KuroBean/SURF-git/my writing/ch 3x postlab 3 - Google Docs.pdf

### Experimental Section

First, the oscilloscope’s channel 2 was connected to the laser module’s sync jack to identify the trigger signal. The horizontal scale was adjusted to 1 us per grid, the voltage scale was autoranged, and was set so the oscilloscope triggers on rising laser module sync voltage so the measurement happens after the laser turns off. Then, the trigger frequency was recorded to be about 1.044 kHz.
Then, the laser and sample holder was set up (as described in diagram below), first to check that we can see the laser turn on and off through scattered laser light. A piece of tape was put on an empty sample tube to do this, and the photodiode detector signal was connected to ch1 of the oscilloscope. A square signal was successfully observed with this method.
The following solutions were mixed using micro-pipettes and stock solutions of 2.5mM Ru(bpy)3, 1.25 methyl viologen dichloride (quencher), and 0.5M of sulfuric acid:

Table 1: volumes of stock solutions needed to create each solution with varying quencher concentrations, along with their total concentrations

Each sample was put in a NMR tube and placed into the laser setup, slightly realigning the angle of the detector such that a “shark fin” pattern is visible. There were also vertical rises and drops due to the reflected laser light entering the detector instead of phosphorescent light, which had to be accounted for by adjusting the detector position.

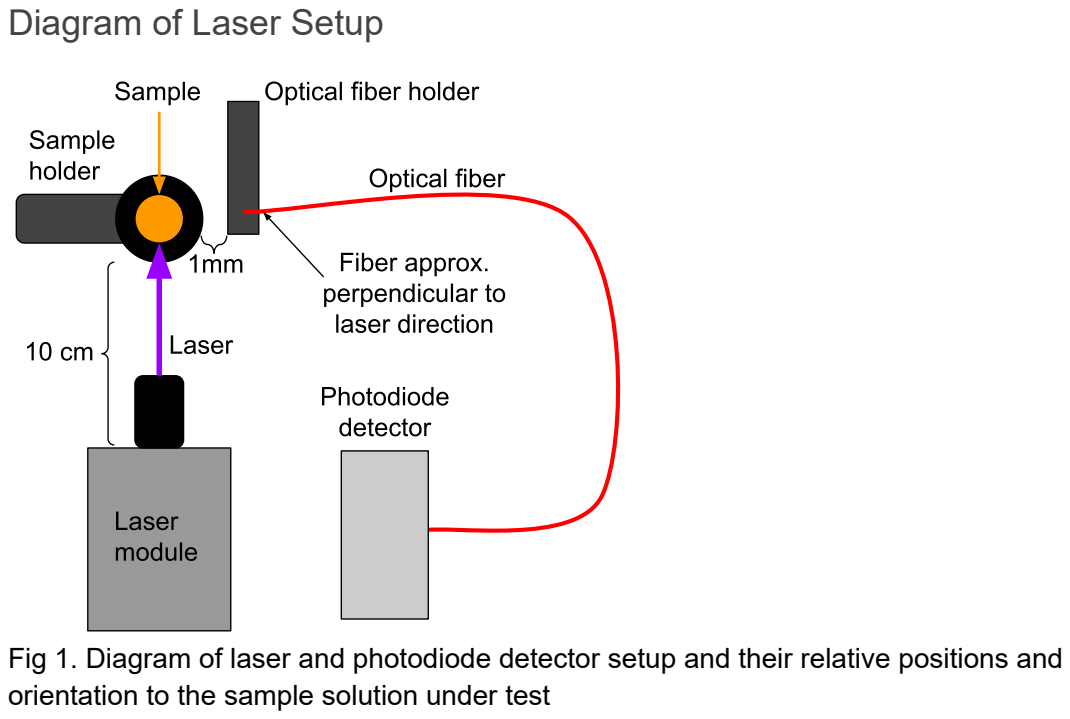
[picture p40: page 2]

Diagram of Laser Setup

Fig 1. Diagram of laser and photodiode detector setup and their relative positions and
orientation to the sample solution under test

### Data Analysis

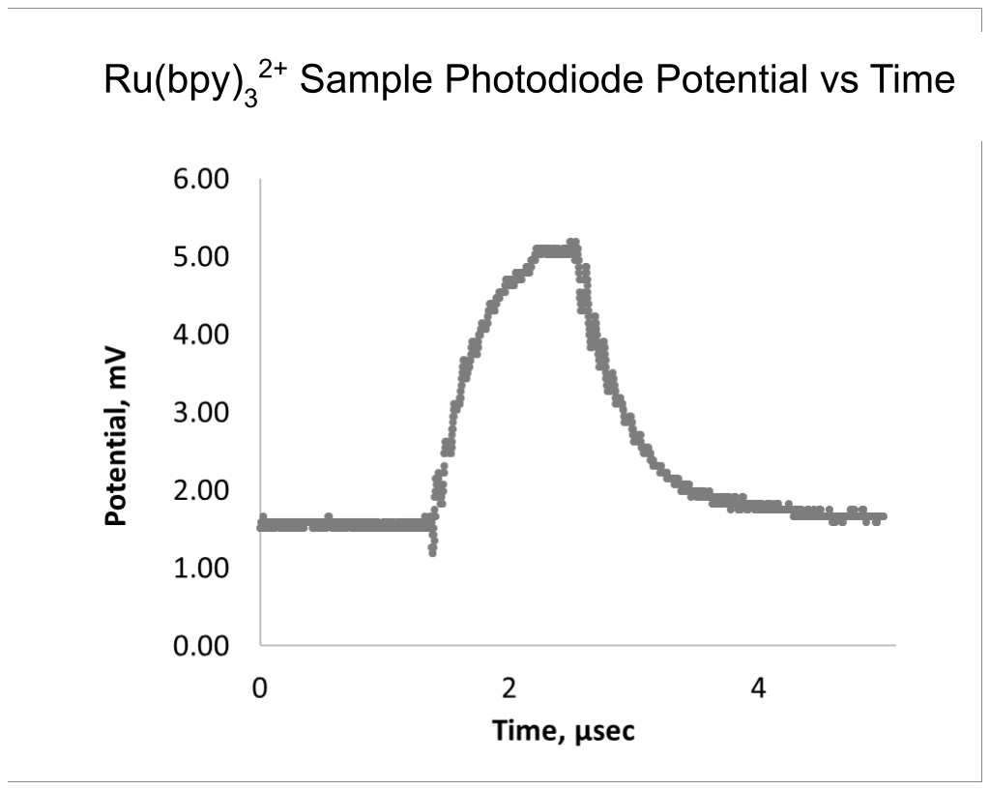
[picture p41: figure]

Fig 2. Phosphorescence over time of a Ru(bpy)3

2+ sample with no quencher exposed to a short burst of laser, where the voltage and time values have been shifted for data analysis purposes such that the minimum voltage is above 1mV and time is positive

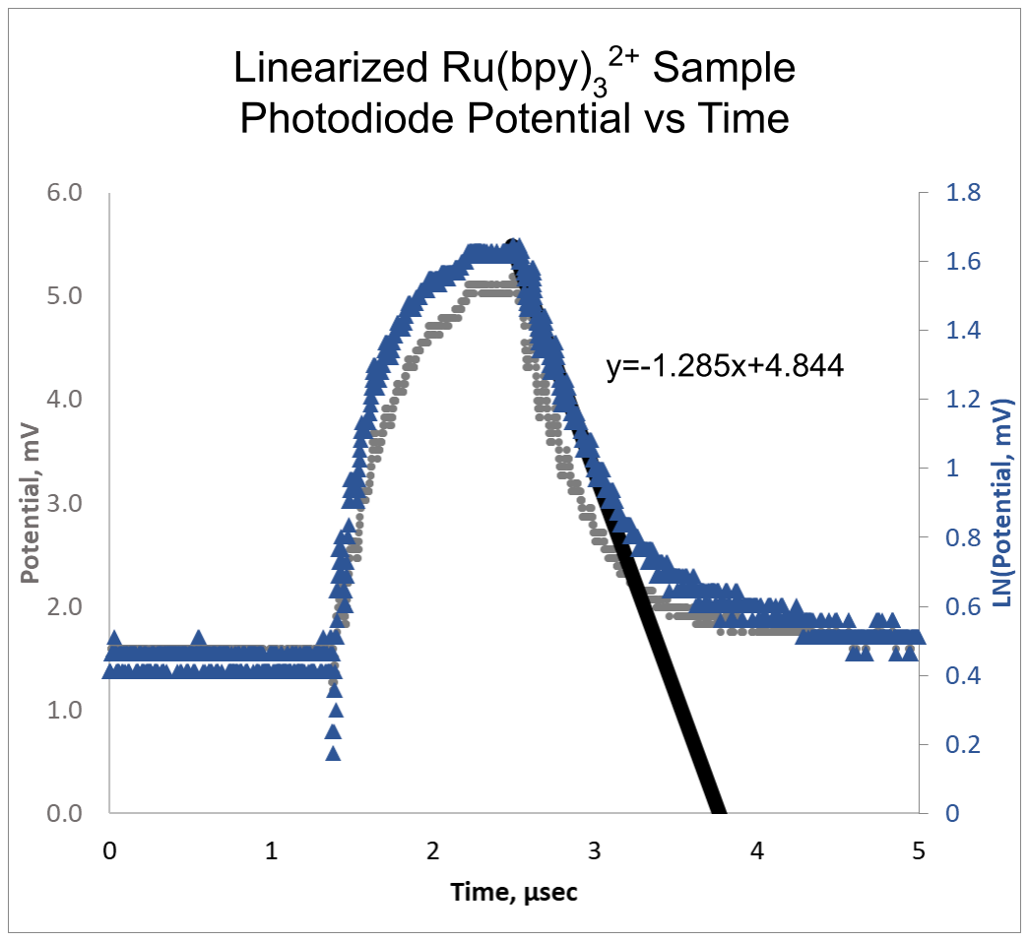
[picture p42: figure]

Fig 3. Phosphorescence over time of a Ru(bpy)3

2+ sample with no quencher, where data from Fig 2. has been transformed with the log function and the originally exponentially decaying segment (now linear) is fit to a line. The negative of the slope is the kobs

, the observed decay
rate, which is 1. 285 ± 0. 015

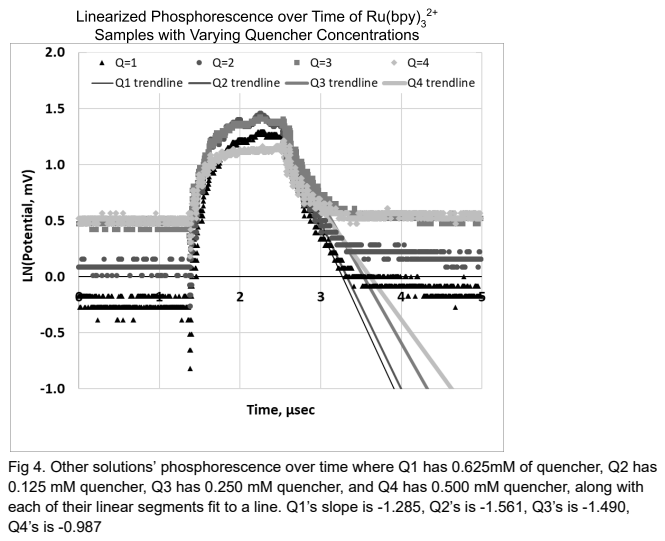
[picture p43: page 4]

Fig 4. Other solutions’ phosphorescence over time where Q1 has 0.625mM of quencher, Q2 has
0.125 mM quencher, Q3 has 0.250 mM quencher, and Q4 has 0.500 mM quencher, along with
each of their linear segments fit to a line. Q1’s slope is -1.285, Q2’s is -1.561, Q3’s is -1.490,

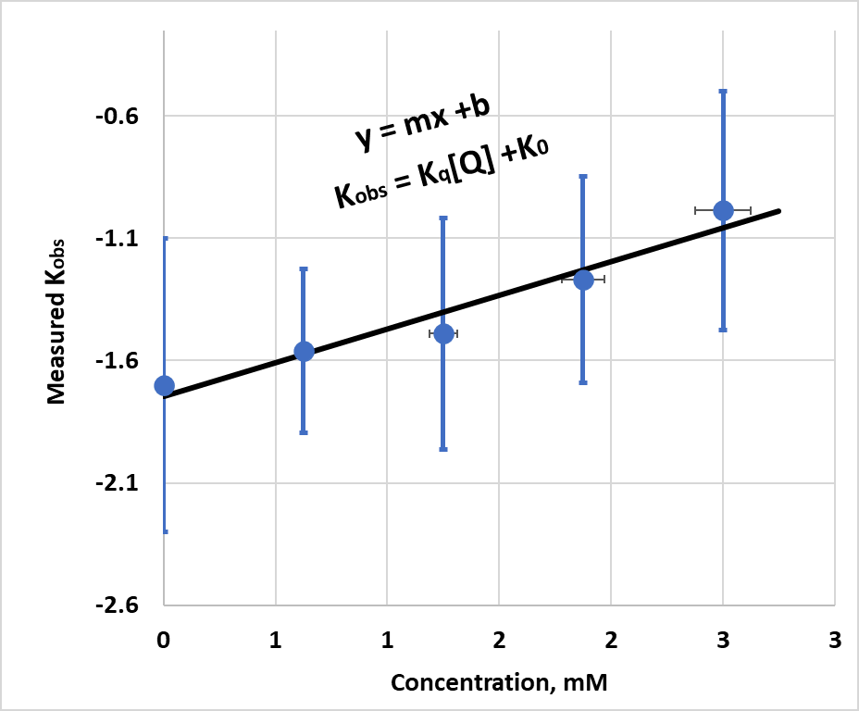
[picture p44: figure]

Fig 5. Kobs vs different quencher concentrations, where kq is 0.142 here
