KuroBean/SURF-git/forms/summer_project_primer.pdf

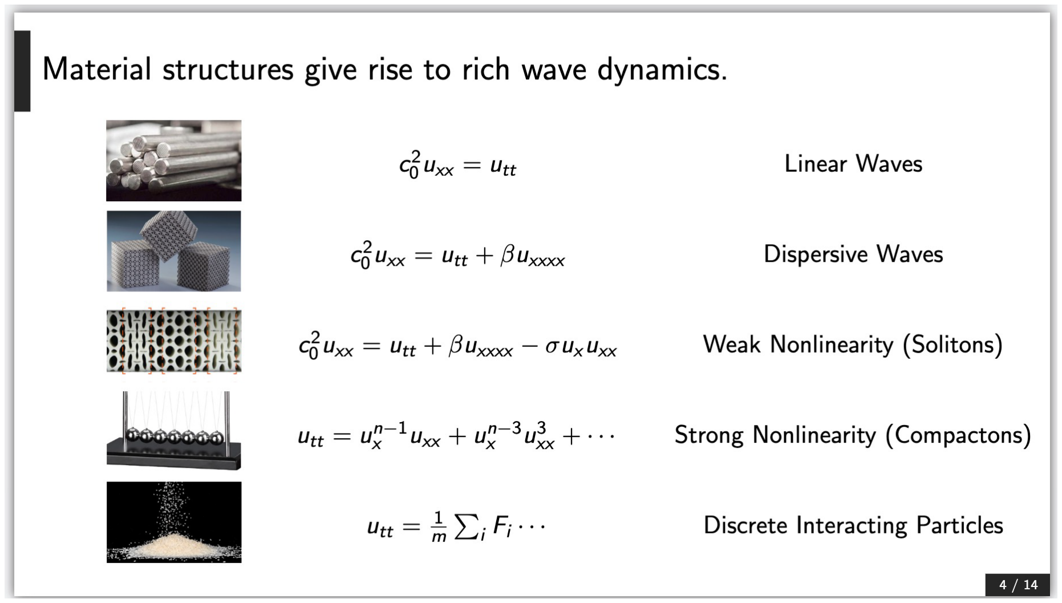
[picture p45: page 1]
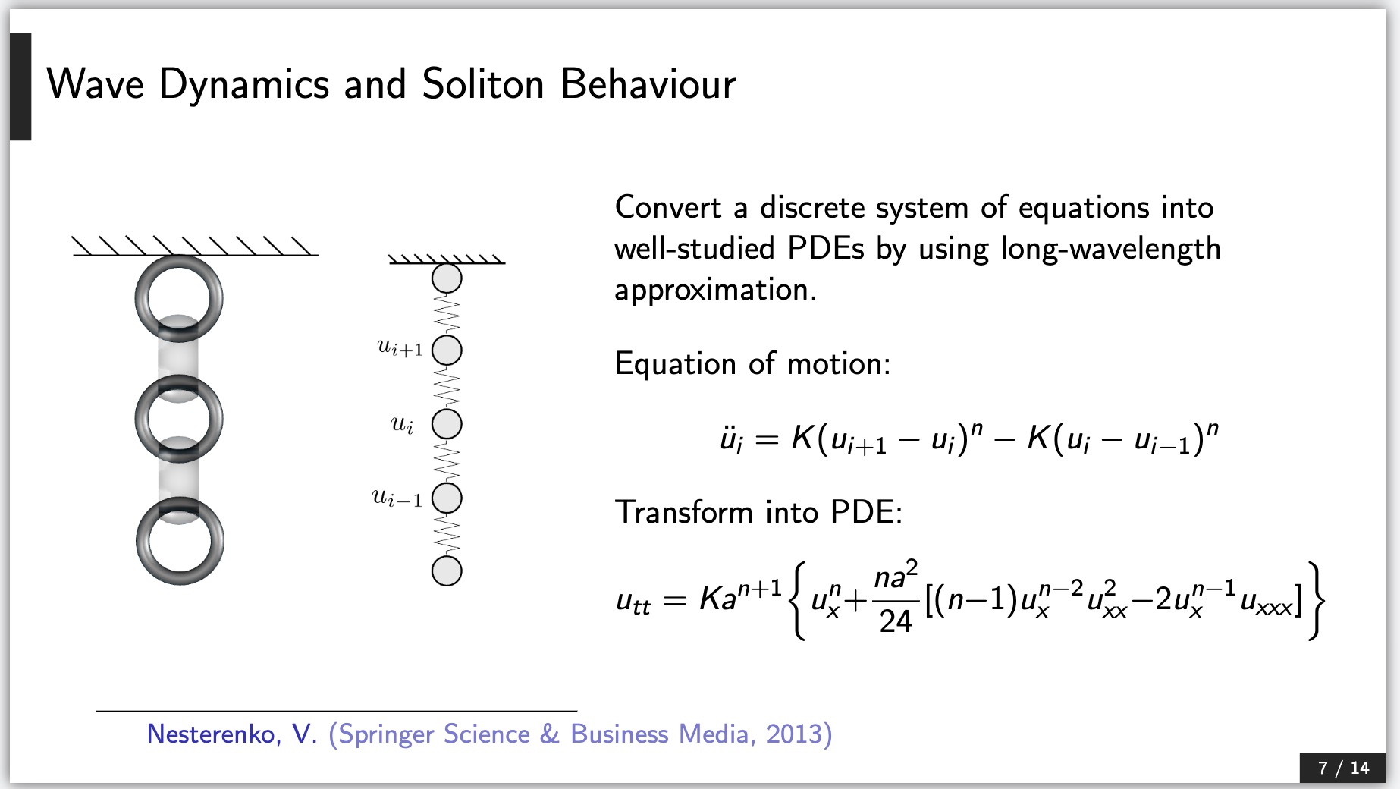
[picture p46: page 2]
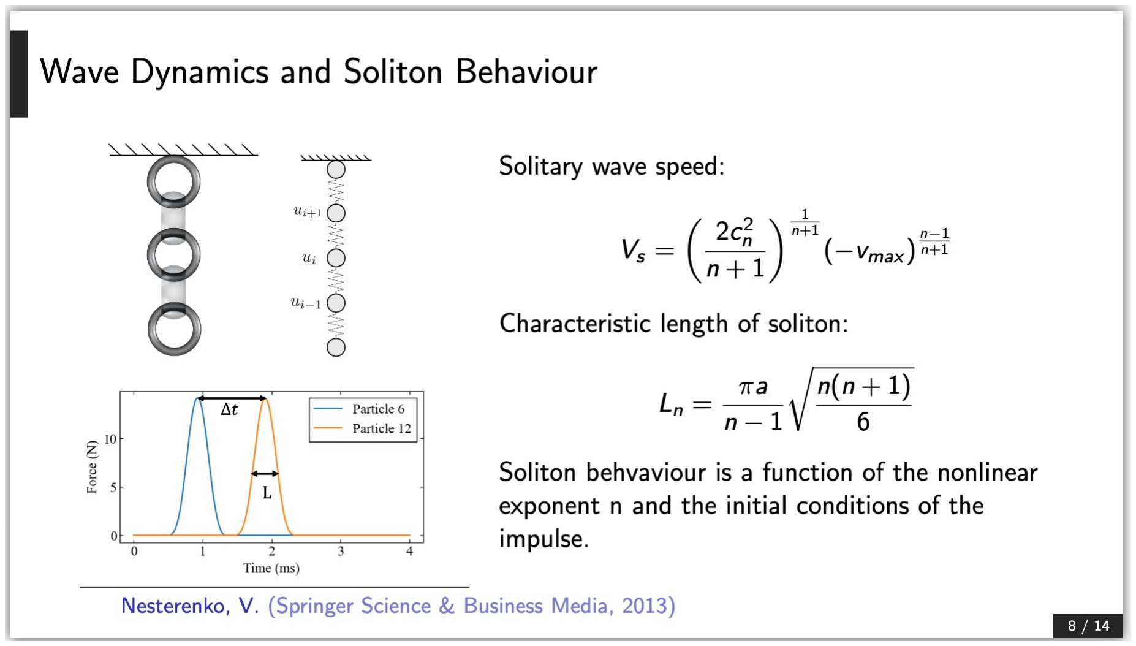
[picture p47: page 3]

# Dynamics in 1D Polycatenated Materials

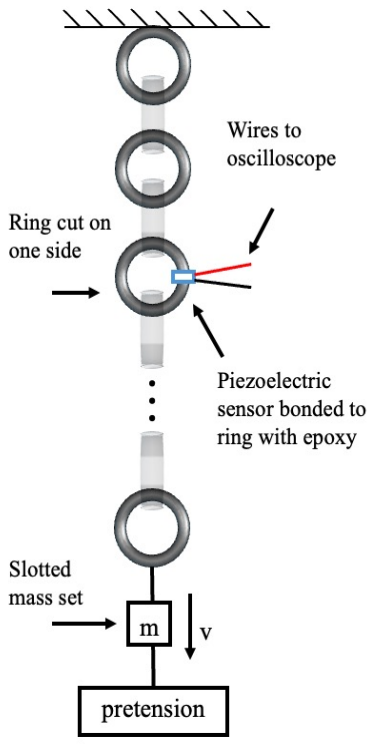
[picture p48: figure]
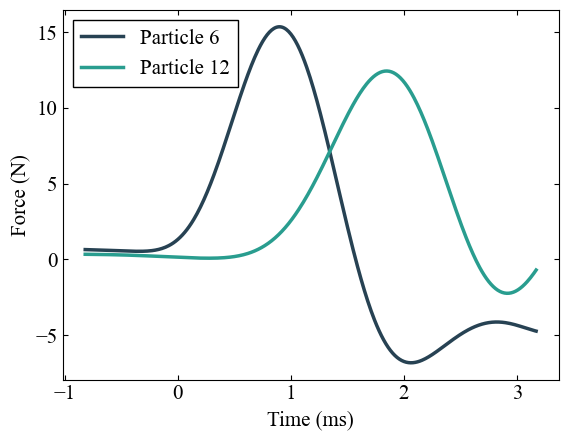
[picture p49: figure]
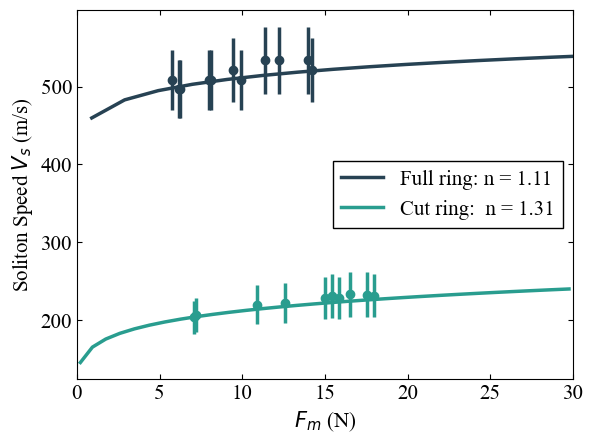
[picture p50: figure]

# Dynamics in 2D Polycatenated Materials

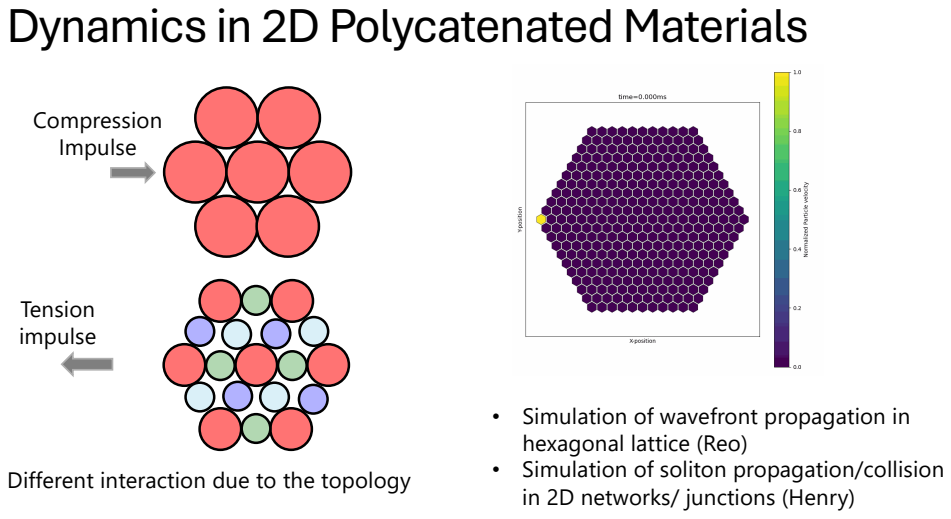
[picture p51: page 5]
Compression Impulse; Tension impulse

• Simulation of wavefront propagation in
hexagonal lattice (Reo)
• Simulation of soliton propagation/collision
in 2D networks/ junctions (Henry)

Different interaction due to the topology

# Dynamics in 2D Polycatenated Materials

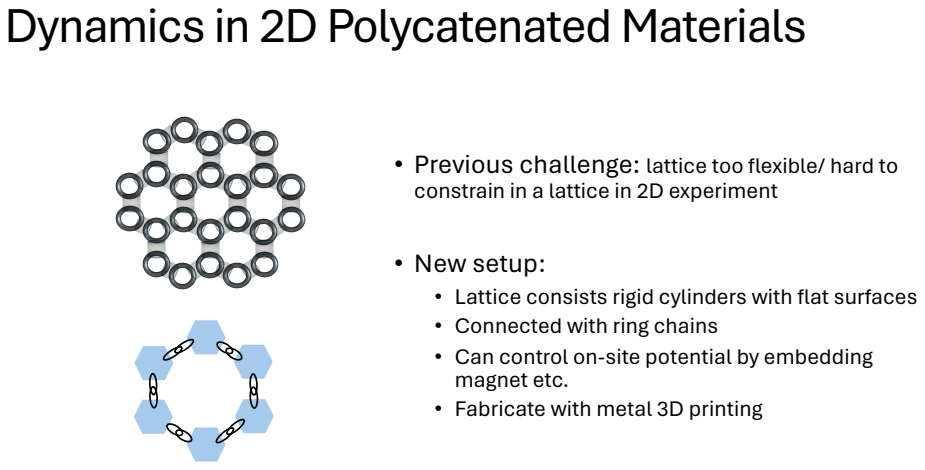
[picture p52: page 6]

• Previous challenge: lattice too flexible/ hard to
constrain in a lattice in 2D experiment

• New setup:
• Lattice consists rigid cylinders with flat surfaces
• Connected with ring chains
• Can control on-site potential by embedding
magnet etc.
• Fabricate with metal 3D printing

# (Naïve) Plan for the Project

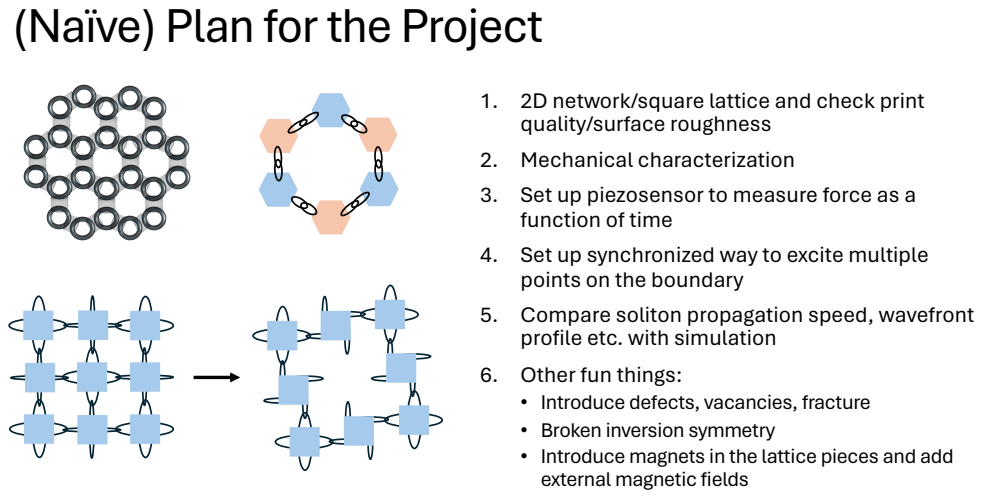
[picture p53: page 7]

1. 2D network/square lattice and check print
quality/surface roughness
2. Mechanical characterization
3. Set up piezosensor to measure force as a
function of time
4. Set up synchronized way to excite multiple
points on the boundary
5. Compare soliton propagation speed, wavefront
profile etc. with simulation
6. Other fun things:
• Introduce defects, vacancies, fracture
• Broken inversion symmetry
• Introduce magnets in the lattice pieces and add
external magnetic fields
