KuroBean/SURF-git/forms/Workplace Specific Safety Checklist '25 KS XX conv.pptx

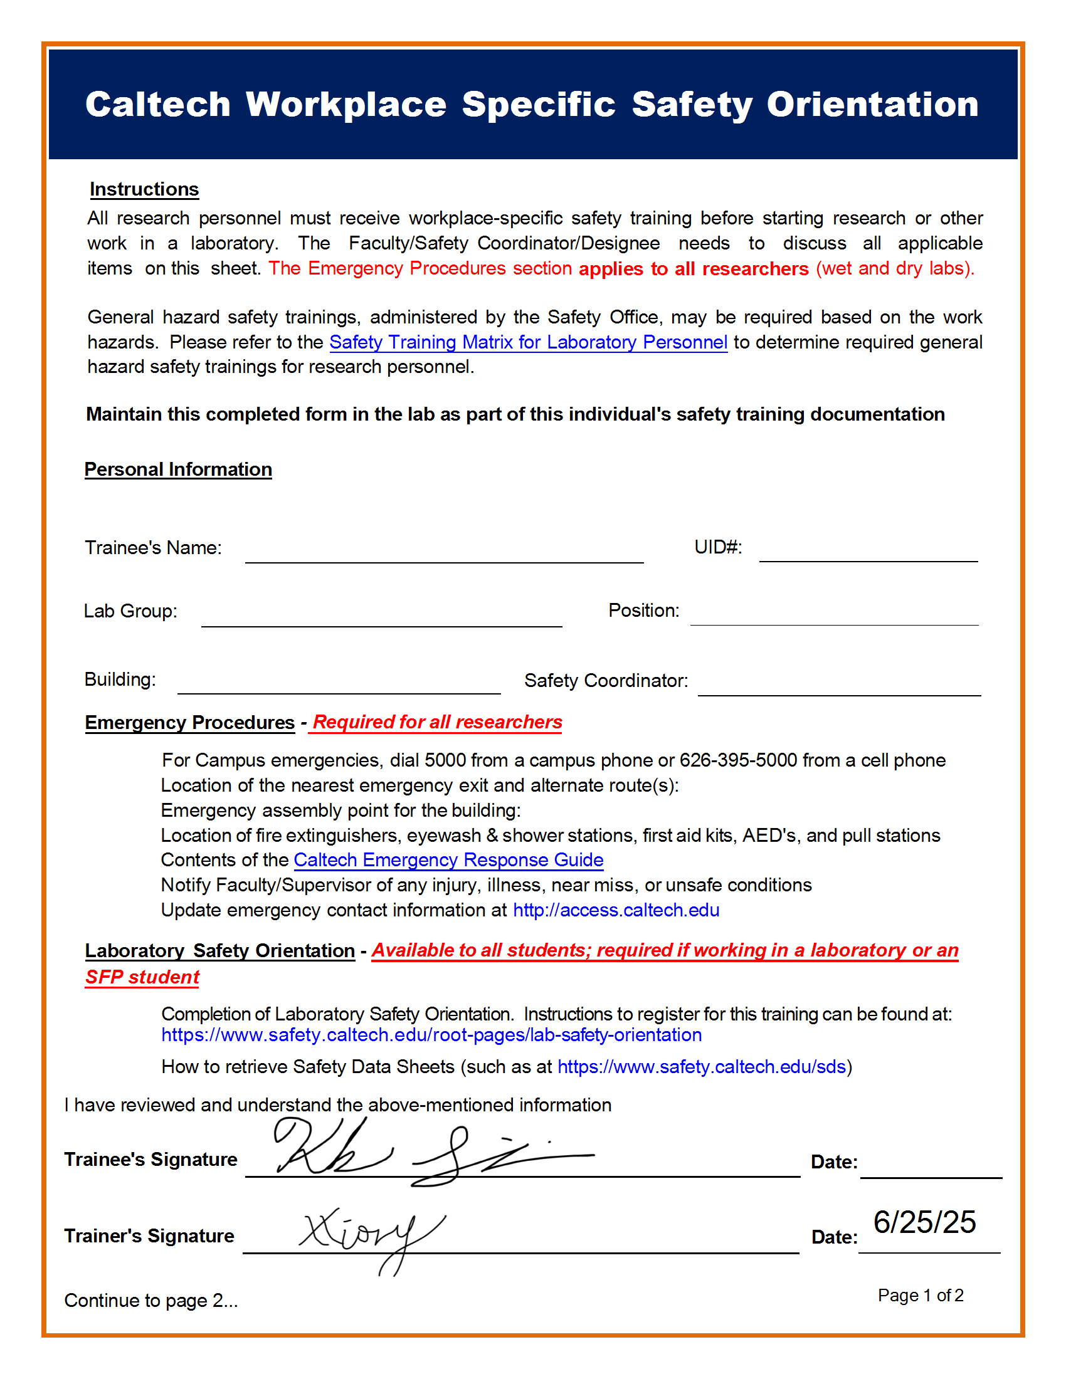
[picture p54: figure]

## Slide 2

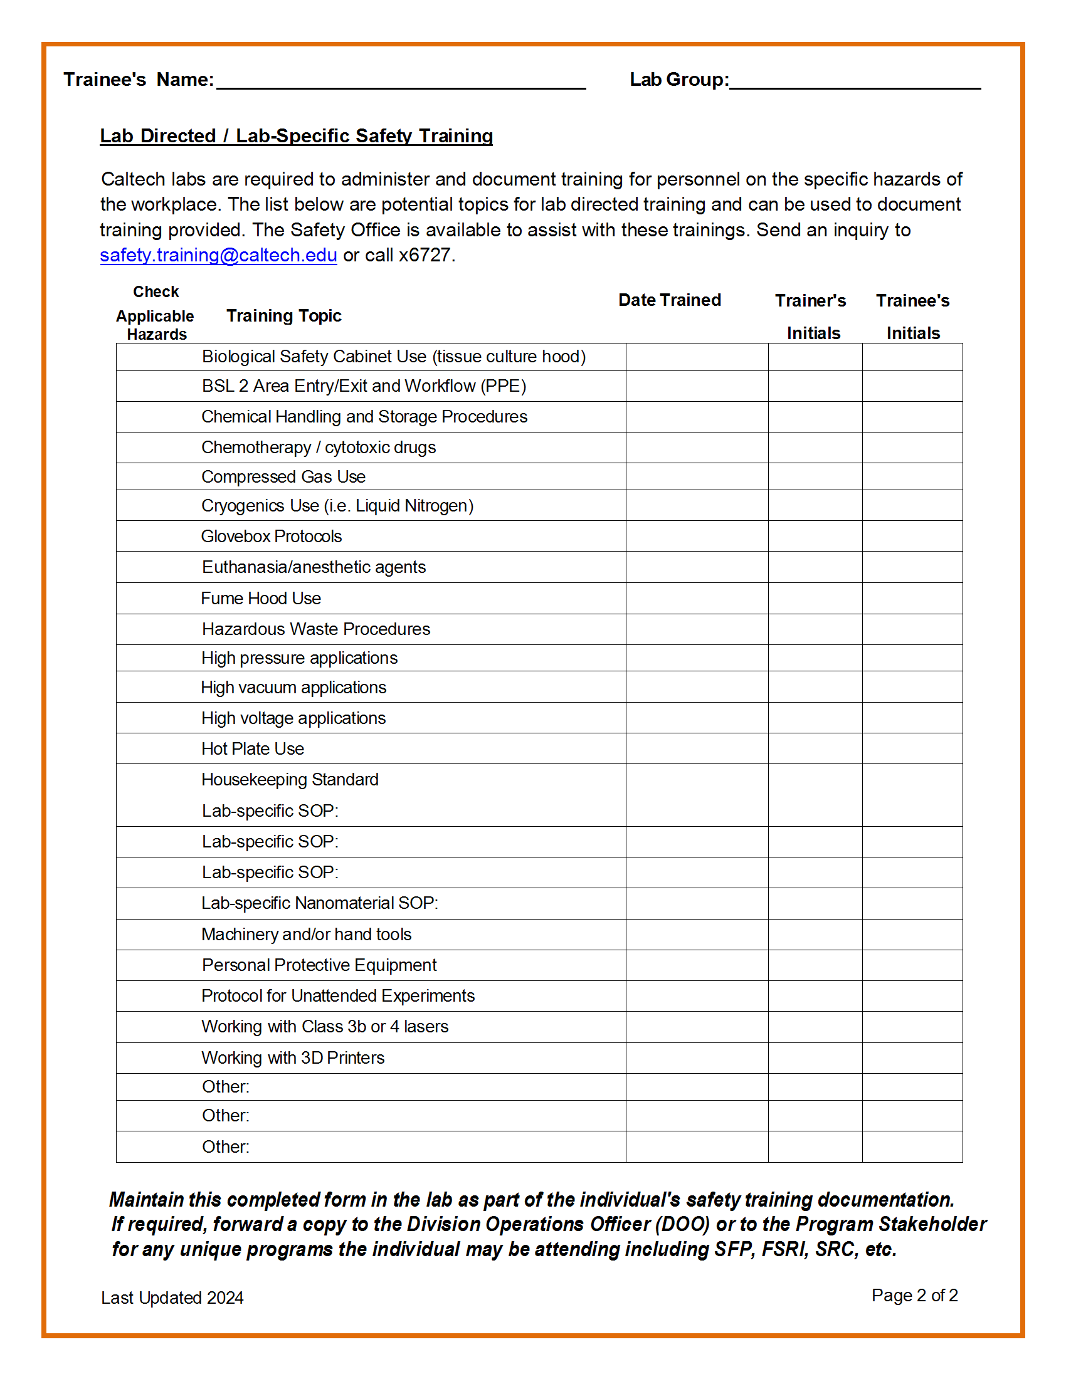
[picture p55: figure]
