KuroBean/SURF-git/SURF Seminar 2025 Experimental Platform for Investigating Dynamics in Polycatenated Architected Materials (PAMs) - Google Slides.pdf

# Experimental Platform for Investigating Dynamics in Polycatenated Architected Materials (PAMs)

## Kensuke Shimojo (Carl F. Braun SURF Fellow) Mentors: Alice Xiong, Prof. Chiara Daraio

Table of Contents ● Background information ○ Motivation and interesting properties ○ Theoretical model ● Experimental Setup and Methods ○ PAM unit design ○ Data collection method ● Experimental Data and Analysis ○ Pulse velocity vs. pretension ○ Pulse velocity vs. excitation amplitude ● Future Directions ○ Junction setup ○ Other modes of actuation

## Polycatenated Architected Materials (PAMs)

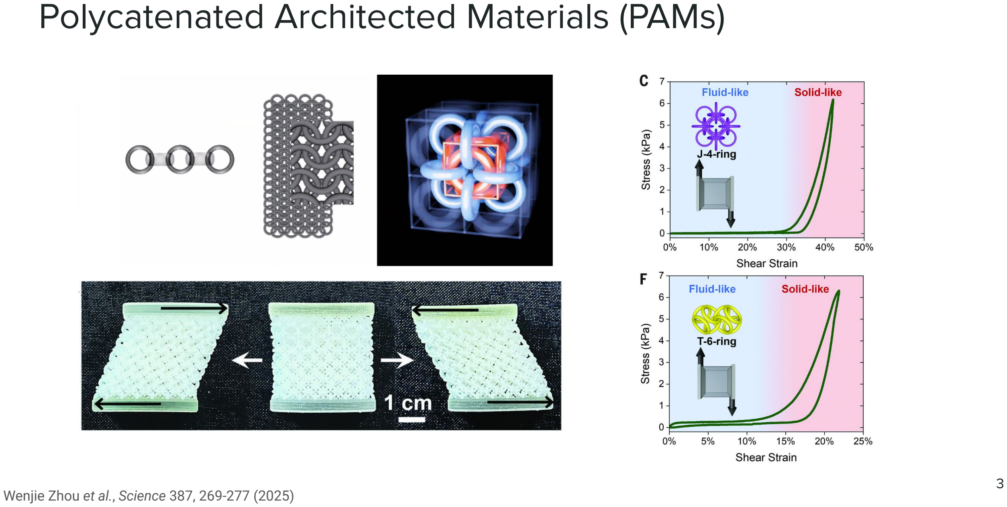
[picture p56: page 3]

Wenjie Zhou et al., Science 387, 269-277 (2025)

## Theory of PAMs: Nonlinear Force vs. Displacement

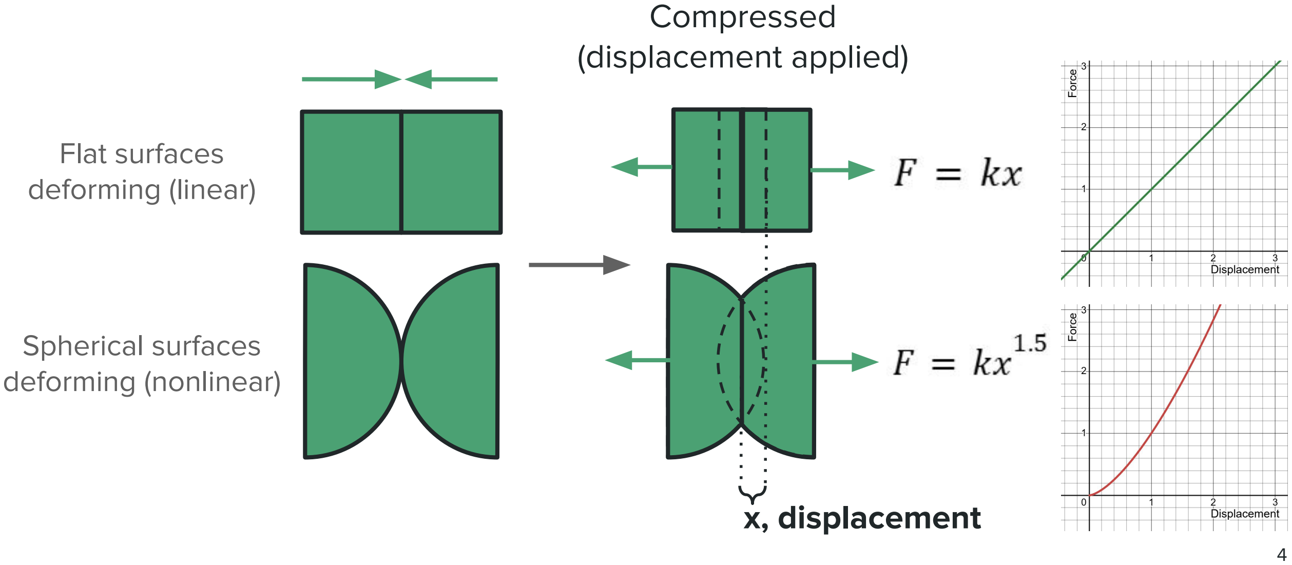
[picture p57: figure]
Compressed (displacement applied); x, displacement; Flat surfaces deforming (linear); Spherical surfaces deforming (nonlinear)

## Theory of PAMs: Nonlinear Springs at Linkages

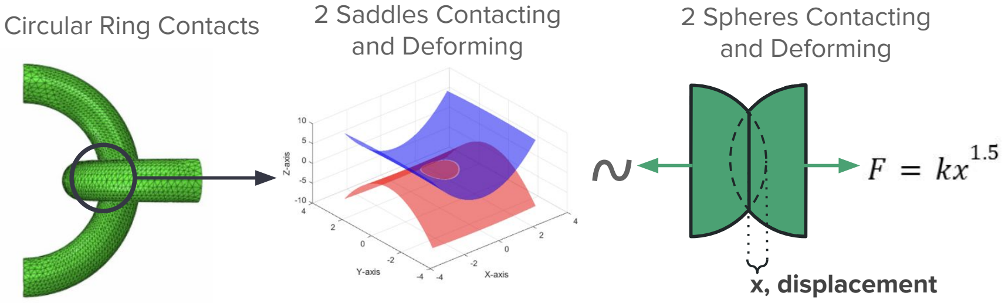
[picture p58: figure]
x, displacement; Circular Ring Contacts; 2 Saddles Contacting; and Deforming; 2 Spheres Contacting and Deforming

## Theory of PAMs: PDE Setup

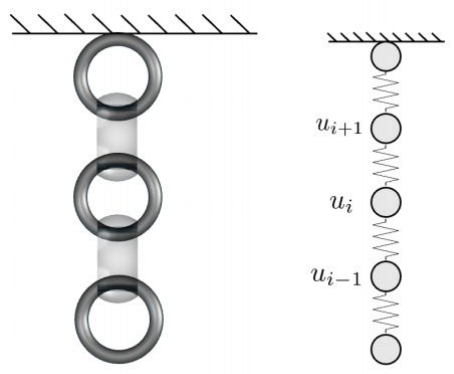
[picture p59: figure]
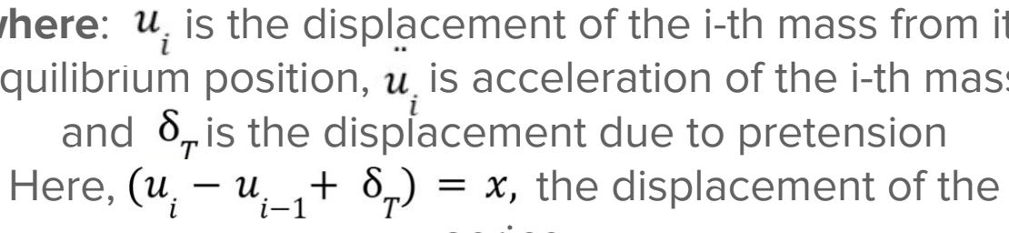
[picture p60: figure]
Here,; the displacement of the

Dynamics of Heterogeneous Materials, Vitali F. Nesterenko, 2001

Treat a linkage between PAM units as a nonlinear spring:

Model the multiple mass-spring system using a system of partial differential equations (PDEs) based on:

where n=1.5 for our case

where: ui | is the displacement of the i-th mass from its
equilibrium position, | is acceleration of the i-th mass,
and | is the displacement due to pretension

spring

## Theory of PAMs: Solitary Wave Solutions

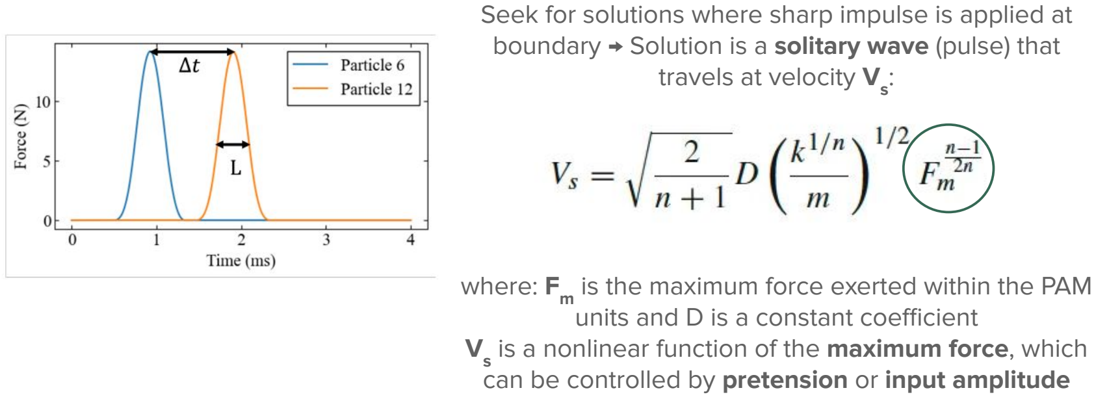
[picture p61: figure]
where: F m; units and D is a constant coefficient; travels at velocity V s

Dynamics of Heterogeneous Materials, Vitali F. Nesterenko, 2001 is the maximum force exerted within the PAM

is a nonlinear function of the maximum force, which can be controlled by pretension or input amplitude

Seek for solutions where sharp impulse is applied at boundary → Solution is a solitary wave (pulse) that

## Goal of SURF

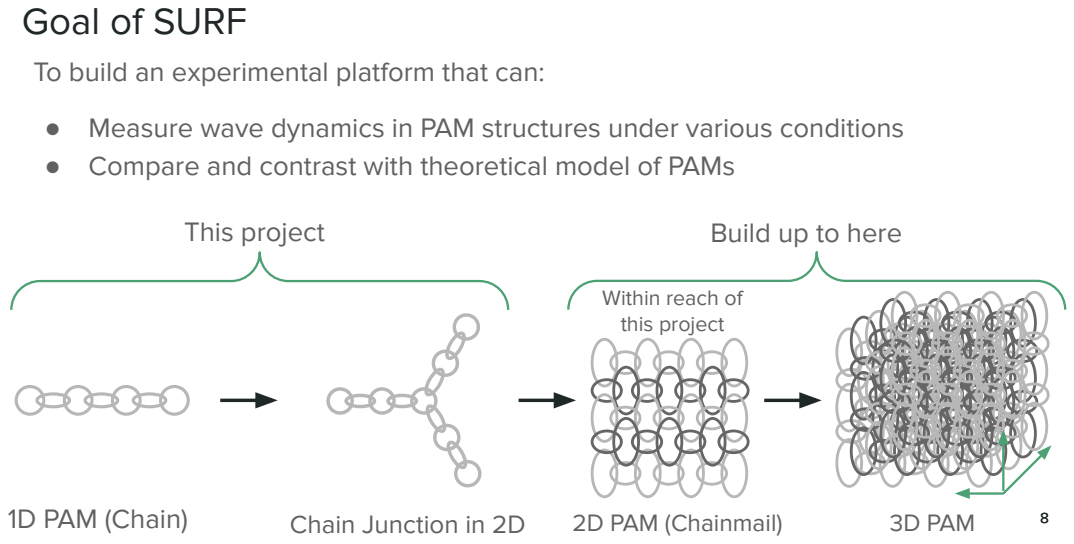
[picture p62: page 8]
This project; Build up to here; 1D PAM (Chain); Chain Junction in 2D; 2D PAM (Chainmail); 3D PAM

To build an experimental platform that can:

● Measure wave dynamics in PAM structures under various conditions
● Compare and contrast with theoretical model of PAMs

Within reach of
this project

# General Idea of the Setup

## Experimental Setup Diagram

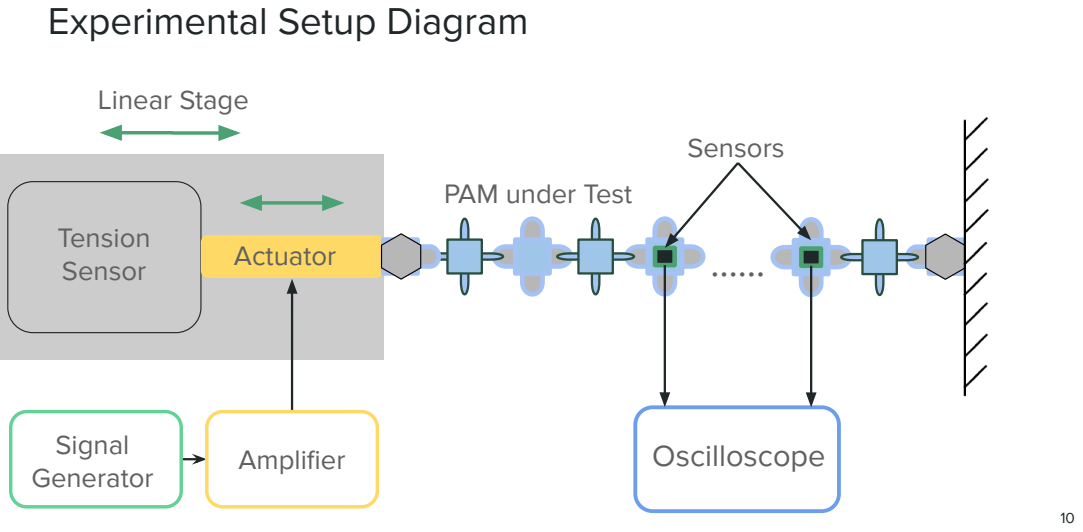
[picture p63: page 10]
Actuator; Linear Stage; Sensors; Oscilloscope Signal; Generator; Amplifier; Tension; Sensor

PAM under Test

## Actual Setup

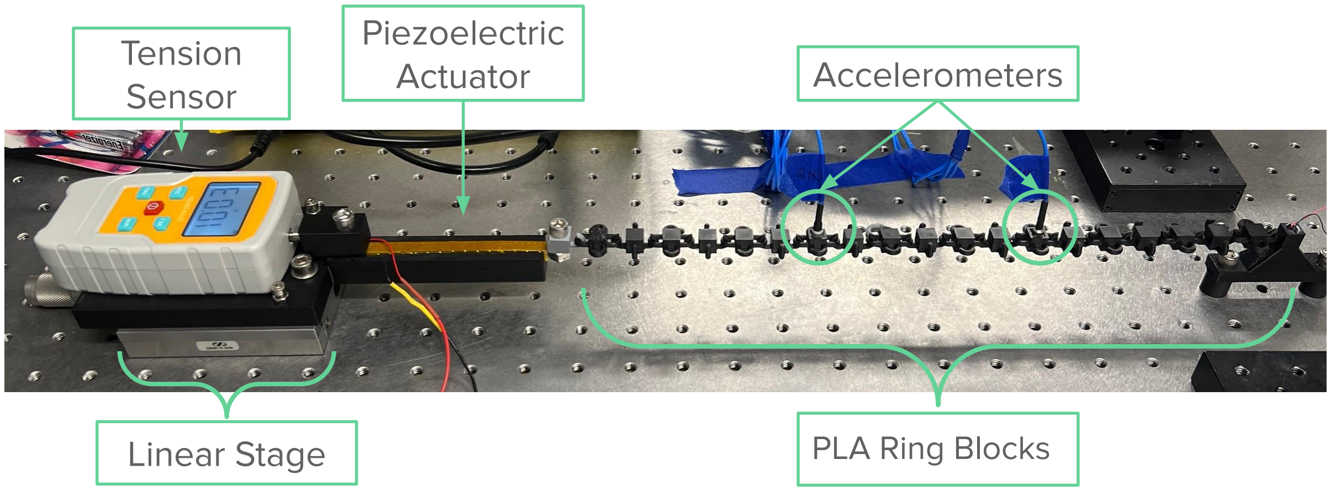
[picture p64: figure]
Linear Stage; PLA Ring Blocks; Accelerometers; Piezoelectric Actuator Tension Sensor

## PAM Unit Cell: Ring Blocks

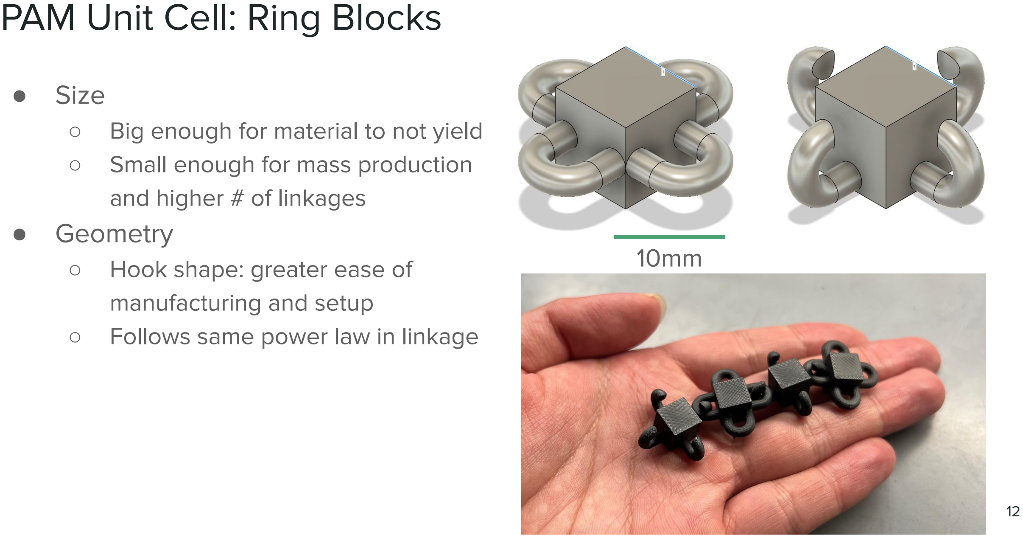
[picture p65: page 12]

- Size
- Big enough for material to not yield
- Small enough for mass production and higher # of linkages
- Geometry
- Hook shape: greater ease of manufacturing and setup
- Follows same power law in linkage

10mm

## PAM Unit Cell: Testing

- Tensile test on 2 linked blocks (1 ring contact)
- PLA link shows F = kx¹.5 relationship: nonlinear spring as desired from linkage

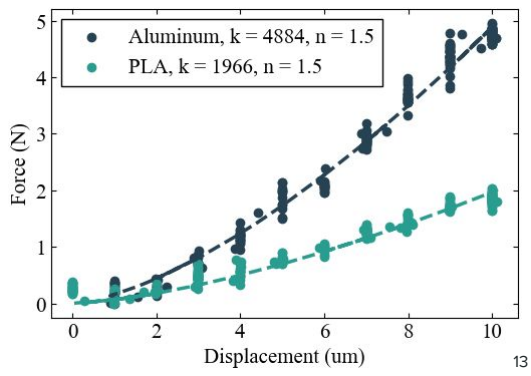
[picture p66: figure]
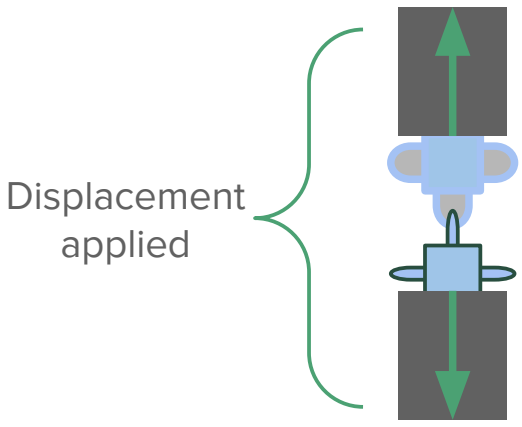
[picture p67: figure]
Displacement applied

Force exerted by
linkage measured

## PAM Unit Cell: Ring Blocks ~ Rings

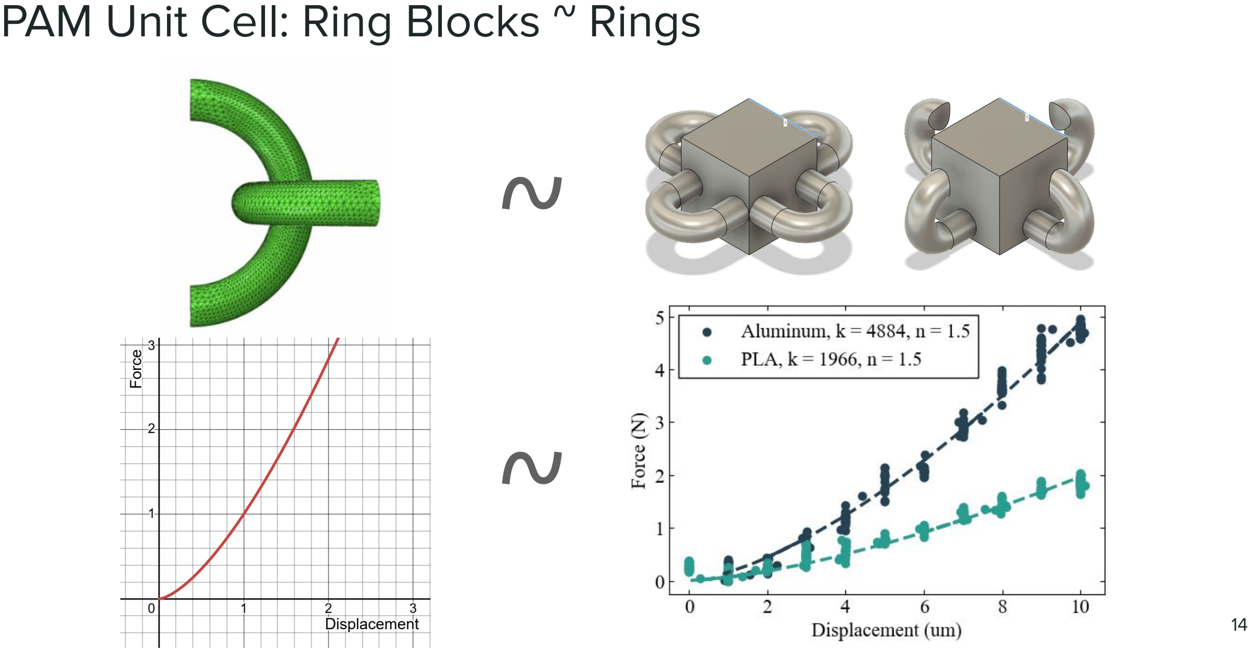
[picture p68: page 14]

~

~

## Collecting Data from Accelerometer

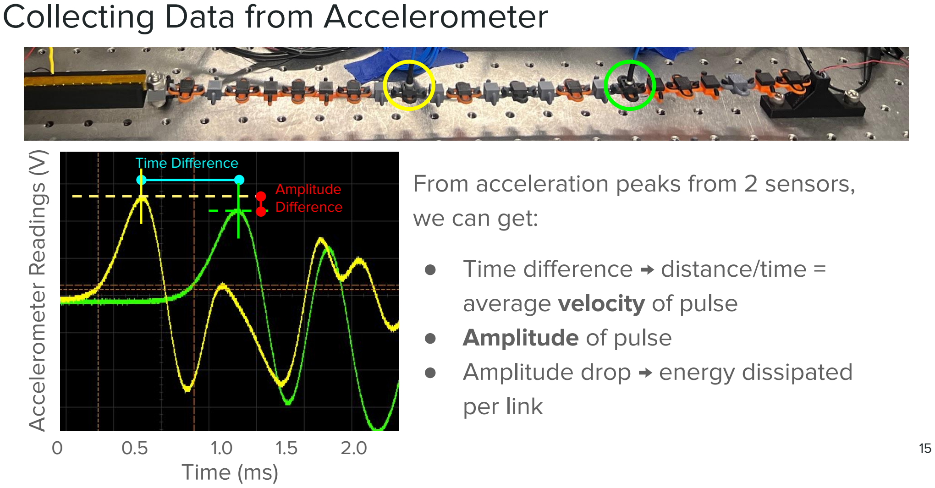
[picture p69: page 15]

From acceleration peaks from 2 sensors, we can get:

- Time difference → distance/time = average velocity of pulse
- Amplitude of pulse
- Amplitude drop → energy dissipated per link

Time (ms)

Accelerometer Readings (V)

15

Time Difference

Amplitude
Difference
0 | 0.5 | 1.0 | 1.5 | 2.0

## Experimental Setup

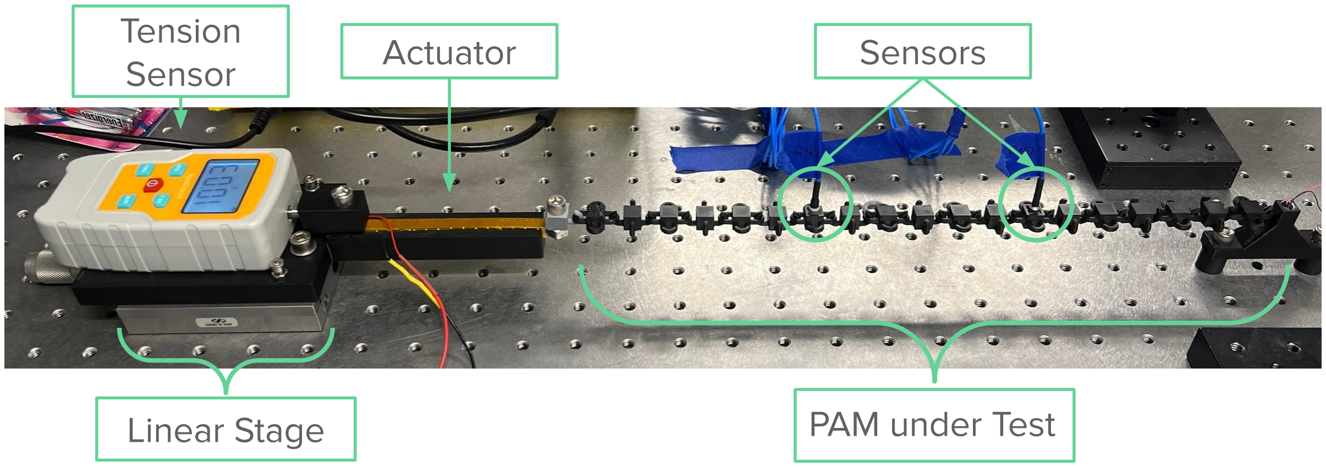
[picture p70: figure]
Linear Stage; PAM under Test; Actuator; Sensors Tension; Sensor

# Velocity vs. Pretension Experiment

## Hypothesis and Setup

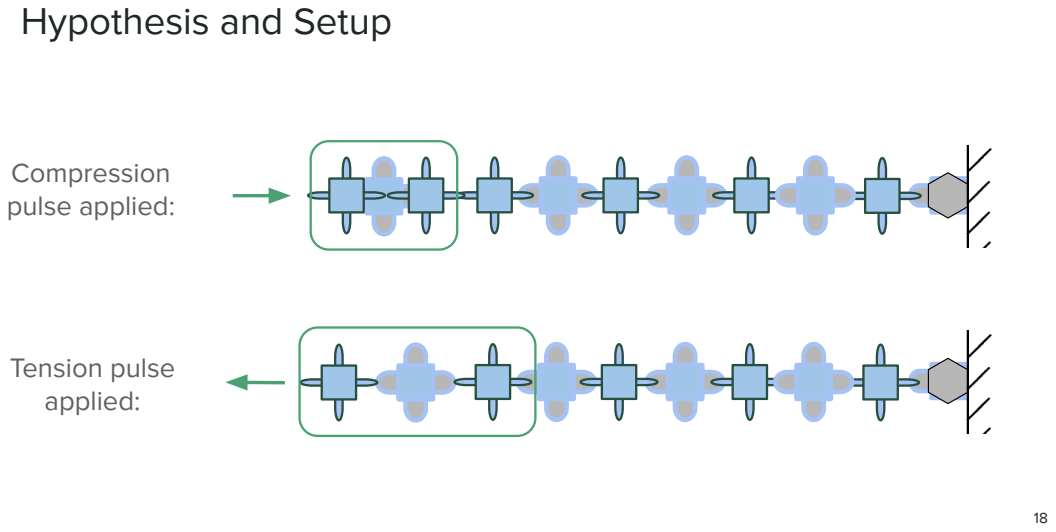
[picture p71: page 18]
Compression pulse applied:; Tension pulse applied:

## Hypothesis and Setup

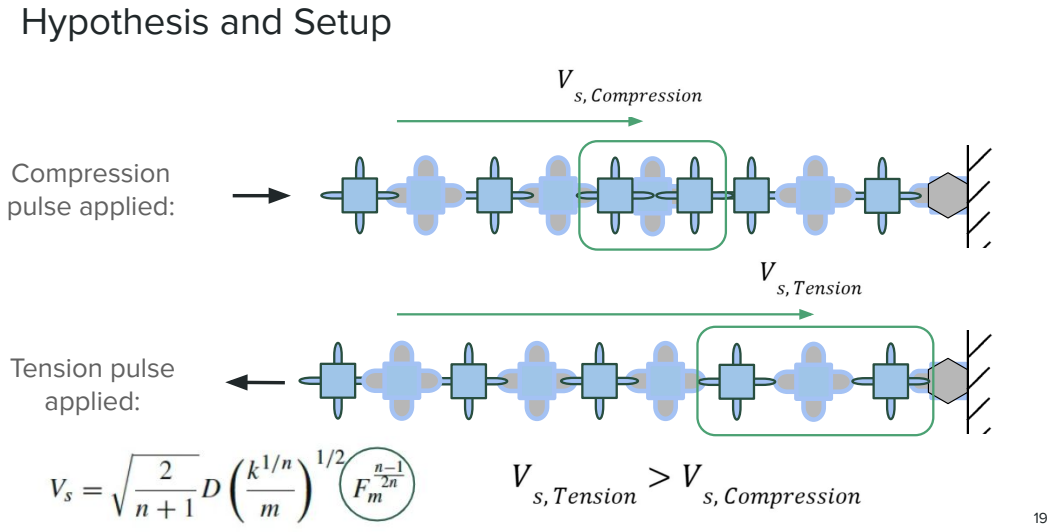
[picture p72: page 19]
Compression pulse applied:; Tension pulse applied:

## 1D Chain: Solitary Wave Velocity vs Pretension

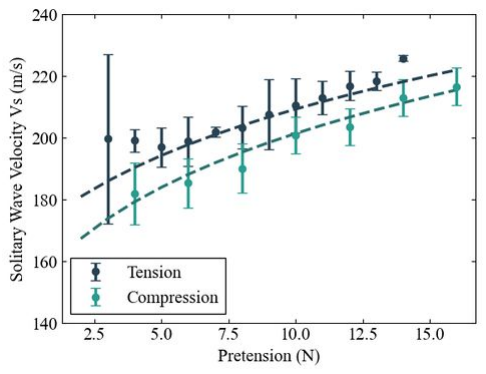
[picture p73: figure]

- Fix input amplitude, vary
pretension
- Small impulses sent
parallel (tension) and
anti-parallel (compression) with existing pretension
- Tension pulse is slightly faster than compression
pulse

# Velocity vs. Amplitude Experiment

## 1D Chain: Solitary Wave Velocity vs Amplitude

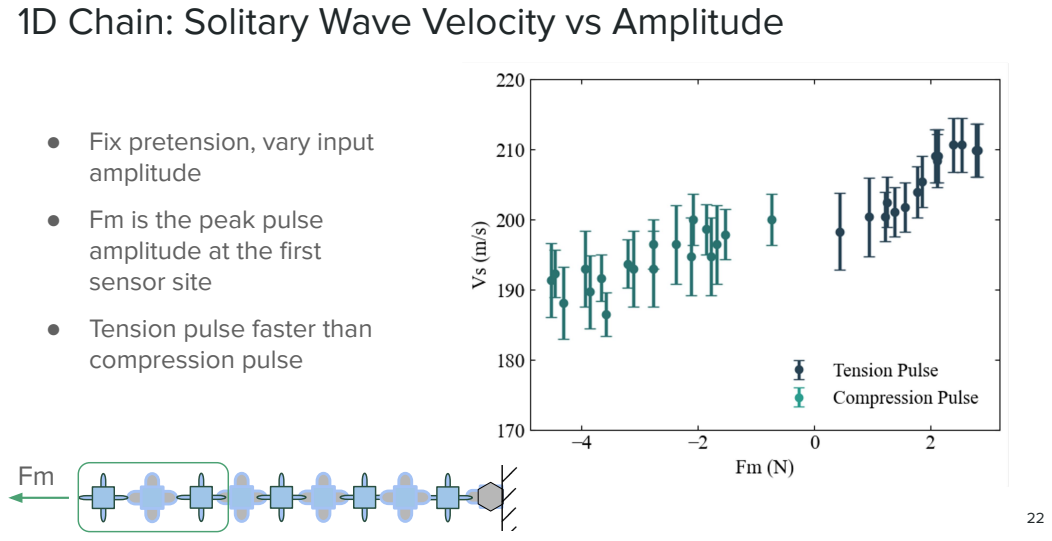
[picture p74: page 22]

● Fix pretension, vary input
amplitude
● Fm is the peak pulse
amplitude at the first
sensor site
● Tension pulse faster than
compression pulse

# Next Steps

## Next Steps: Improvements

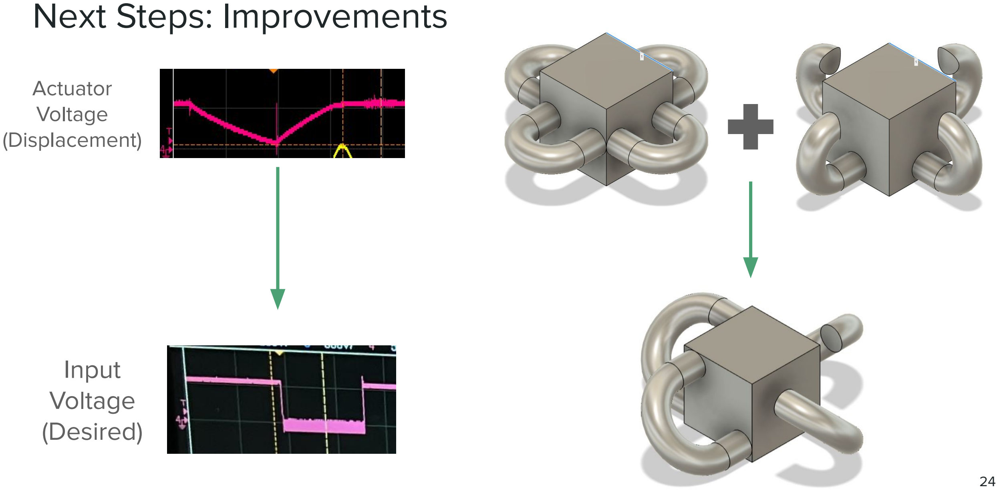
[picture p75: page 24]

Actuator
Voltage
(Displacement)

Input
Voltage
(Desired)

NEW BLOCK

Next Steps cont.

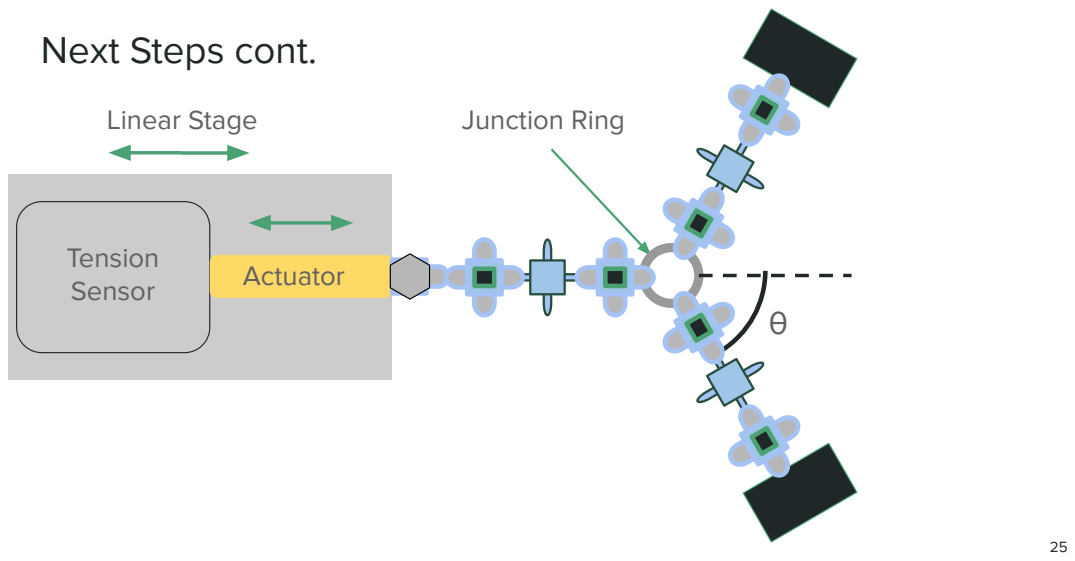
[picture p76: page 25]
Junction Ring; Actuator; Linear Stage; Tension Sensor

## Junction Setup

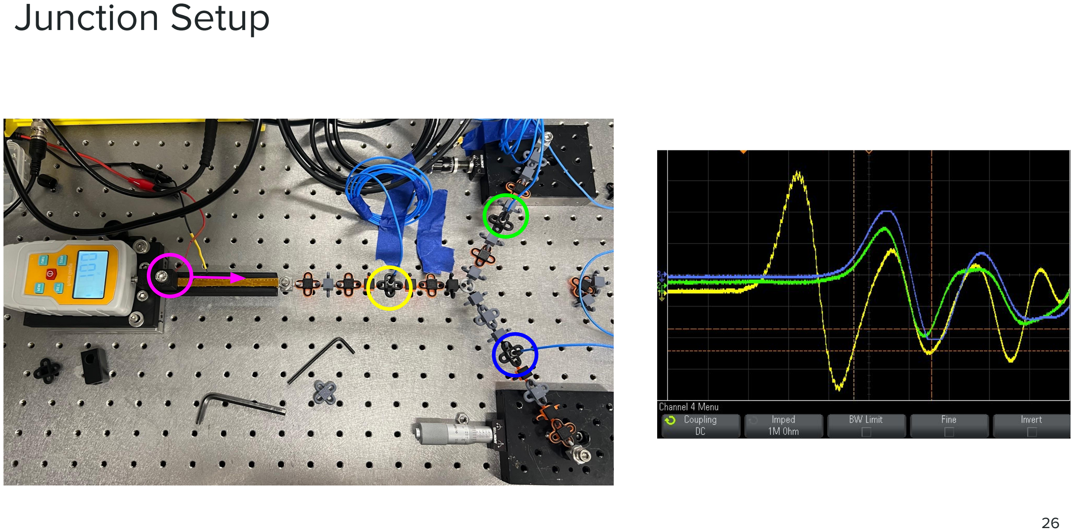
[picture p77: page 26]

Next Steps Cont.

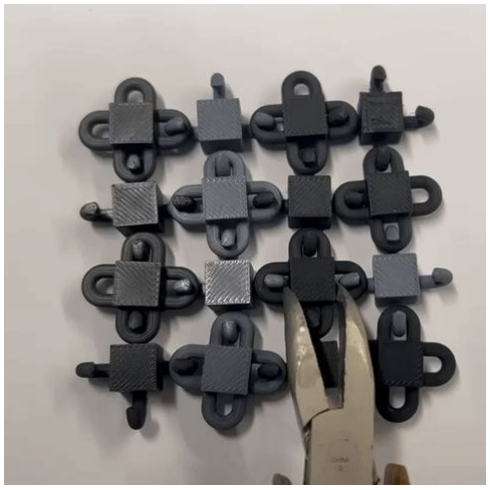
[picture p78: figure]

- Different PAM linkages
- Mix and mash of different material units
- Different modes of actuation and pulses
- Test other waveform inputs (sinusoid, Gaussian, sech^2, etc.)

## Conclusions

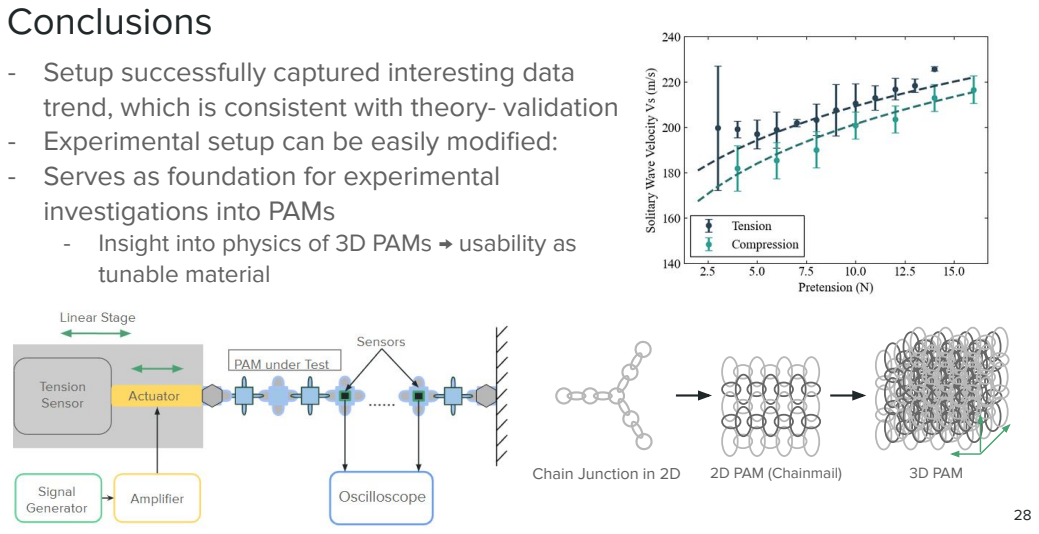
[picture p79: page 28]
Chain Junction in 2D; 2D PAM (Chainmail); 3D PAM

- Setup successfully captured interesting data
trend, which is consistent with theory- validation
- Experimental setup can be easily modified:
- Serves as foundation for experimental
investigations into PAMs
- Insight into physics of 3D PAMs → usability as
tunable material

## Acknowledgements

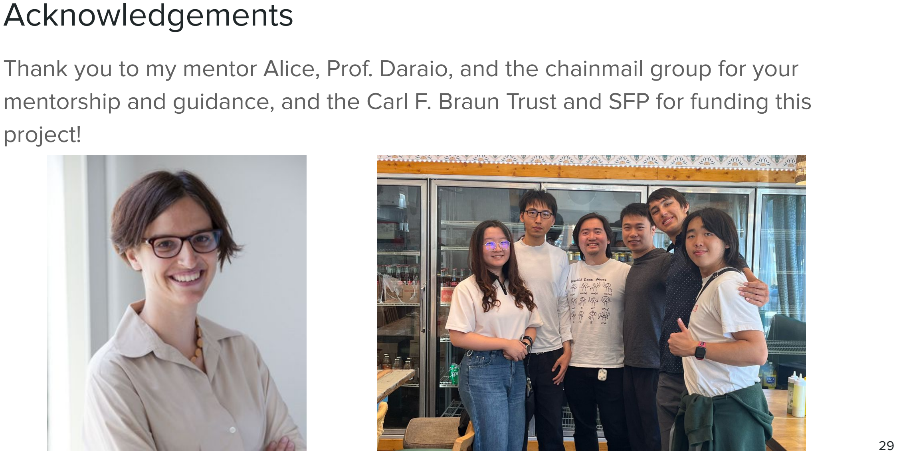
[picture p80: page 29]

Thank you to my mentor Alice, Prof. Daraio, and the chainmail group for your mentorship and guidance, and the Carl F. Braun Trust and SFP for funding this project!

(IMAGES)

## Feedback Form

### Name: Kensuke Shimojo

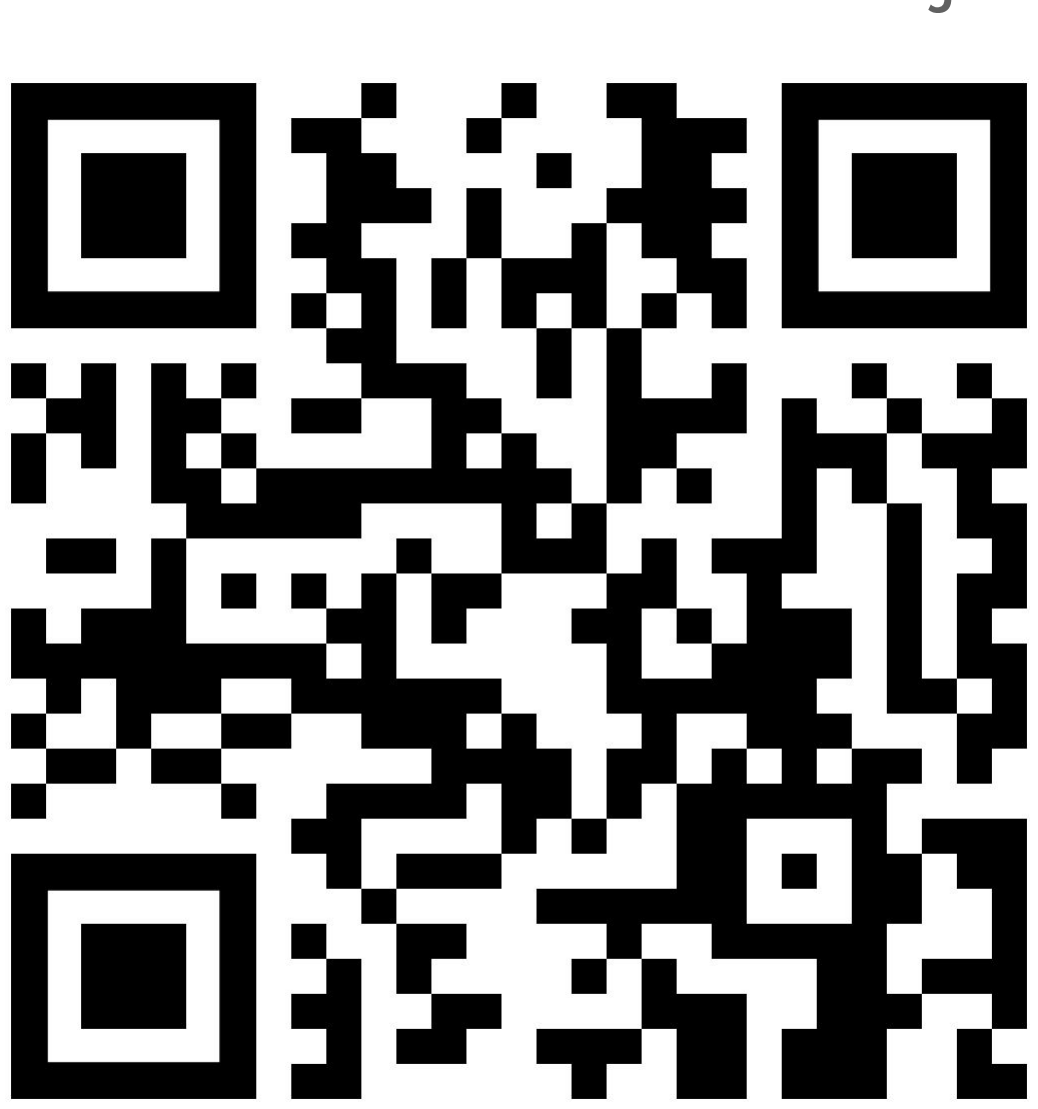
[picture p81: figure]

## Thank you for listening!

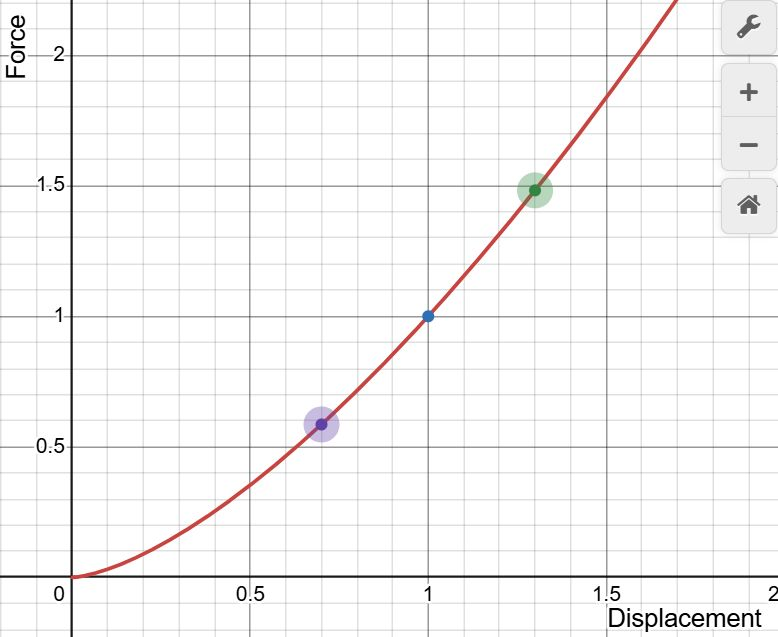
[picture p82: figure]
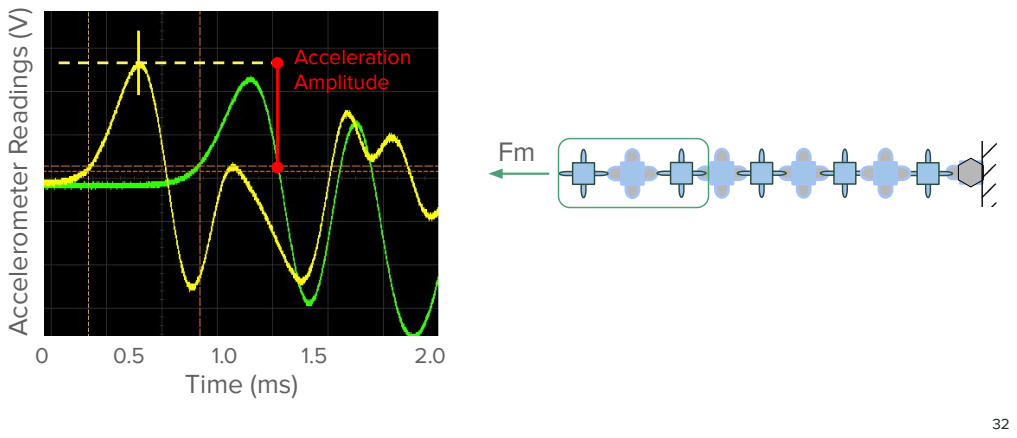
[picture p83: page 32]
Time (ms); Accelerometer Readings (V); Acceleration Amplitude

## PAM Unit Cell: Materials

Material | Total Price | Lead Time | Yield Strength (MPa)

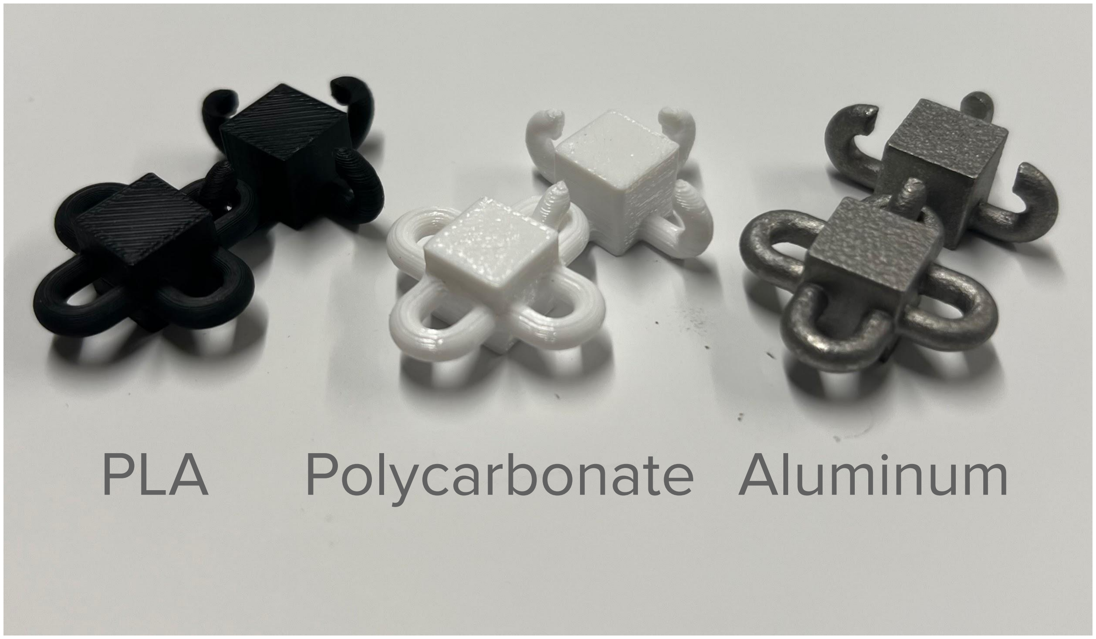
[picture p84: figure]
PLA; Polycarbonate Aluminum

PLA (printed on campus) | Few cents -few dollars | 2-6 hours | 30-60
Nylon | $37.49 | 6-10 days | 40-70
Aluminum | $79.75 | 6-10 days | ~240
SS | $62.78 | 6-10 days | 40-95
Polycarbonate | $34.06 | 7-13 days | ~60
Glass filled nylon | $54.85 | 15 days | 230-300

## Piezoelectric Actuator

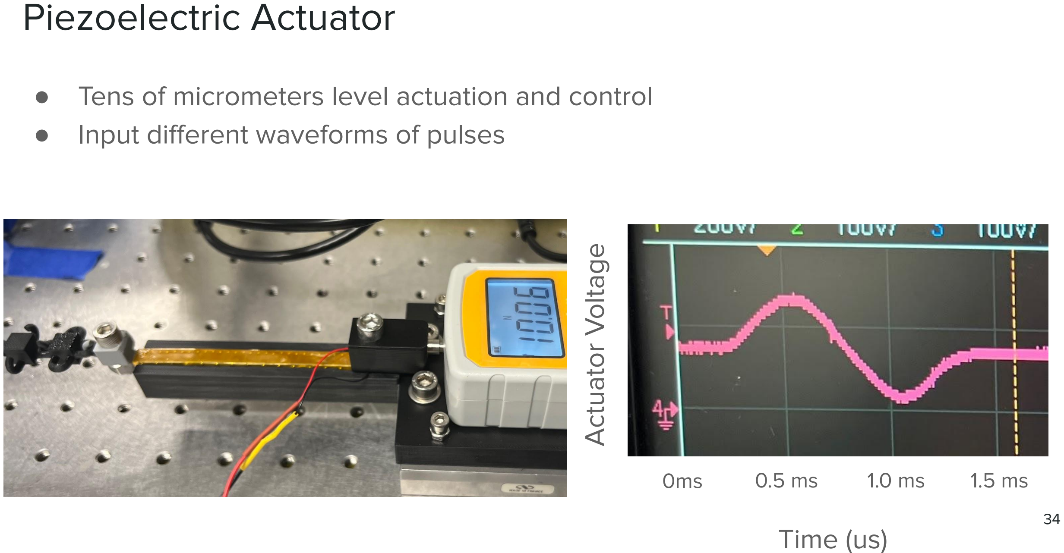
[picture p85: page 34]

- Tens of micrometers level actuation and control
- Input different waveforms of pulses

Actuator Voltage

0.5 ms

Time (us)

0ms | 1.0 ms | 1.5 ms

## Accelerometer vs. Ceramic Piezo Force Sensor

| Triaxial Accelerometer | Piezo Force Sensor
Measured Quantity | Acceleration | Quickly Changing Compression or Tension Force
Dimensions of Measurement | 3 | 1
Calibration | Precalibrated | Needs Calibration

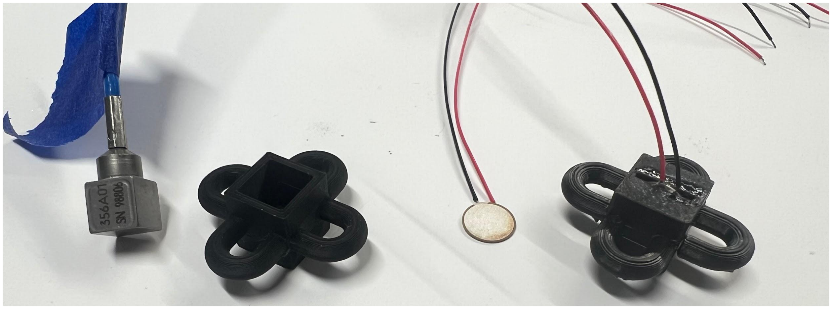
[picture p86: figure]

## Accelerometer vs. Ceramic Piezo Force Sensor

Triaxial Accelerometer:

- Measures acceleration in each dimension
- 3 dimensions
- Useful for other modes of wave pulses
- Better for 2D case (eventually)
- Precalibrated

Piezo Force Sensor:

- Approximately measures
compressional or tensile force
- But constant offset issue is present, may be inconsistent
- Calibration curve needed
| Triaxial Accelerometer | Piezo Force Sensor
Measured Quantity | Acceleration | Quickly Changing Compression or Tension Force

Dimensions of
Measurement

3 1

## Tension Sensor + Linear Stage

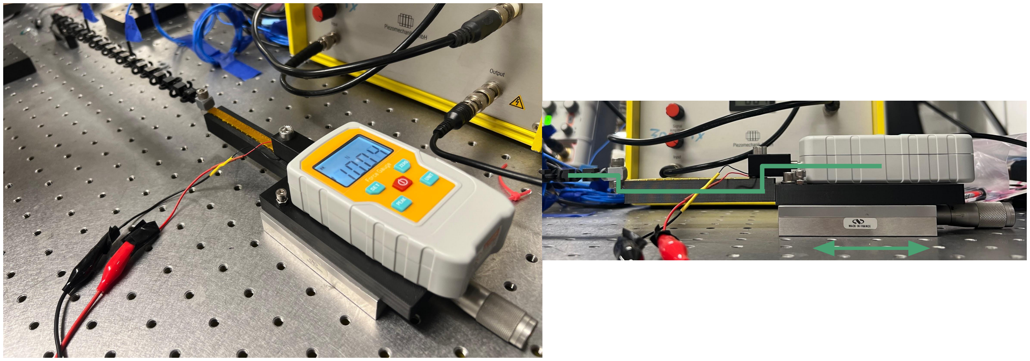
[picture p87: figure]

## Consequences of Imperfect Impulse

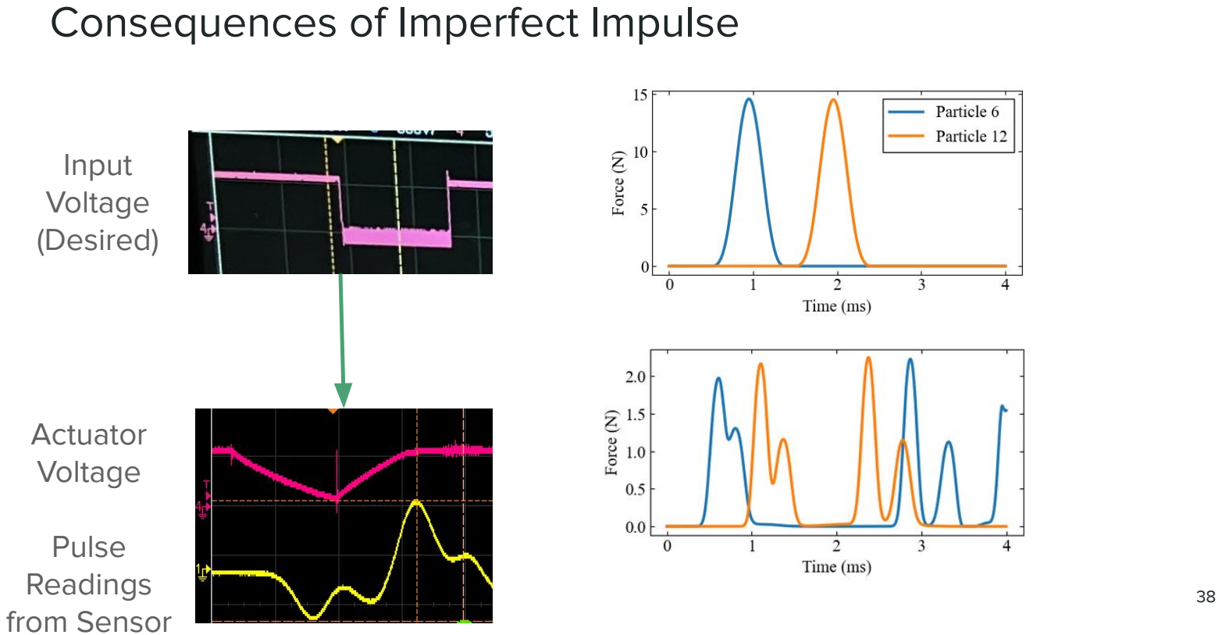
[picture p88: page 38]

Actuator
Voltage

Pulse
Readings
from Sensor

Input
Voltage
(Desired)

# Velocity vs. Amplitude Experiment

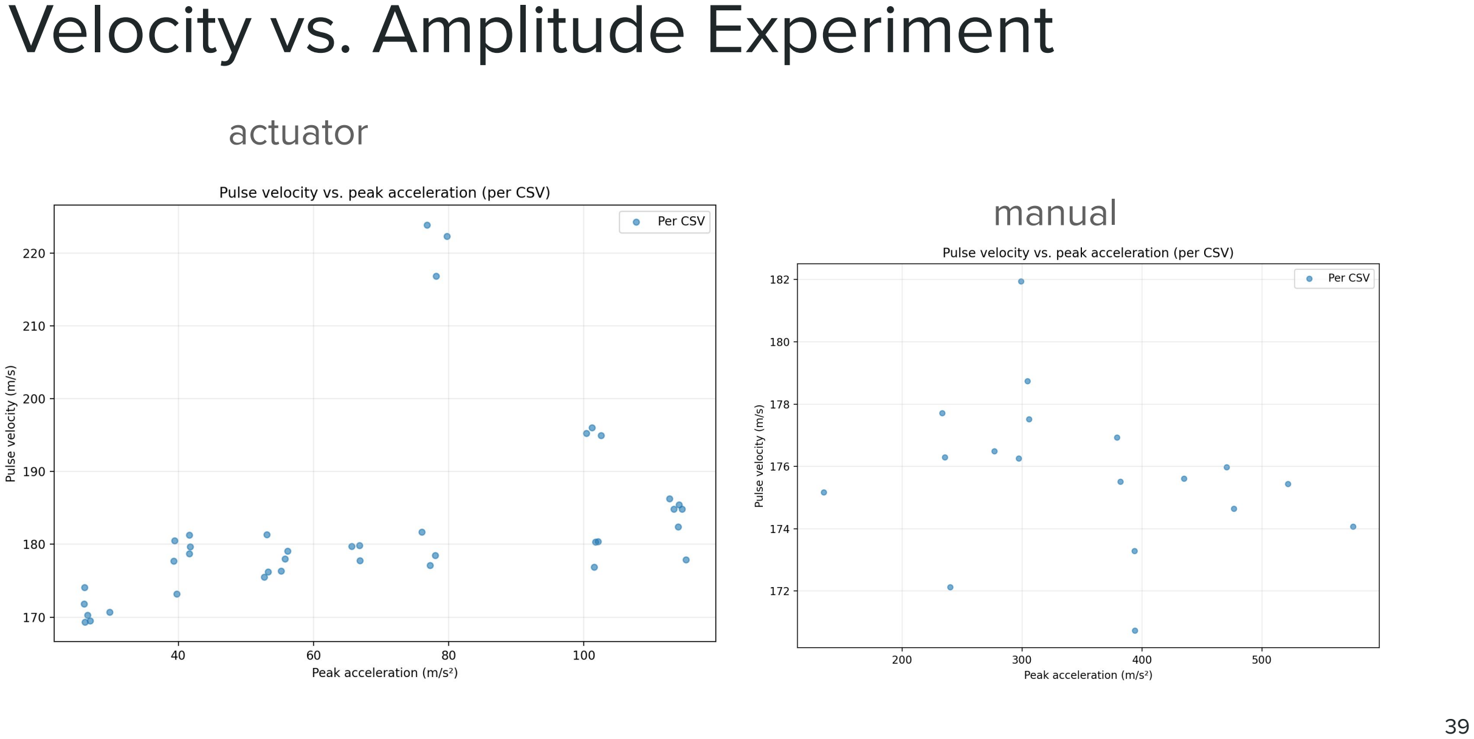
[picture p89: page 39]

manual

actuator

## Junction with Symmetrical Angles – Velocity Comparison

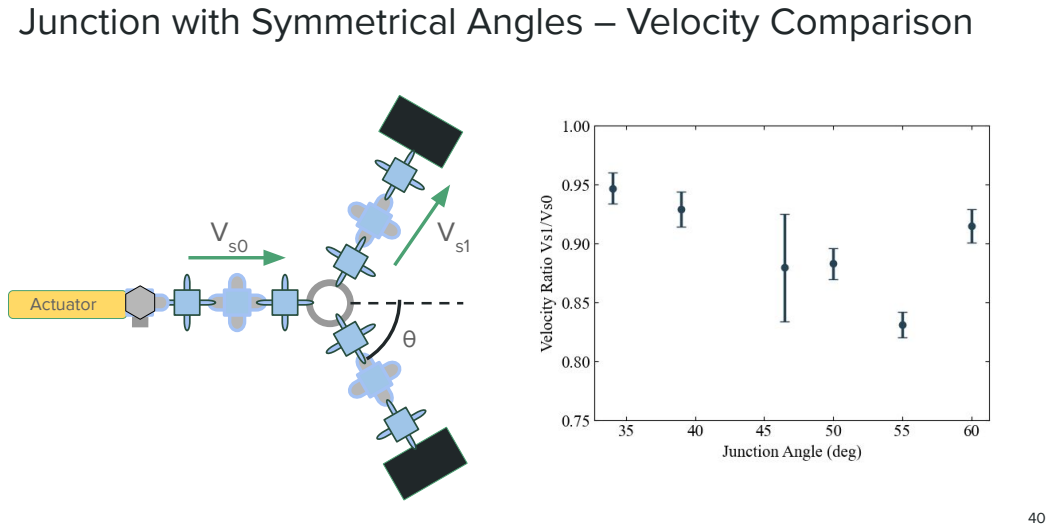
[picture p90: page 40]
Actuator

## Junction with Symmetrical Angles – Amplitude Comparison

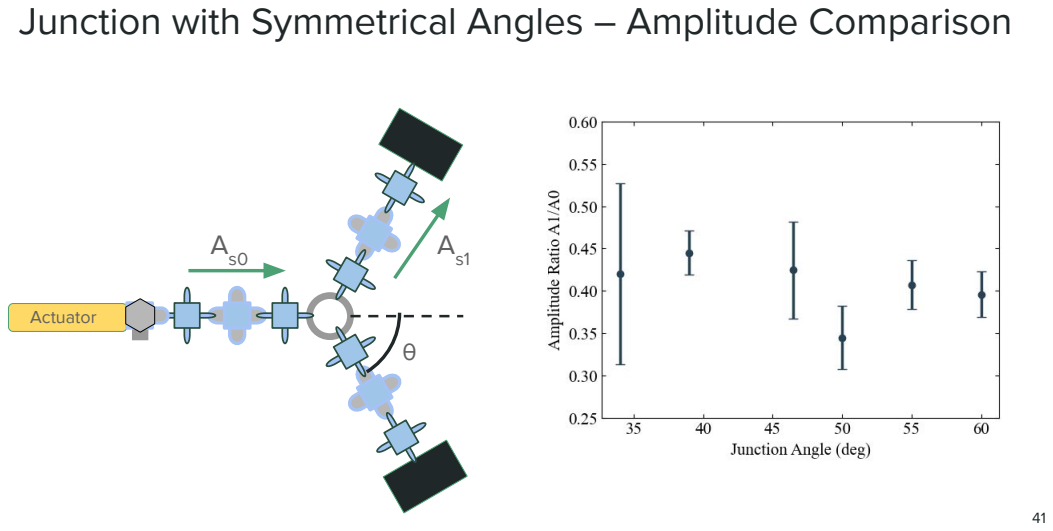
[picture p91: page 41]
Actuator

## Interesting Sine Wave Response with Aluminum

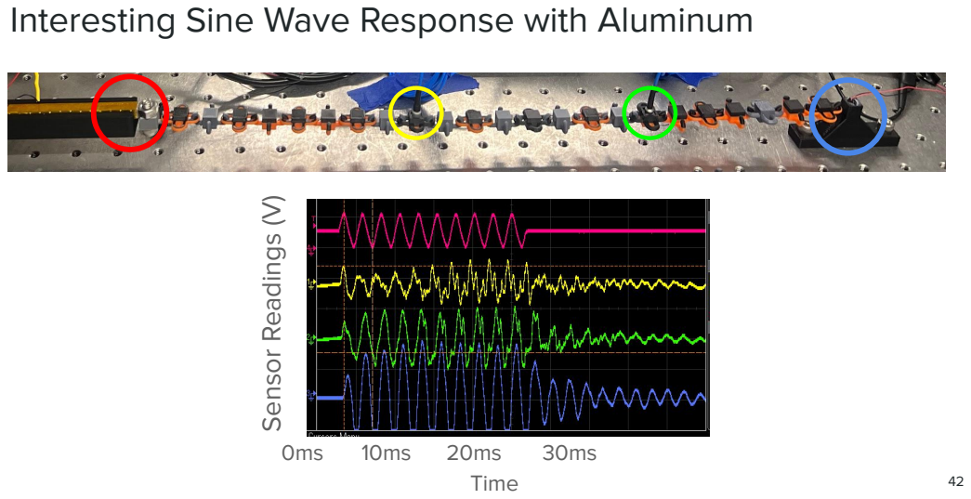
[picture p92: page 42]
Sensor Readings (V); Time
