KuroBean/SURF-git/my writing/SURF Seminar 2025 Experimental Platform for Investigating Dynamics in Polycatenated Architected Materials (PAMs) - Google Slides.pdf

## Experimental Platform for Investigating Dynamics in Polycatenated Architected Materials (PAMs)

## Kensuke Shimojo (Carl F. Braun SURF Fellow) Mentors: Alice Xiong, Prof. Chiara Daraio

Table of Contents ● Background information ○ Motivation and interesting properties ○ Theoretical model ● Experimental Setup and Methods ○ PAM unit design ○ Data collection method ● Experimental Data and Analysis ○ Pulse velocity vs. pretension ○ Pulse velocity vs. excitation amplitude ● Future Directions ○ Junction setup ○ Other modes of actuation

## Polycatenated Architected Materials (PAMs)


Wenjie Zhou et al., Science 387, 269-277 (2025)

## Theory of PAMs: Nonlinear Force vs. Displacement

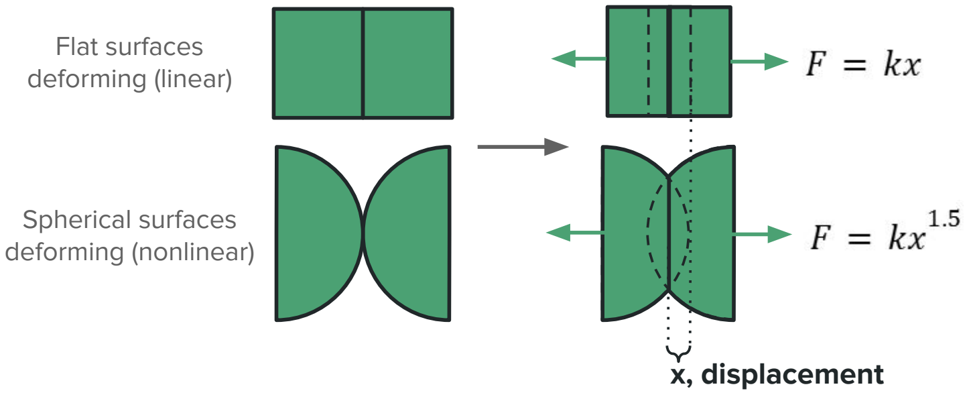
[picture p93: figure]
x, displacement; Flat surfaces deforming (linear); Spherical surfaces deforming (nonlinear)

4

Compressed
(displacement applied)

## Theory of PAMs: Nonlinear Springs at Linkages

x, displacement; Circular Ring Contacts; 2 Saddles Contacting; and Deforming; 2 Spheres Contacting and Deforming

## Theory of PAMs: PDE Setup

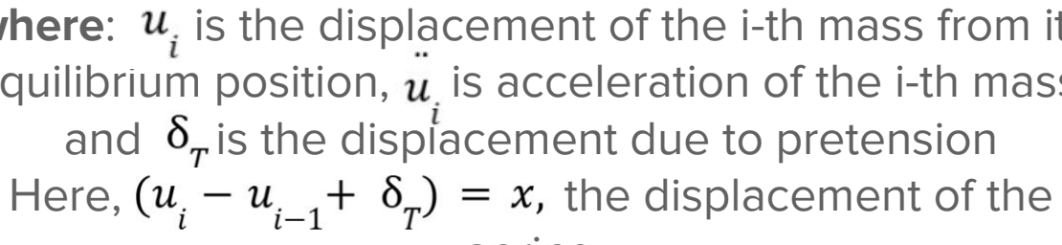
[picture p94: figure]
Here,; the displacement of the

Dynamics of Heterogeneous Materials, Vitali F. Nesterenko, 2001

Treat a linkage between PAM units as a nonlinear spring:

Model the multiple mass-spring system using a system of partial differential equations (PDEs):

where n=1.5 for our case

where: ui | is the displacement of the i-th mass from its
equilibrium position, | is acceleration of the i-th mass,
and | is the displacement due to pretension

spring

## Theory of PAMs: Solitary Wave Solutions

where: F m; units and D is a constant coefficient; travels at velocity V s

Dynamics of Heterogeneous Materials, Vitali F. Nesterenko, 2001 is the maximum force exerted within the PAM

is a nonlinear function of the maximum force, which can be controlled by pretension or input amplitude

Seek for solutions where sharp impulse is applied at boundary → Solution is a solitary wave (pulse) that

## PUT IMAGE IN NEXT GOAL SLIDES

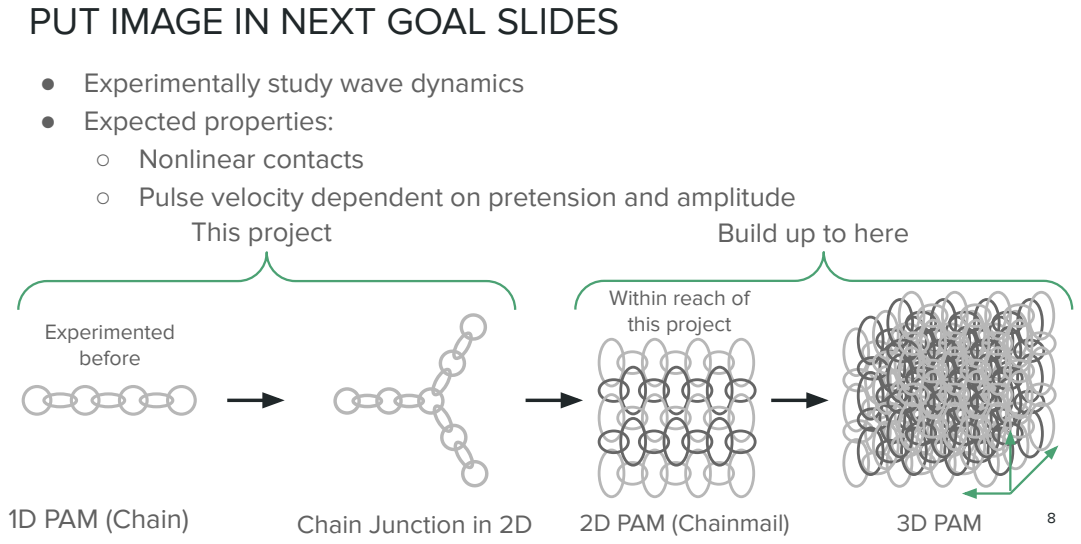
[picture p95: page 8]
This project; Build up to here; 1D PAM (Chain); Chain Junction in 2D; 2D PAM (Chainmail); 3D PAM; Experimented before

● Experimentally study wave dynamics
● Expected properties:
○ Nonlinear contacts
○ Pulse velocity dependent on pretension and amplitude

Within reach of
this project

## Goal of SURF

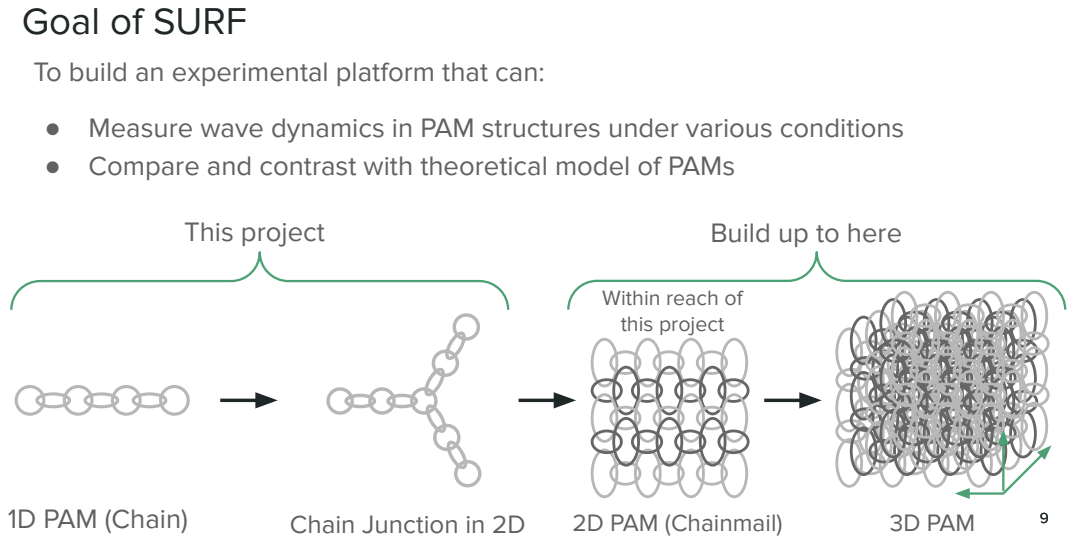
[picture p96: page 9]
This project; Build up to here; 1D PAM (Chain); Chain Junction in 2D; 2D PAM (Chainmail); 3D PAM

To build an experimental platform that can:

● Measure wave dynamics in PAM structures under various conditions
● Compare and contrast with theoretical model of PAMs

Within reach of
this project

# General Idea of the Setup

## Experimental Setup Diagram

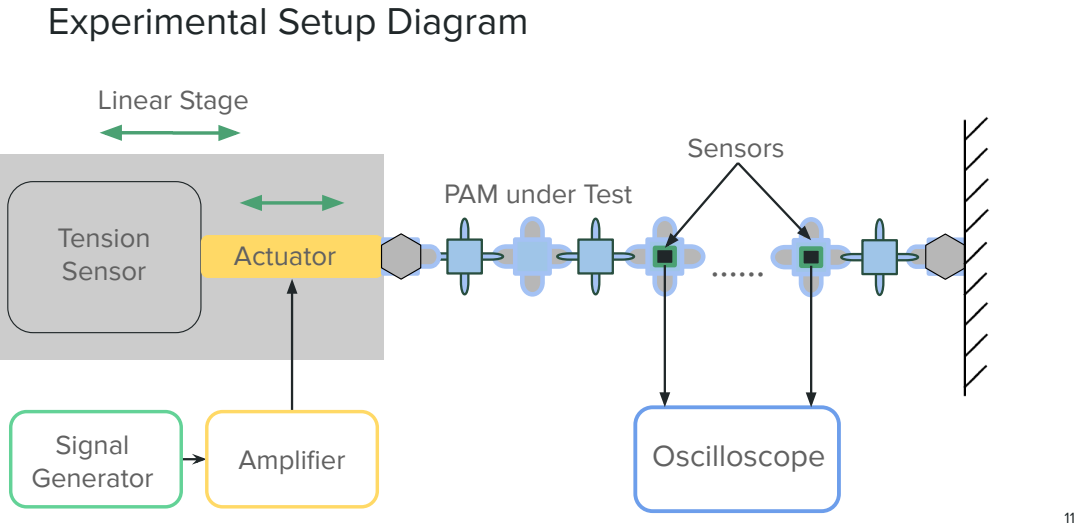
[picture p97: page 11]
Actuator; Linear Stage; Sensors; Oscilloscope Signal; Generator; Amplifier; Tension; Sensor

PAM under Test

## Actual Setup

Linear Stage; PLA Ring Blocks; Accelerometers; Piezoelectric Actuator Tension Sensor

## PAM Unit Cell: Ring Blocks

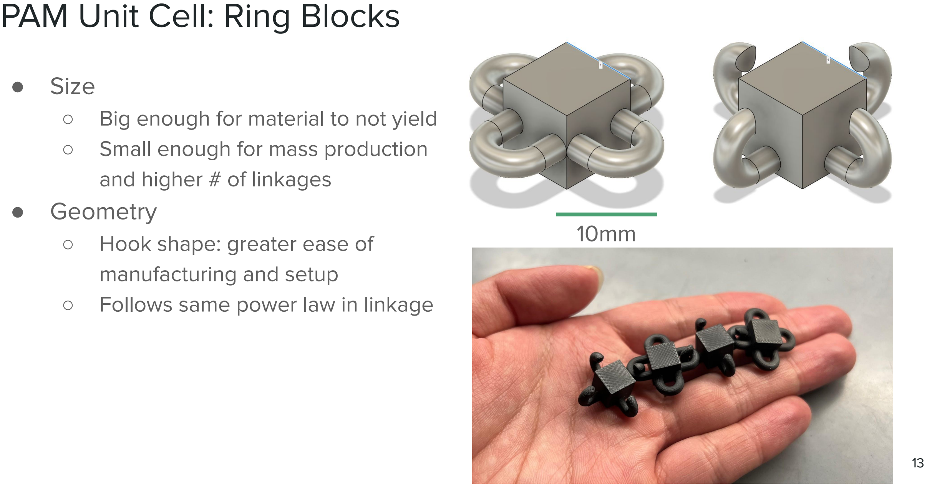
[picture p98: page 13]

- Size
- Big enough for material to not yield
- Small enough for mass production and higher # of linkages
- Geometry
- Hook shape: greater ease of manufacturing and setup
- Follows same power law in linkage

10mm

## PAM Unit Cell: Testing

- Tensile test on 2 linked blocks (1 ring contact)
- PLA link shows F = kx¹.5 relationship: as desired from linkage

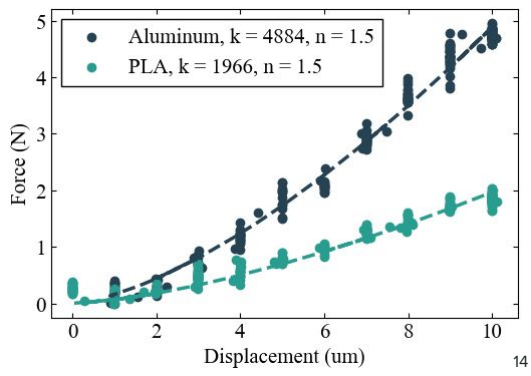
[picture p99: figure]
Displacement applied

Force exerted by
linkage measured

## Collecting Data from Accelerometer


From acceleration peaks from 2 sensors, we can get:

- Time difference → distance/time = average velocity of pulse
- Amplitude of pulse
- Amplitude drop → energy dissipated per link

Time (ms)

Accelerometer Readings (V)

15

Time Difference

Amplitude
Difference
0 | 0.5 | 1.0 | 1.5 | 2.0

## Experimental Setup

Linear Stage; PAM under Test; Actuator; Sensors Tension; Sensor

# Velocity vs. Pretension Experiment

## Hypothesis and Setup

Compression pulse applied:; Tension pulse applied:

## Hypothesis and Setup

Compression pulse applied:; Tension pulse applied:


## 1D Chain: Solitary Wave Velocity vs Pretension


- Fix input amplitude, vary
pretension
- Small impulses sent
parallel (tension) and
anti-parallel (compression) with existing pretension
- Tension pulse is slightly faster than compression
pulse

# Velocity vs. Amplitude Experiment

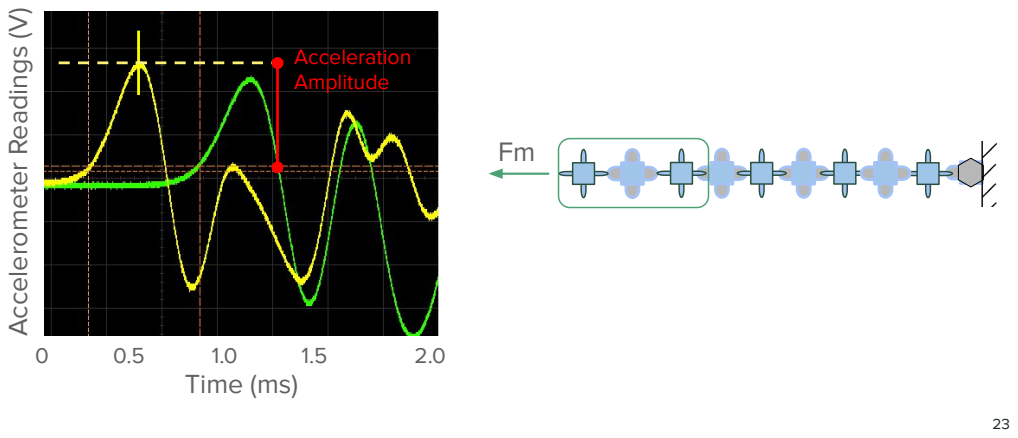
[picture p100: page 23]
Time (ms); Accelerometer Readings (V); Acceleration Amplitude

## 1D Chain: Solitary Wave Velocity vs Amplitude

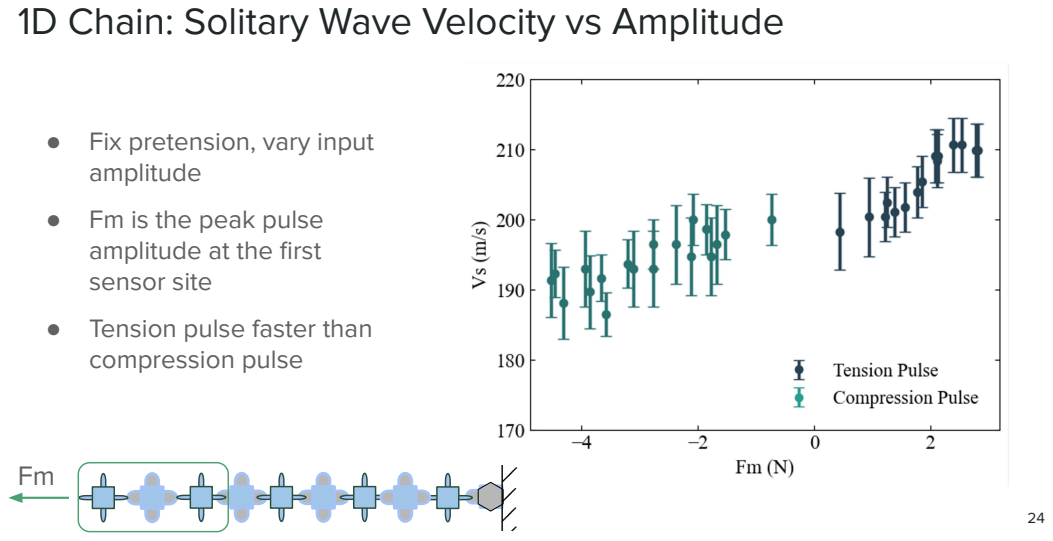
[picture p101: page 24]

● Fix pretension, vary input
amplitude
● Fm is the peak pulse
amplitude at the first
sensor site
● Tension pulse faster than
compression pulse

# Next Steps

## Next Steps: Improvements

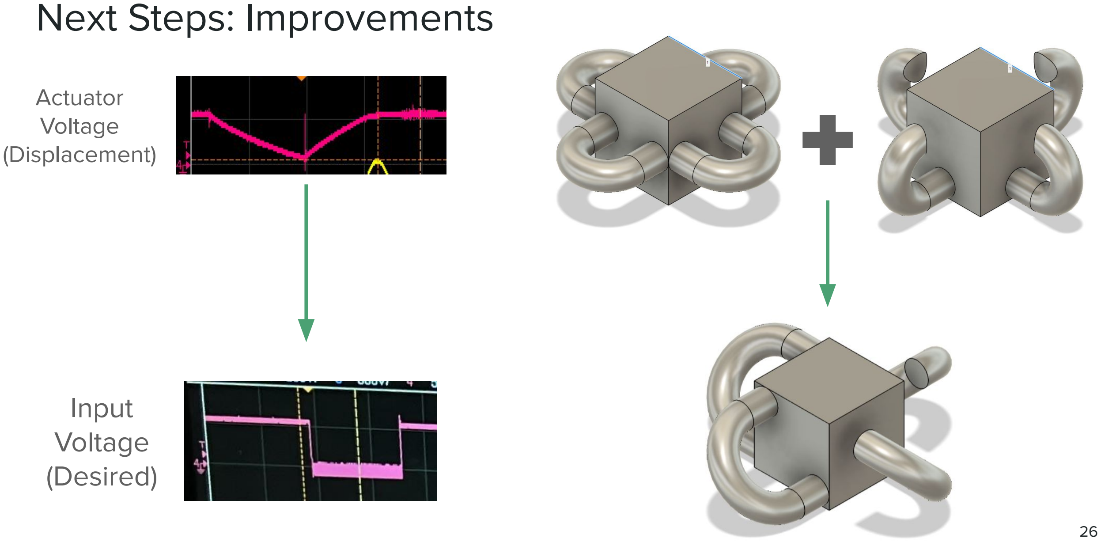
[picture p102: page 26]

Actuator
Voltage
(Displacement)

Input
Voltage
(Desired)

NEW BLOCK

Next Steps cont.

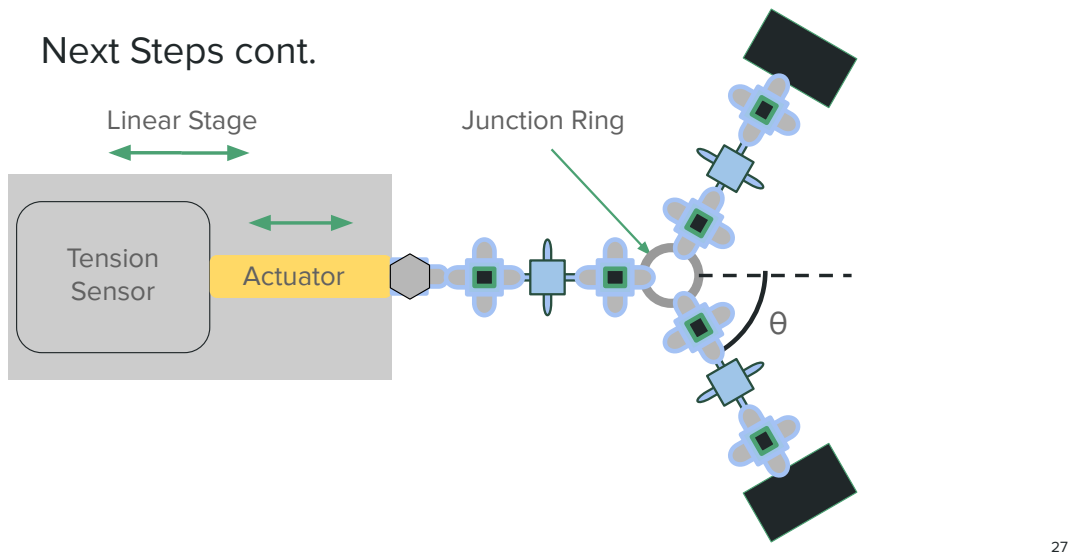
[picture p103: page 27]
Junction Ring; Actuator; Linear Stage; Tension Sensor

## Junction Setup

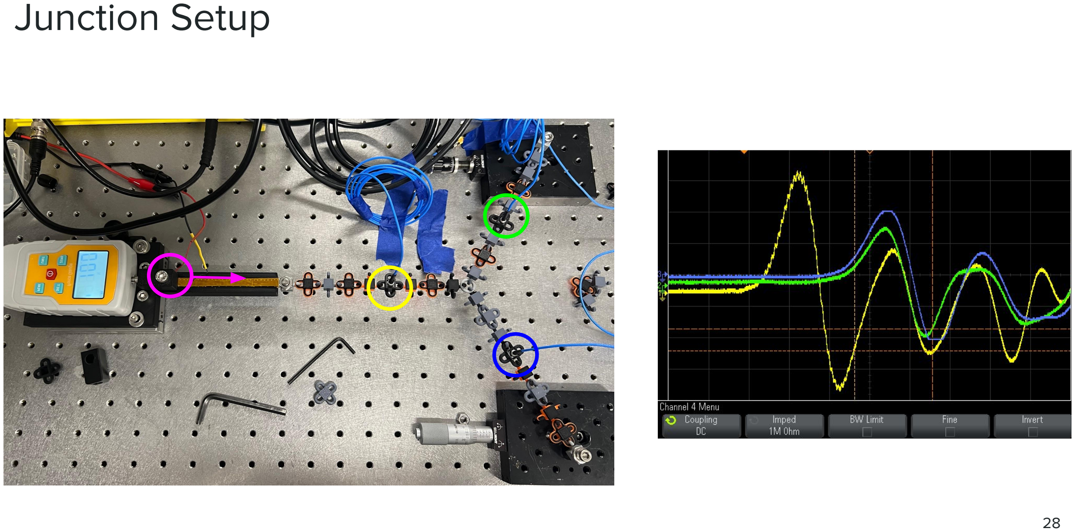
[picture p104: page 28]

Next Steps Cont.


- Different PAM linkages
- Mix and mash of different material units
- Different modes of actuation and pulses
- Test other waveform inputs (sinusoid, Gaussian, sech^2, etc.)

## Conclusions

- Setup successfully captured data trend
- Captured trend is consistent with theory- validation
- Experimental setup can be easily modified:
- Many potential new directions
- Serves as foundation for experimental investigations into PAMs
- Junction, 2D
- Insight into physics of 3D PAMs → usability as tunable material

## Acknowledgements

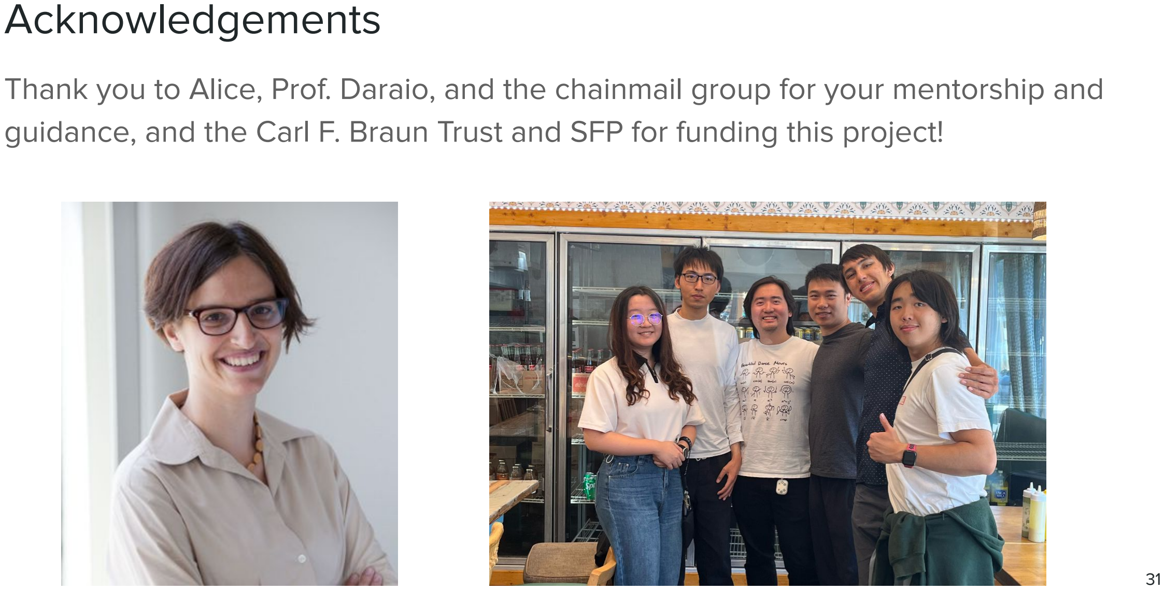
[picture p105: page 31]

Thank you to Alice, Prof. Daraio, and the chainmail group for your mentorship and guidance, and the Carl F. Braun Trust and SFP for funding this project!

(IMAGES)

## Feedback Form

Name: Kensuke Shimojo


## Thank you for listening!

## PAM Unit Cell: Materials

Material | Total Price | Lead Time | Yield Strength (MPa)

PLA; Polycarbonate Aluminum

PLA (printed on campus) | Few cents -few dollars | 2-6 hours | 30-60
Nylon | $37.49 | 6-10 days | 40-70
Aluminum | $79.75 | 6-10 days | ~240
SS | $62.78 | 6-10 days | 40-95
Polycarbonate | $34.06 | 7-13 days | ~60
Glass filled nylon | $54.85 | 15 days | 230-300

## Piezoelectric Actuator


- Tens of micrometers level actuation and control
- Input different waveforms of pulses

Actuator Voltage

0.5 ms

Time (us)

0ms | 1.0 ms | 1.5 ms

## Accelerometer vs. Ceramic Piezo Force Sensor

| Triaxial Accelerometer | Piezo Force Sensor
Measured Quantity | Acceleration | Quickly Changing Compression or Tension Force
Dimensions of Measurement | 3 | 1
Calibration | Precalibrated | Needs Calibration


## Accelerometer vs. Ceramic Piezo Force Sensor

Triaxial Accelerometer:

- Measures acceleration in each dimension
- 3 dimensions
- Useful for other modes of wave pulses
- Better for 2D case (eventually)
- Precalibrated

Piezo Force Sensor:

- Approximately measures
compressional or tensile force
- But constant offset issue is present, may be inconsistent
- Calibration curve needed
| Triaxial Accelerometer | Piezo Force Sensor
Measured Quantity | Acceleration | Quickly Changing Compression or Tension Force

Dimensions of
Measurement

3 1

## Tension Sensor + Linear Stage


## Consequences of Imperfect Impulse


Actuator
Voltage

Pulse
Readings
from Sensor

Input
Voltage
(Desired)

# Velocity vs. Amplitude Experiment


manual

actuator

## Junction with Symmetrical Angles – Velocity Comparison

Actuator

## Junction with Symmetrical Angles – Amplitude Comparison

Actuator

## Interesting Sine Wave Response with Aluminum

Sensor Readings (V); Time
