KuroBean/SURF-git/3D models for chainmail/metal loaded design bigger 3_2/MAIN 11.5mm metal cube 1d block (only longer side fit.stl

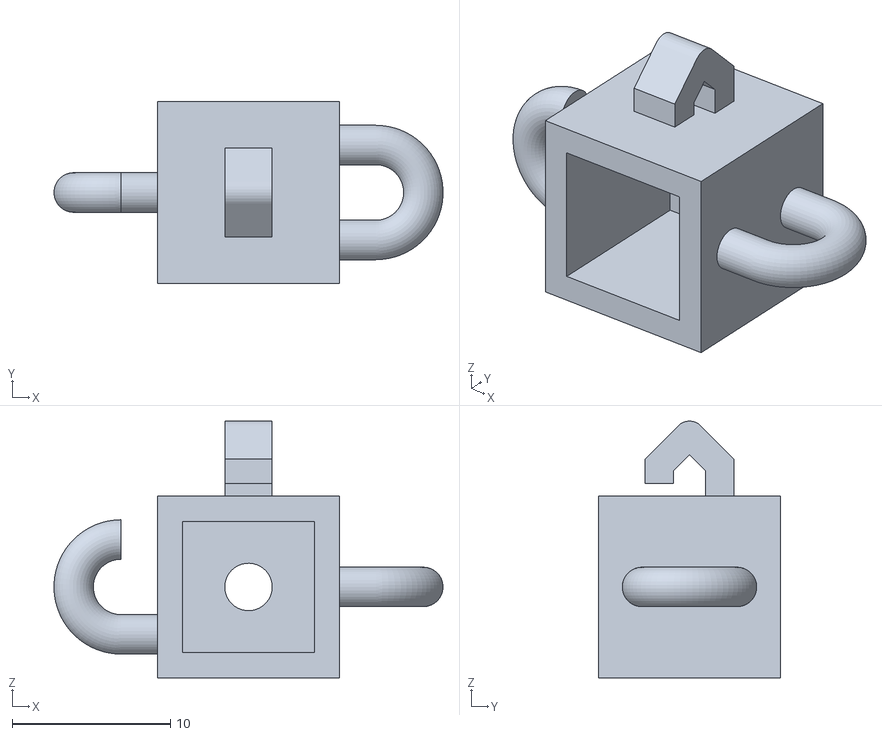
[picture p106: CAD file, 2026-04-09]
3D models for chainmail/metal loaded design bigger 3_2/MAIN 11.5mm metal cube 1d block (only longer side fit.stl
24.6 x 11.5 x 16.2
