KuroBean/SURF-git/3D models for chainmail/ring blocks/full ring assembly diag.3mf

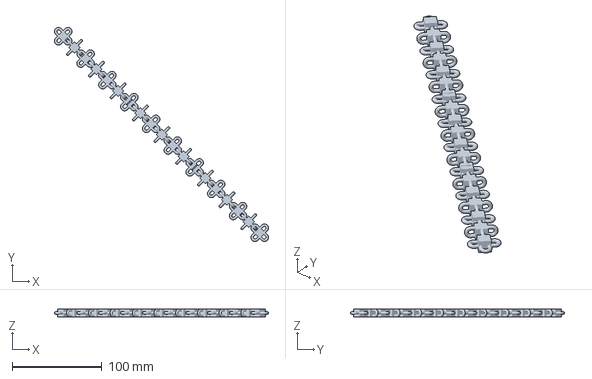
[picture p107: CAD file, 2025-08-16]
3D models for chainmail/ring blocks/full ring assembly diag.3mf
238.4 x 238.4 x 9.00 mm
