KuroBean/SURF-git/3D models for chainmail/ring blocks/full ring assembly hori.3mf

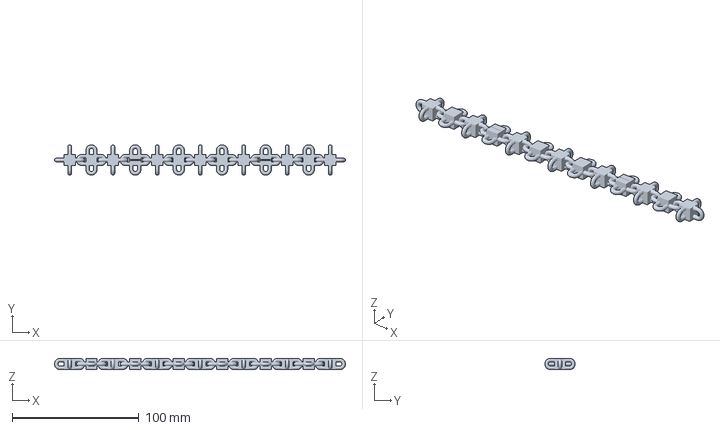
[picture p108: CAD file, 2025-08-16]
3D models for chainmail/ring blocks/full ring assembly hori.3mf
229.6 x 24.0 x 9.00 mm
