KuroBean/SURF-git/3D models for chainmail/7_1 fixed hori rings and adjusted act/full ring vertical block cyl v1.stl

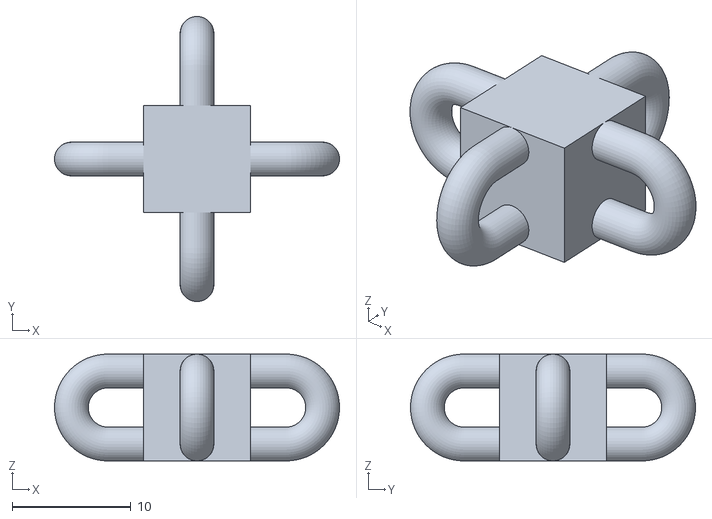
[picture p109: CAD file, 2025-08-16]
3D models for chainmail/7_1 fixed hori rings and adjusted act/full ring vertical block cyl v1.stl
24.0 x 24.0 x 9.00
