KuroBean/SURF-git/3D models for chainmail/metal loaded design bigger 3_2/40 batch MAIN 8.2mm hole metal cube horizontal + vertical block 1d.3mf

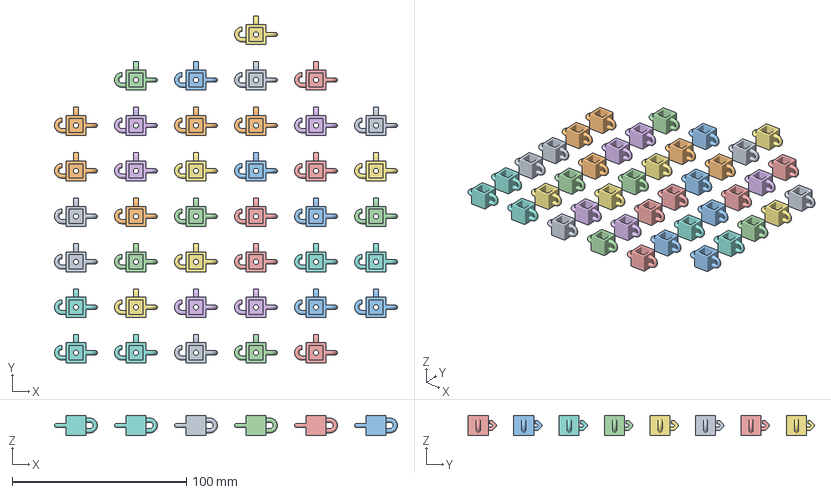
[picture p110: CAD file, 2026-04-09]
3D models for chainmail/metal loaded design bigger 3_2/40 batch MAIN 8.2mm hole metal cube horizontal + vertical block 1d.3mf
196.6 x 198.7 x 11.5 mm
