KuroBean/SURF-git/3D models for chainmail/metal loaded design bigger 3_2/42 MAIN 11.5mm metal cube 1d block (only longer side fit.3mf

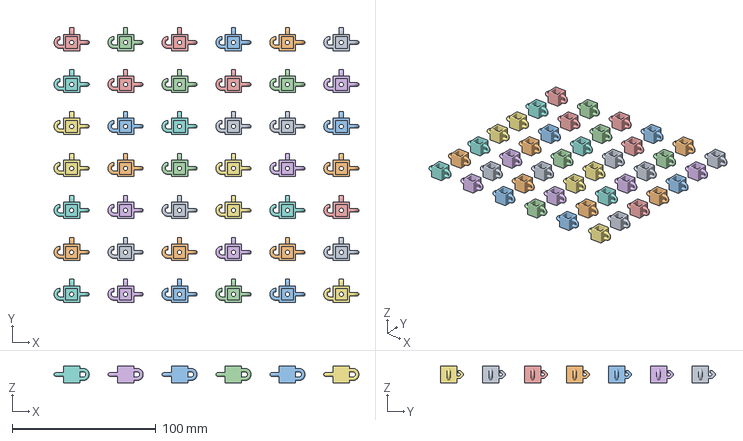
[picture p111: CAD file, 2026-04-09]
3D models for chainmail/metal loaded design bigger 3_2/42 MAIN 11.5mm metal cube 1d block (only longer side fit.3mf
212.5 x 191.7 x 11.5 mm
