KuroBean/SURF-git/3D models for chainmail/1D diag ring blocks/pulley holder v3.stl

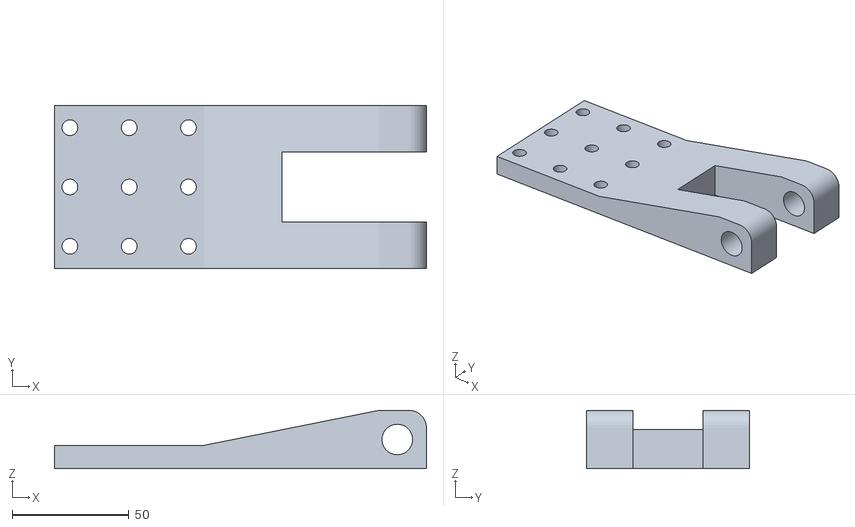
[picture p112: CAD file, 2026-04-09]
3D models for chainmail/1D diag ring blocks/pulley holder v3.stl
159.4 x 69.9 x 25.0
