KuroBean/SURF-git/3D models for chainmail/2d design/5 block boundary 3 hole thick v3.stl

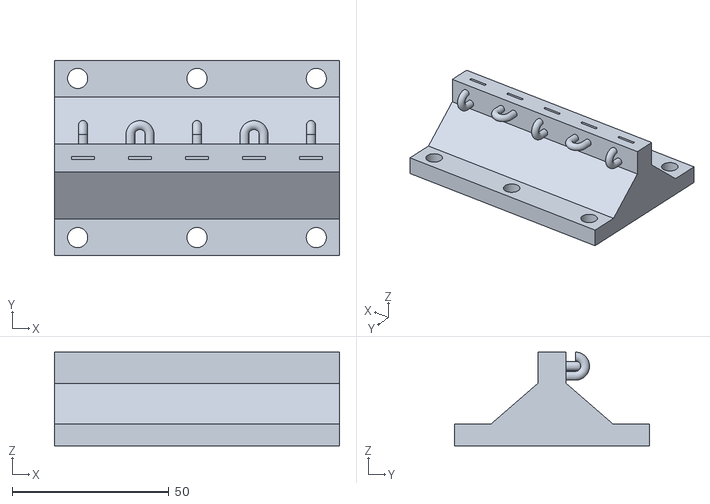
[picture p113: CAD file, 2025-08-16]
3D models for chainmail/2d design/5 block boundary 3 hole thick v3.stl
91.0 x 62.2 x 30.0
