KuroBean/SURF-git/3D models for chainmail/6_24 even smaller rings and tol/Hook vertical block cyl hook v6 smaller new tol.stl

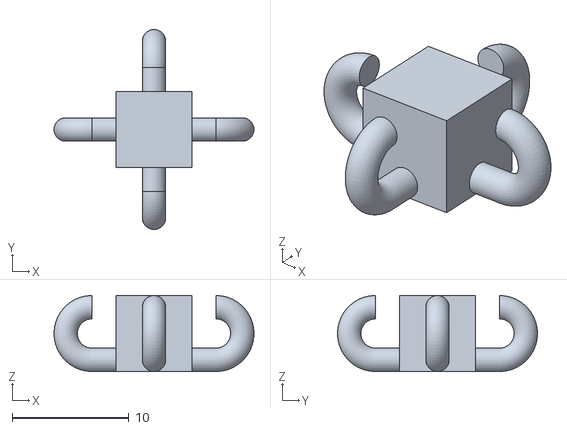
[picture p114: CAD file, 2025-08-16]
3D models for chainmail/6_24 even smaller rings and tol/Hook vertical block cyl hook v6 smaller new tol.stl
17.1 x 17.1 x 6.50
