KuroBean/SURF-git/3D models for chainmail/6_26 bigger r for metla 3d print/horizontal ring block cyl v9 with sensor hole.stl

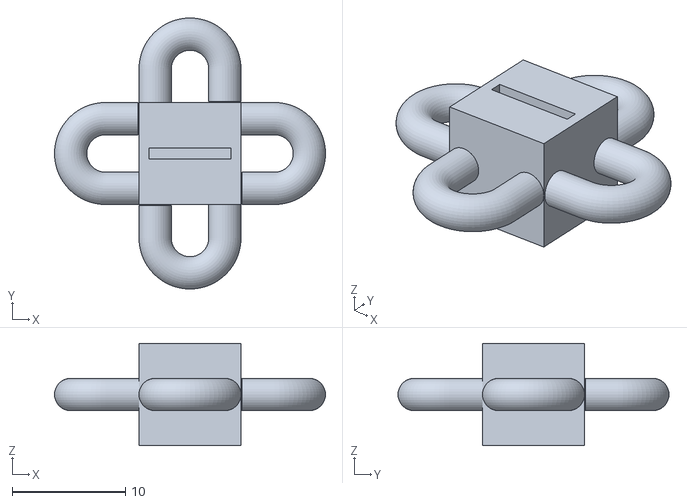
[picture p116: CAD file, 2025-08-16]
3D models for chainmail/6_26 bigger r for metla 3d print/horizontal ring block cyl v9 with sensor hole.stl
23.9 x 23.9 x 9.00
