KuroBean/SURF-git/3D models for chainmail/7_1 fixed hori rings and adjusted act/actuator.3mf

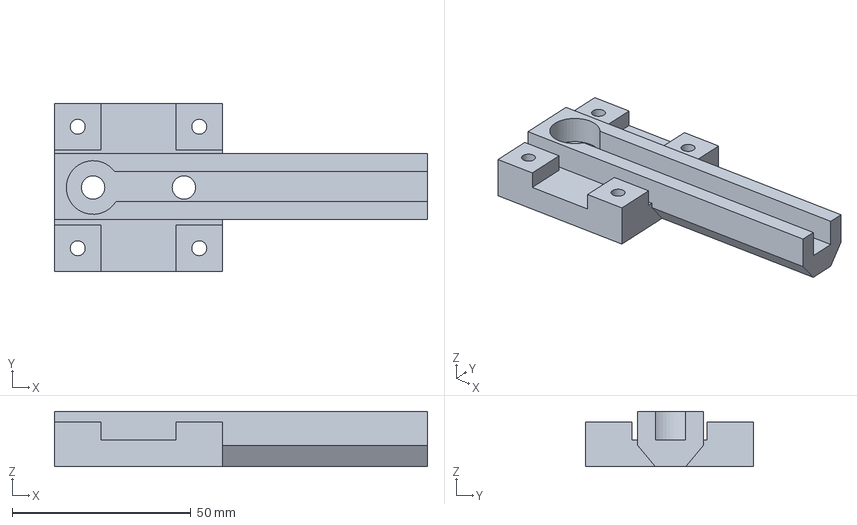
[picture p117: CAD file, 2025-08-16]
3D models for chainmail/7_1 fixed hori rings and adjusted act/actuator.3mf
104.3 x 47.0 x 15.5 mm
