KuroBean/SURF-git/3D models for chainmail/7_11 actuator parts/bigger side actuator holder v2.stl

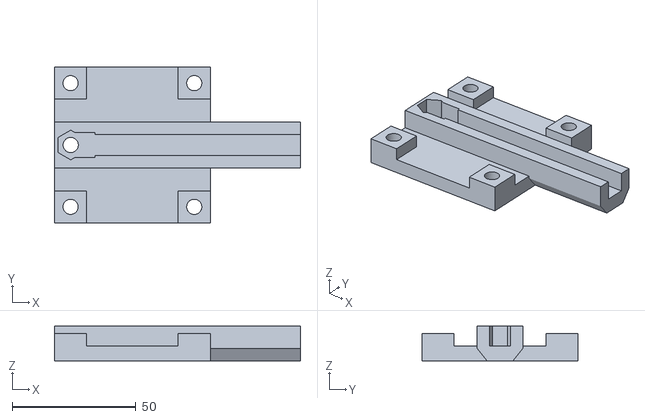
[picture p118: CAD file, 2025-08-16]
3D models for chainmail/7_11 actuator parts/bigger side actuator holder v2.stl
99.5 x 63.0 x 14.0
