KuroBean/SURF-git/3D models for chainmail/7_16 and 17 new spacer boundary blocks/vertical boundaries print.3mf

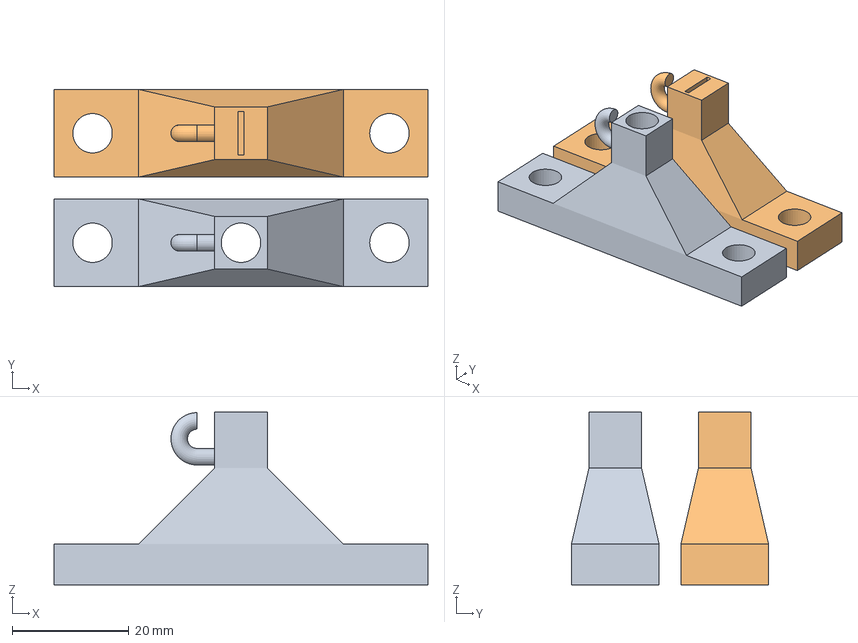
[picture p119: CAD file, 2025-08-16]
3D models for chainmail/7_16 and 17 new spacer boundary blocks/vertical boundaries print.3mf
64.0 x 33.7 x 29.6 mm
vertical boundary 3 screw v2.stl
vertical boundary sensor hole v2.stl
