KuroBean/SURF-git/3D models for chainmail/7_8 data pulse collection/1/boundary block v2.stl

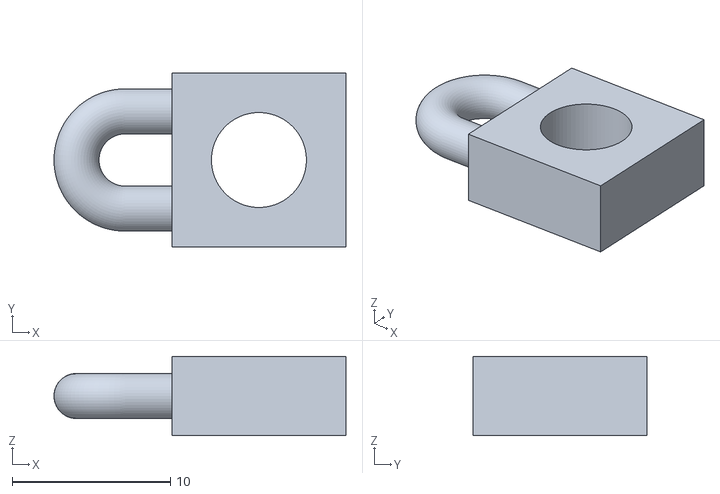
[picture p120: CAD file, 2025-08-16]
3D models for chainmail/7_8 data pulse collection/1/boundary block v2.stl
18.4 x 11.0 x 5.00
