KuroBean/SURF-git/3D models for chainmail/ball striker design/no actuator tension sensor holder.stl

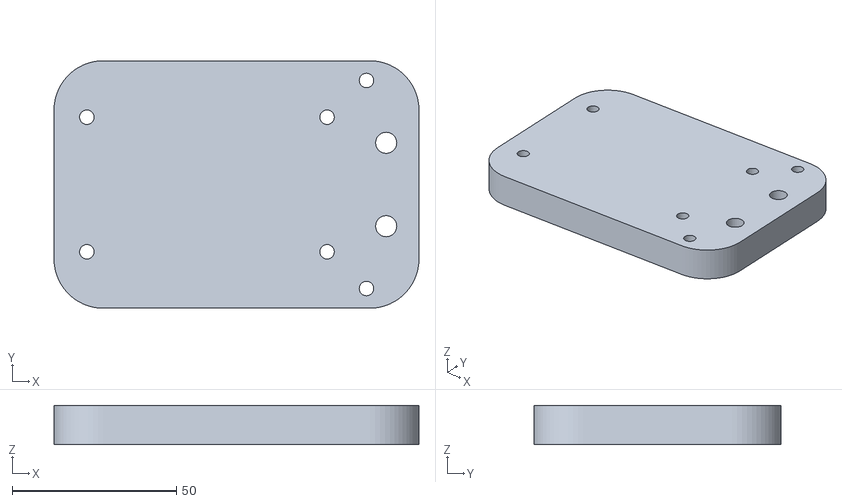
[picture p121: CAD file, 2026-04-09]
3D models for chainmail/ball striker design/no actuator tension sensor holder.stl
111.2 x 75.4 x 12.0
