KuroBean/SURF-git/3D models for chainmail/boundary blocks/verti boundary block v2 small hole.stl

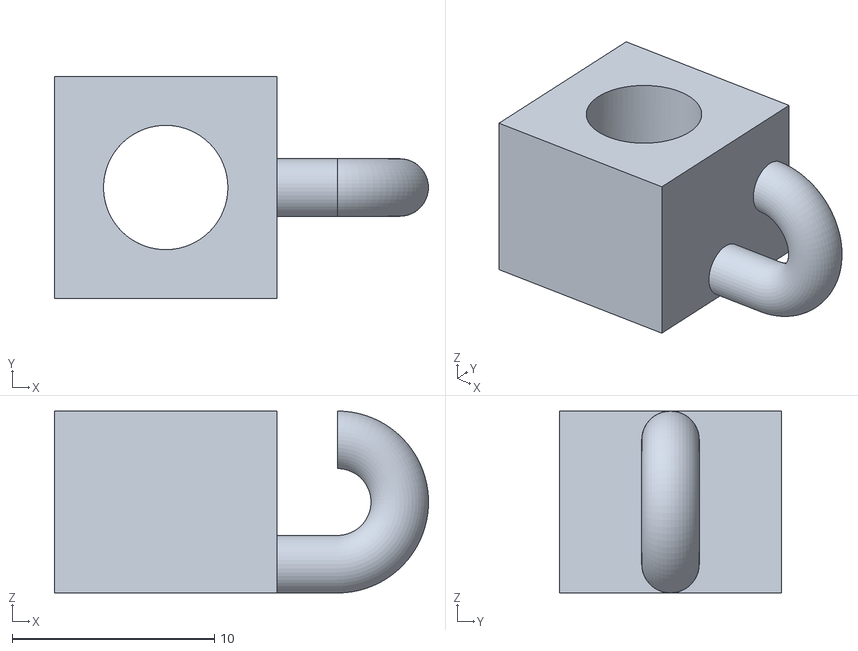
[picture p122: CAD file, 2025-08-16]
3D models for chainmail/boundary blocks/verti boundary block v2 small hole.stl
18.5 x 11.0 x 9.00
