KuroBean/SURF-git/3D models for chainmail/henry designs/bi_in_array_1by2.stl

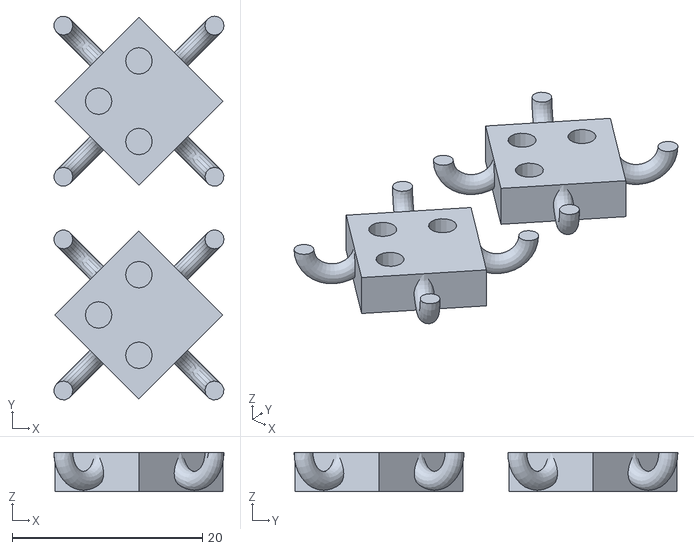
[picture p123: CAD file, 2025-08-16]
3D models for chainmail/henry designs/bi_in_array_1by2.stl
17.9 x 40.4 x 4.14
