KuroBean/SURF-git/3D models for chainmail/hori verti single block/horizontal + vertical block batch plate 1d v4.3mf

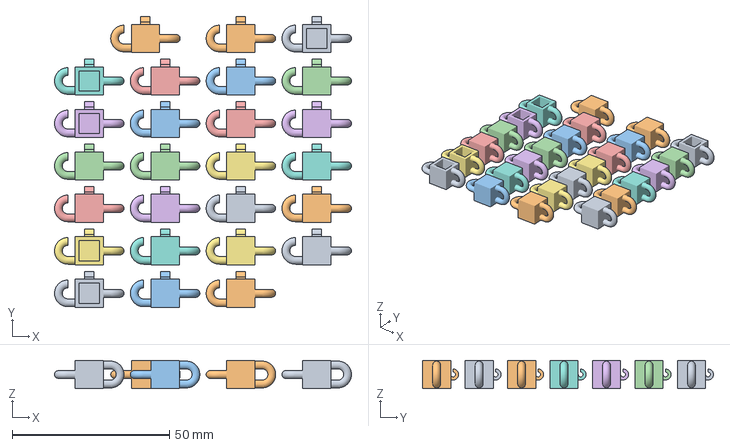
[picture p124: CAD file, 2026-04-09]
3D models for chainmail/hori verti single block/horizontal + vertical block batch plate 1d v4.3mf
94.4 x 92.5 x 9.00 mm
horizontal + vertical block sensor block 1d v4.stl x 5
horizontal + vertical block no sensor.stl x 21
