KuroBean/SURF-git/3D models for chainmail/metal loaded design bigger 3_2/striker with limiter/angle limiter v3 min 45 deg smol and incremented.3mf

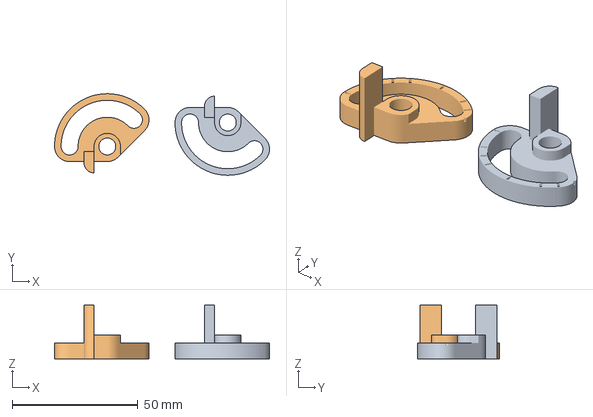
[picture p125: CAD file, 2026-06-22]
3D models for chainmail/metal loaded design bigger 3_2/striker with limiter/angle limiter v3 min 45 deg smol and incremented.3mf
85.5 x 32.5 x 21.4 mm
angle limiter v3 min 45 deg smol and incremented.stl x 2
