KuroBean/SURF-git/3D models for chainmail/piezosensor 100um.step

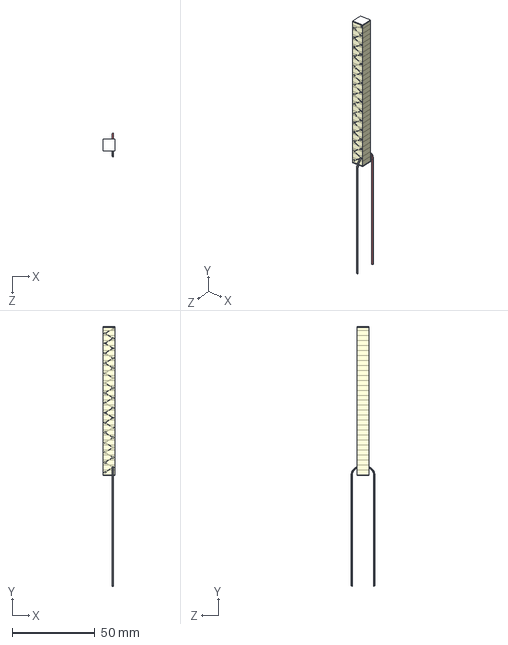
[picture p126: CAD file, 2025-08-16]
3D models for chainmail/piezosensor 100um.step
7.00 x 157.2 x 14.4 mm
