KuroBean/SURF-git/3D models for chainmail/sensor with actuator holder/adapter for S load sensor holder.stl

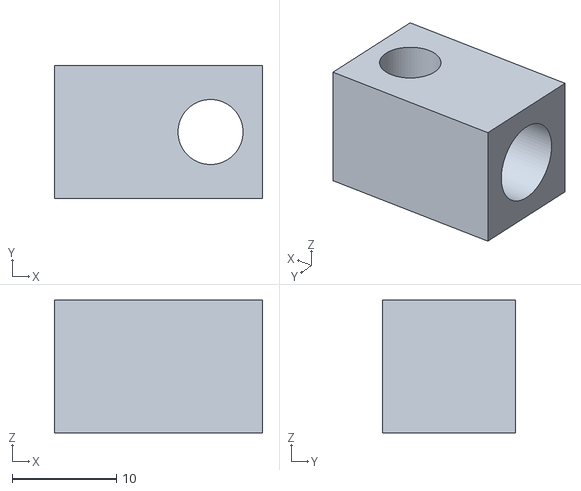
[picture p127: CAD file, 2025-08-16]
3D models for chainmail/sensor with actuator holder/adapter for S load sensor holder.stl
20.0 x 12.8 x 12.8
