KuroBean/SURF-git/3D models for chainmail/single block design 11_16/horizontal + vertical block 1d.stl

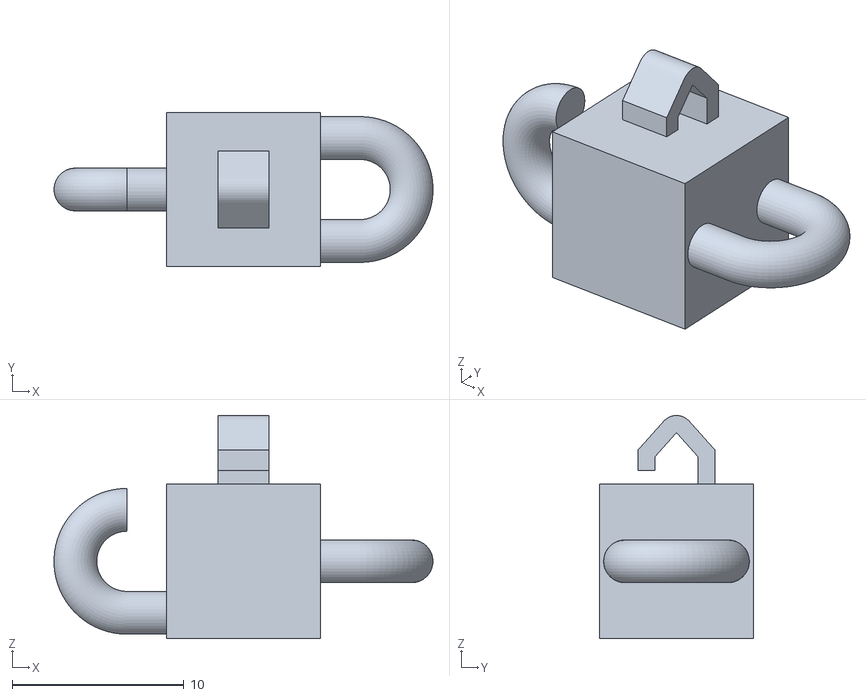
[picture p128: CAD file, 2026-04-09]
3D models for chainmail/single block design 11_16/horizontal + vertical block 1d.stl
22.1 x 9.00 x 13.0
