KuroBean/SURF-git/3D models for chainmail/v2 long rings and smaller/Hook vertical block v2.stl

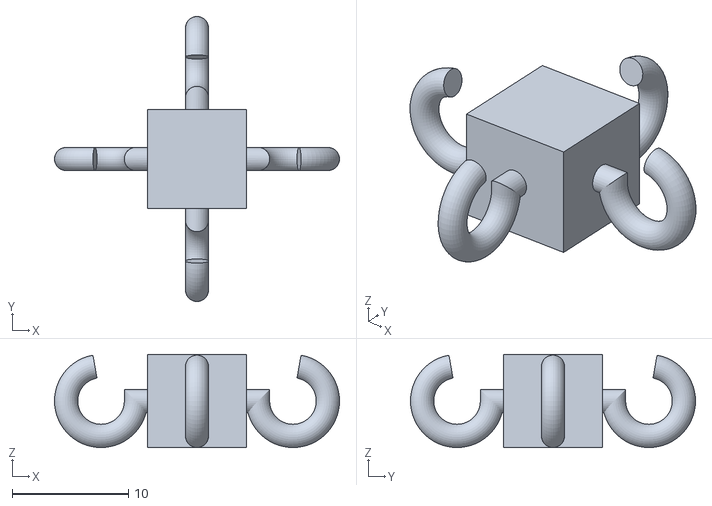
[picture p129: CAD file, 2025-08-16]
3D models for chainmail/v2 long rings and smaller/Hook vertical block v2.stl
24.5 x 24.5 x 8.00
