KuroBean/SURF-git/3D models for chainmail/1D diag ring blocks/string holder v4 thicker ring correct dim.stl

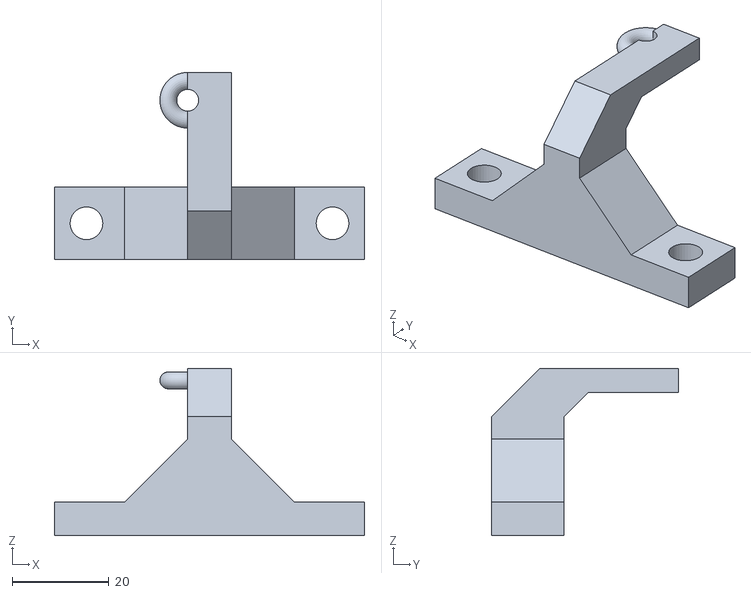
[picture p130: CAD file, 2026-04-09]
3D models for chainmail/1D diag ring blocks/string holder v4 thicker ring correct dim.stl
64.0 x 38.7 x 34.6
