KuroBean/SURF-git/3D models for chainmail/2d design/multi block bigger side actuator holder v5.stl

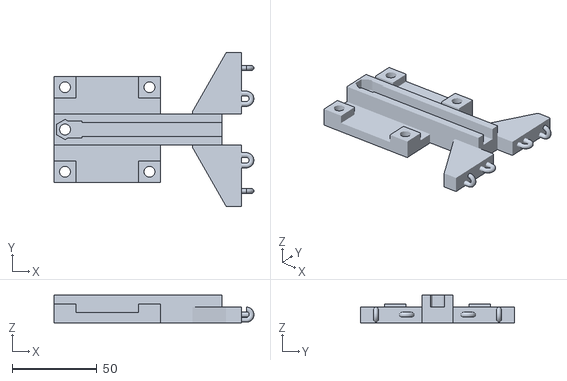
[picture p131: CAD file, 2025-08-16]
3D models for chainmail/2d design/multi block bigger side actuator holder v5.stl
118.4 x 91.0 x 16.3
