KuroBean/SURF-git/3D models for chainmail/6_24 even smaller rings and tol/horizontal ring block cyl v3 smaller and new tol.stl

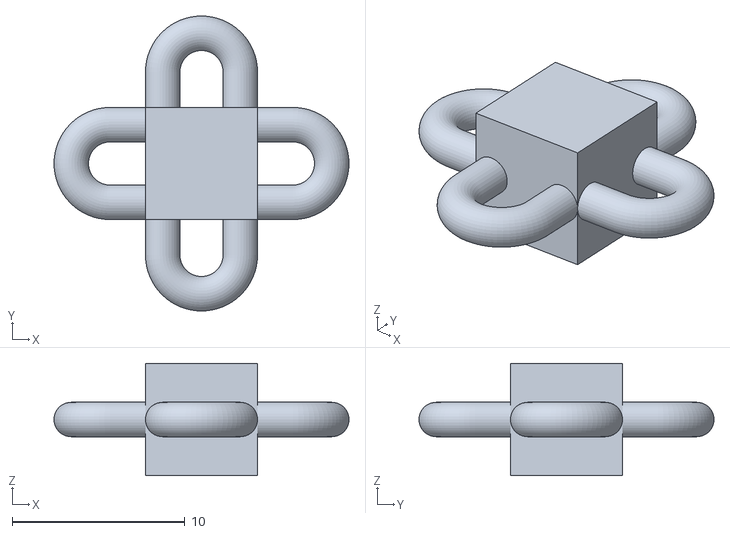
[picture p132: CAD file, 2025-08-16]
3D models for chainmail/6_24 even smaller rings and tol/horizontal ring block cyl v3 smaller and new tol.stl
17.1 x 17.1 x 6.50
