KuroBean/SURF-git/3D models for chainmail/6_25 for metal 3d print and lab sensors/horizontal ring block cyl accelerometer hole v2.stl

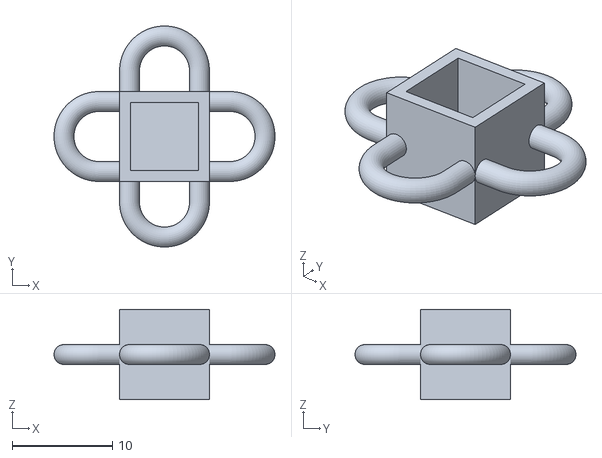
[picture p133: CAD file, 2025-08-16]
3D models for chainmail/6_25 for metal 3d print and lab sensors/horizontal ring block cyl accelerometer hole v2.stl
22.1 x 22.1 x 9.00
