KuroBean/SURF-git/3D models for chainmail/7_1 fixed hori rings and adjusted act/ring blocks  cyl v11 no sensor_PLA_5h49m.gcode.3mf

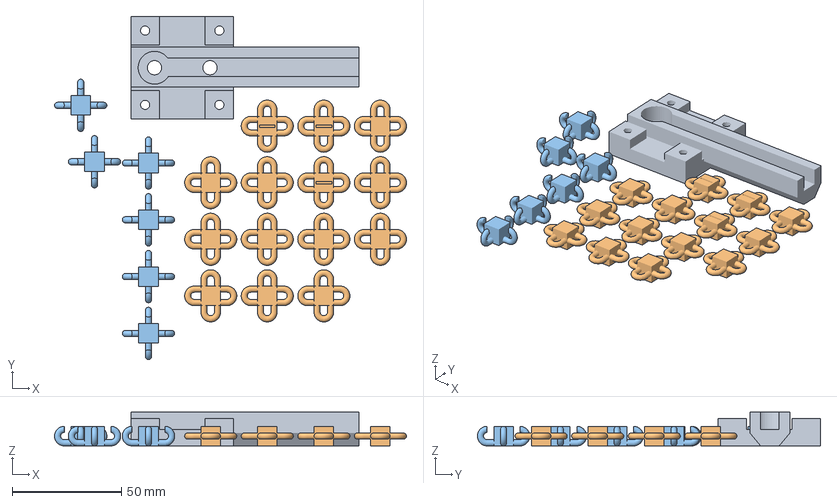
[picture p134: CAD file, 2025-08-16]
3D models for chainmail/7_1 fixed hori rings and adjusted act/ring blocks cyl v11 no sensor_PLA_5h49m.gcode.3mf
161.2 x 157.2 x 15.5 mm
actuator holder v5.stl
Assembly x 2
