KuroBean/SURF-git/3D models for chainmail/7_16 and 17 new spacer boundary blocks/vertical boundary sensor hole v2.stl

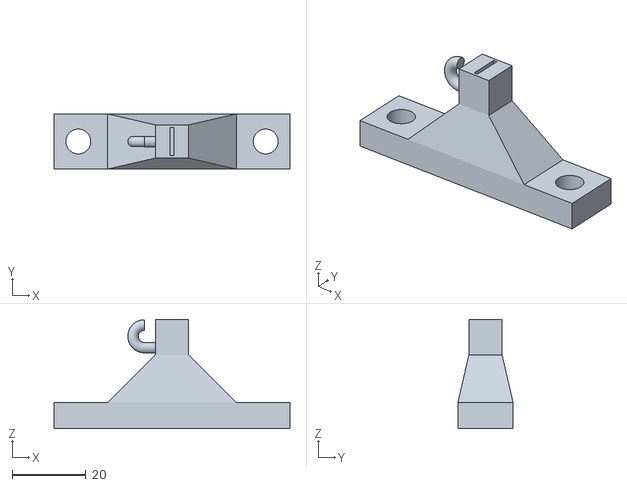
[picture p135: CAD file, 2025-08-16]
3D models for chainmail/7_16 and 17 new spacer boundary blocks/vertical boundary sensor hole v2.stl
64.0 x 15.0 x 29.6
