KuroBean/SURF-git/3D models for chainmail/ball striker design/tension sensor ring block interface.3mf

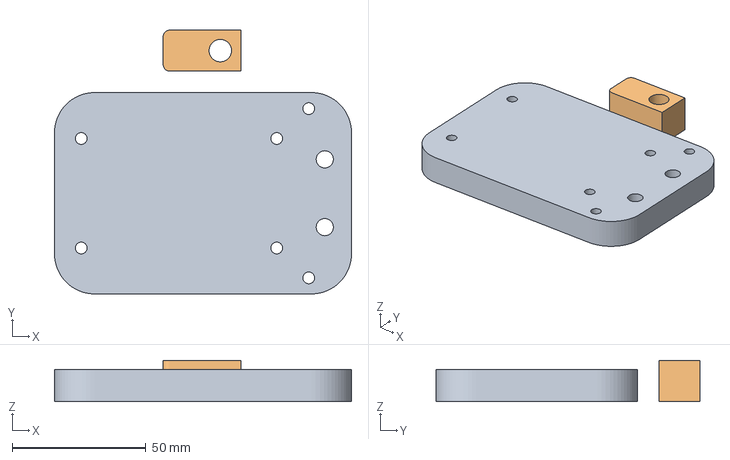
[picture p136: CAD file, 2026-04-09]
3D models for chainmail/ball striker design/tension sensor ring block interface.3mf
111.2 x 98.8 x 15.4 mm
no actuator tension sensor holder.stl
tension sensor ring block interface.stl
