KuroBean/SURF-git/3D models for chainmail/boundary blocks/vertical boundary sensor 2 hole short  midpt v2.stl

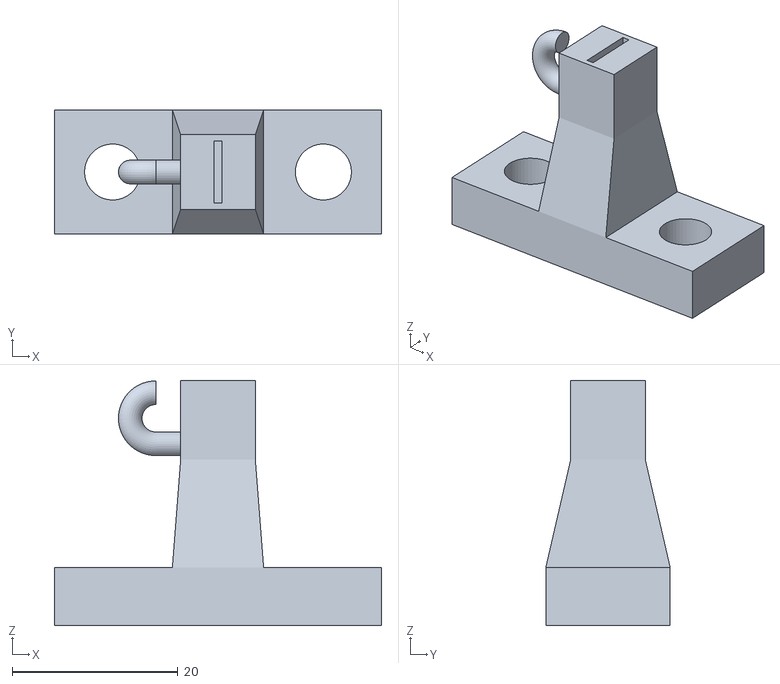
[picture p137: CAD file, 2025-08-16]
3D models for chainmail/boundary blocks/vertical boundary sensor 2 hole short midpt v2.stl
39.4 x 15.0 x 29.6
