KuroBean/SURF-git/3D models for chainmail/henry designs/bi_flat_array_1by2.stl

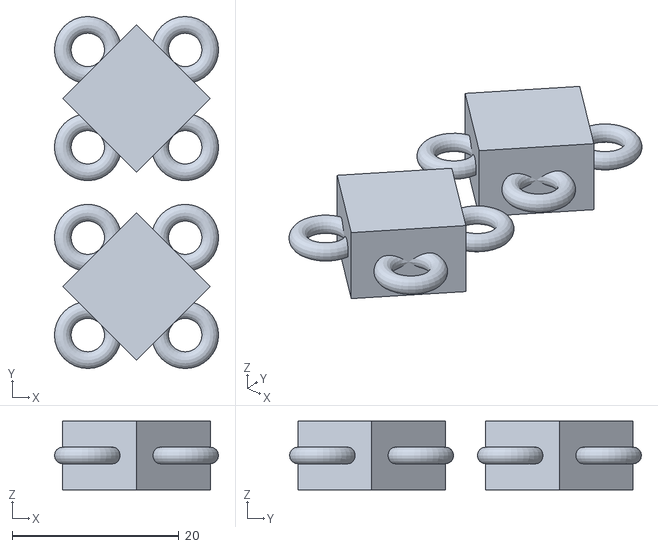
[picture p138: CAD file, 2025-08-16]
3D models for chainmail/henry designs/bi_flat_array_1by2.stl
19.7 x 42.2 x 8.26
