KuroBean/SURF-git/3D models for chainmail/hori verti single block/horizontal + vertical block no sensor.stl

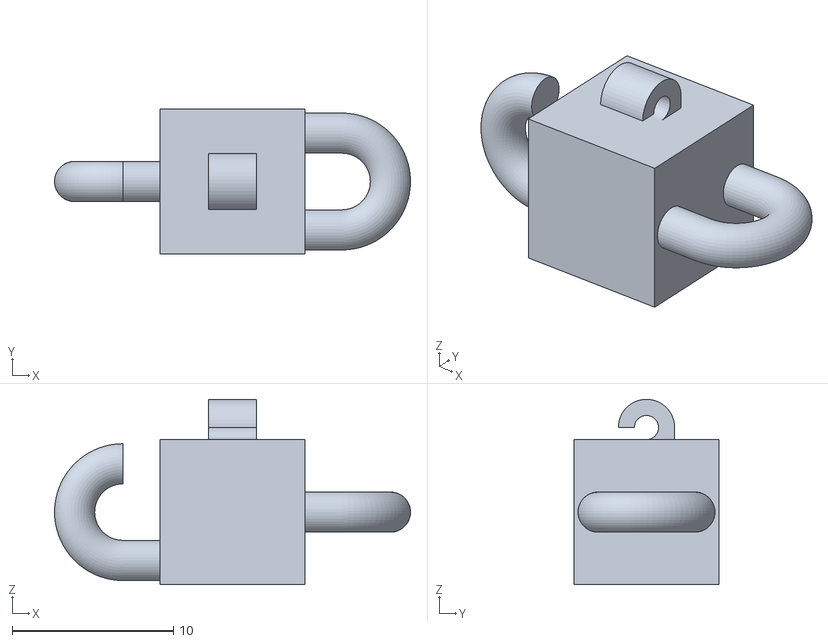
[picture p139: CAD file, 2026-04-09]
3D models for chainmail/hori verti single block/horizontal + vertical block no sensor.stl
22.1 x 9.00 x 11.5
