KuroBean/SURF-git/3D models for chainmail/metal loaded design bigger 3_2/striker with limiter/Striker holder v5.stl

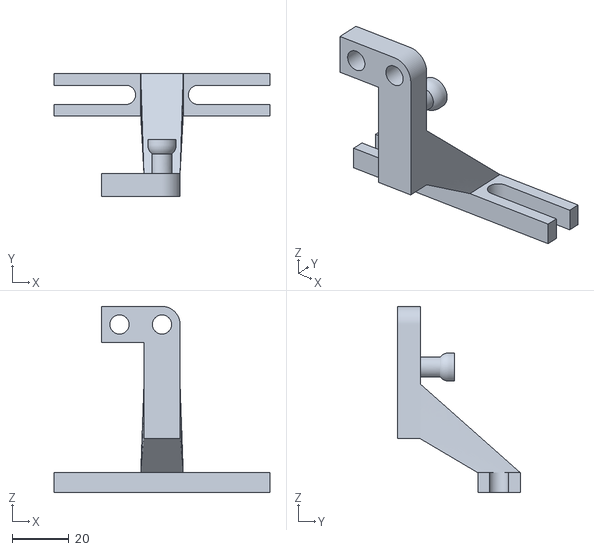
[picture p140: CAD file, 2026-04-21]
3D models for chainmail/metal loaded design bigger 3_2/striker with limiter/Striker holder v5.stl
76.2 x 43.3 x 65.7
