KuroBean/SURF-git/3D models for chainmail/metal loaded design bigger 3_2/TOO SMALL SENSOR BROKE metal cube sensor horizontal + vertical block 1d.stl

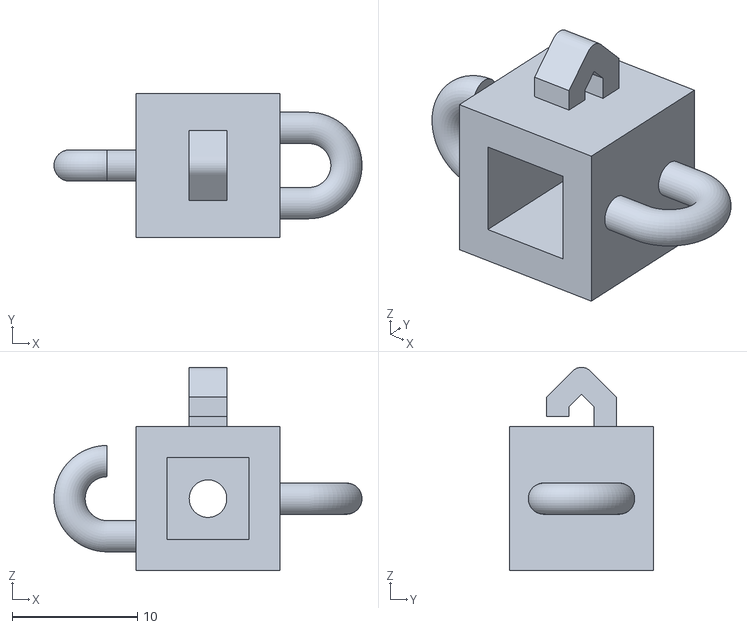
[picture p141: CAD file, 2026-04-09]
3D models for chainmail/metal loaded design bigger 3_2/TOO SMALL SENSOR BROKE metal cube sensor horizontal + vertical block 1d.stl
24.6 x 11.5 x 16.2
