KuroBean/SURF-git/3D models for chainmail/sensor with actuator holder/load sensor actuator holder.stl

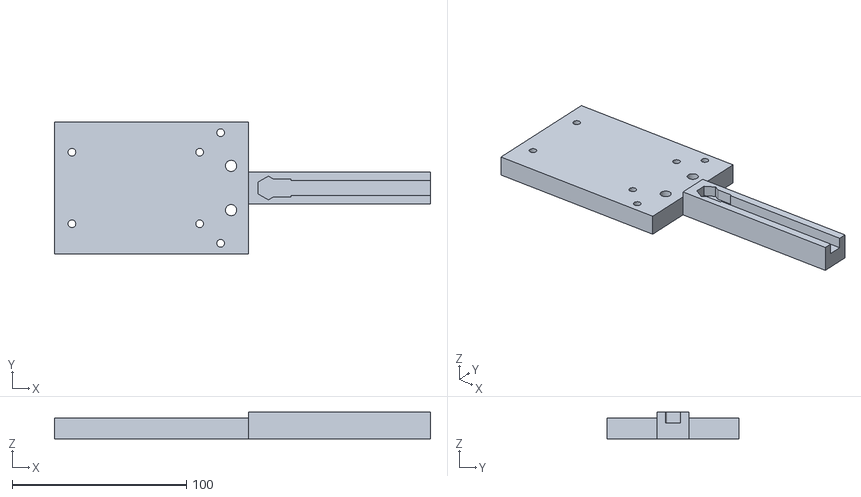
[picture p142: CAD file, 2025-08-16]
3D models for chainmail/sensor with actuator holder/load sensor actuator holder.stl
215.5 x 75.4 x 15.3
