KuroBean/SURF-git/3D models for chainmail/v2 long rings and smaller/horizontal ring block v1 v3.stl

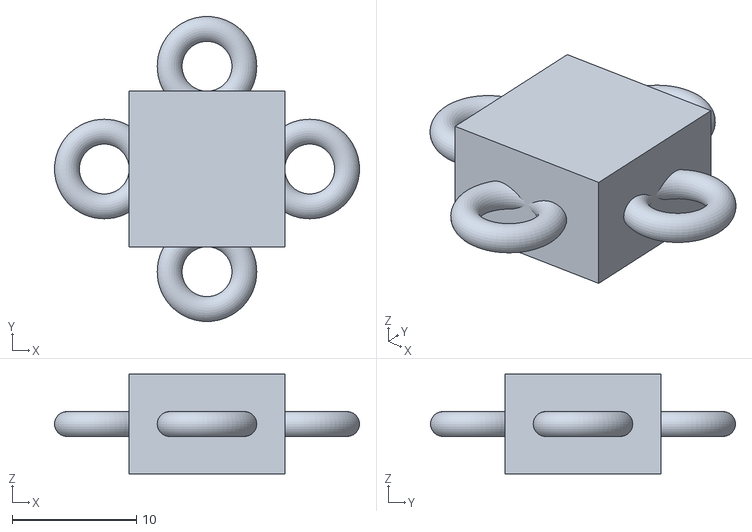
[picture p143: CAD file, 2025-08-16]
3D models for chainmail/v2 long rings and smaller/horizontal ring block v1 v3.stl
24.5 x 24.5 x 8.00
