KuroBean/SURF-git/3D models for chainmail/1D diag ring blocks/1D chain with tensioning v6.stl

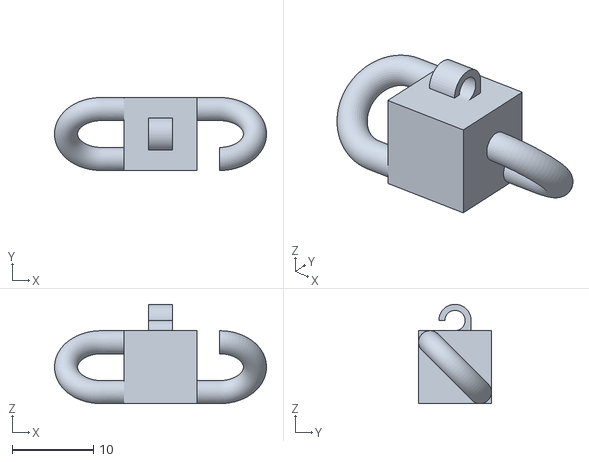
[picture p144: CAD file, 2026-04-09]
3D models for chainmail/1D diag ring blocks/1D chain with tensioning v6.stl
26.1 x 9.00 x 12.2
