KuroBean/SURF-git/3D models for chainmail/2d design/5 block boundary 1 hole thick  v4.stl

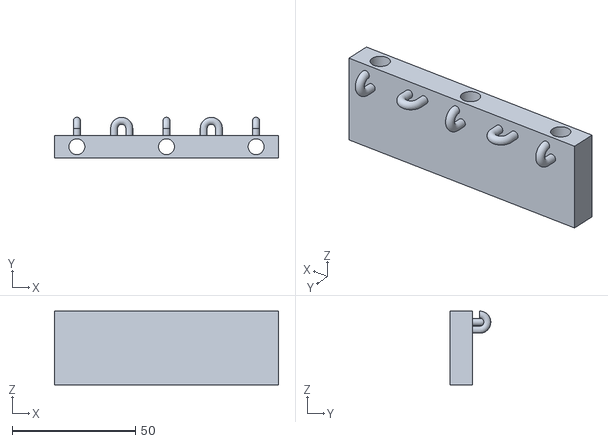
[picture p145: CAD file, 2025-08-16]
3D models for chainmail/2d design/5 block boundary 1 hole thick v4.stl
91.0 x 16.5 x 30.0
