KuroBean/SURF-git/3D models for chainmail/6_24 even smaller rings and tol/Hook vertical block cyl hook v9 withs ensor hole.stl

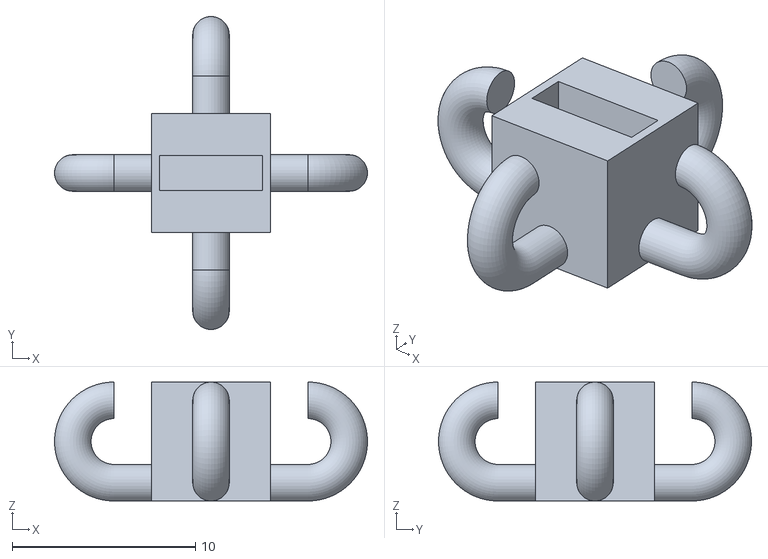
[picture p146: CAD file, 2025-08-16]
3D models for chainmail/6_24 even smaller rings and tol/Hook vertical block cyl hook v9 withs ensor hole.stl
17.1 x 17.1 x 6.50
