KuroBean/SURF-git/3D models for chainmail/henry designs/bi_out_array_1by2.stl

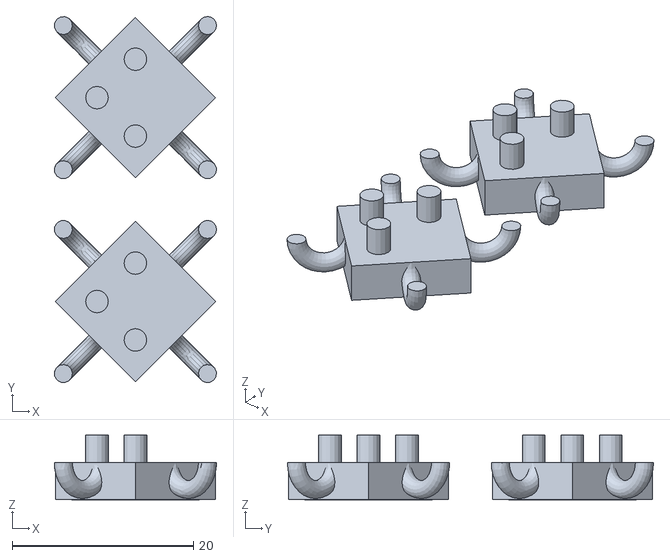
[picture p148: CAD file, 2025-08-16]
3D models for chainmail/henry designs/bi_out_array_1by2.stl
17.9 x 40.4 x 7.14
