KuroBean/SURF-git/3D models for chainmail/hori verti single block/horizontal + vertical block sensor block 1d v4.stl

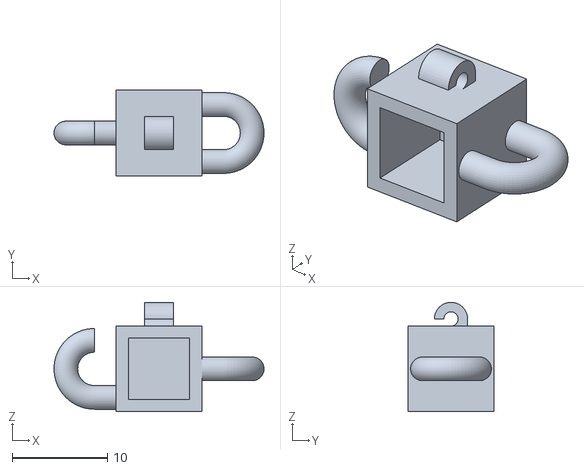
[picture p149: CAD file, 2026-04-09]
3D models for chainmail/hori verti single block/horizontal + vertical block sensor block 1d v4.stl
22.1 x 9.00 x 11.5
