KuroBean/SURF-git/3D models for chainmail/metal loaded design bigger 3_2/striker with limiter/angle limiter v1.stl

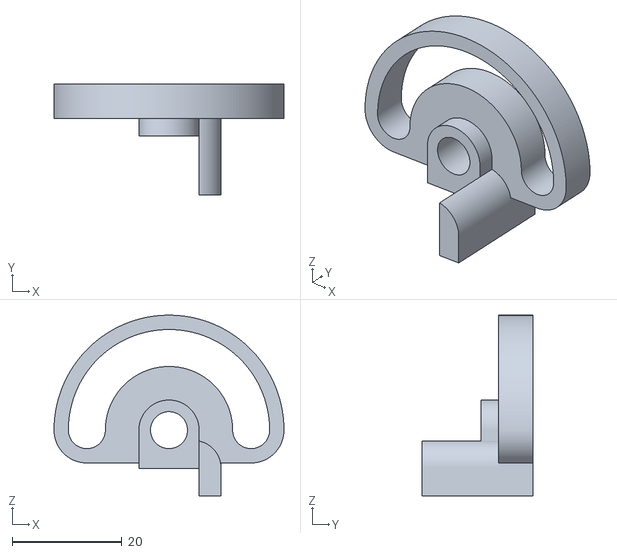
[picture p150: CAD file, 2026-04-21]
3D models for chainmail/metal loaded design bigger 3_2/striker with limiter/angle limiter v1.stl
42.0 x 20.3 x 33.0
