KuroBean/SURF-git/3D models for chainmail/metal loaded design bigger 3_2/string holder vert HOOK 3 hole wide.stl

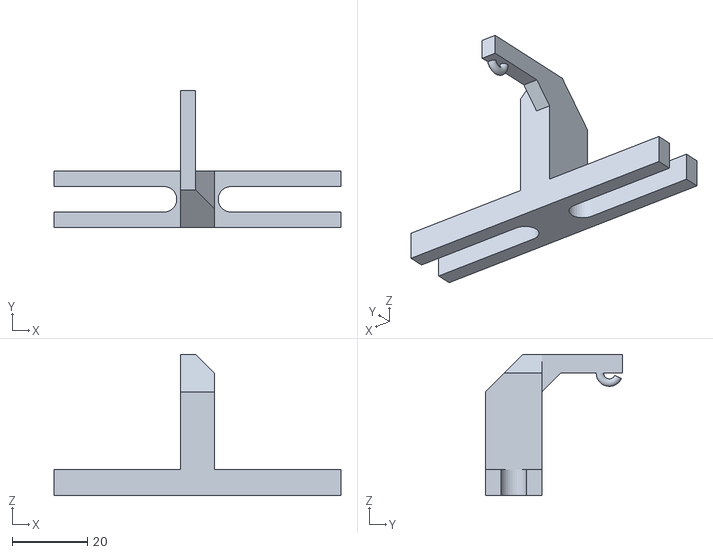
[picture p151: CAD file, 2026-04-09]
3D models for chainmail/metal loaded design bigger 3_2/string holder vert HOOK 3 hole wide.stl
76.2 x 36.4 x 37.5
