KuroBean/SURF-git/3D models for chainmail/sensor with actuator holder/load sensor to actuator adapter.stl

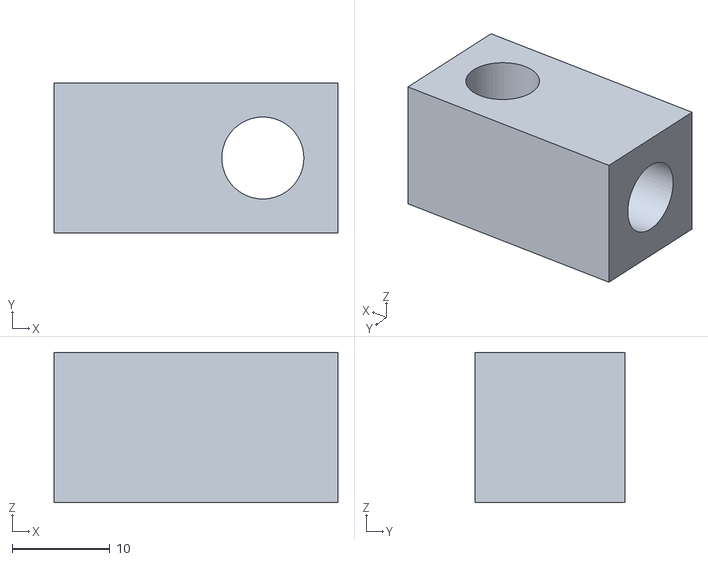
[picture p152: CAD file, 2025-08-16]
3D models for chainmail/sensor with actuator holder/load sensor to actuator adapter.stl
29.1 x 15.4 x 15.4
