KuroBean/SURF-git/3D models for chainmail/single block design 11_16/string holder 2 hole long.stl

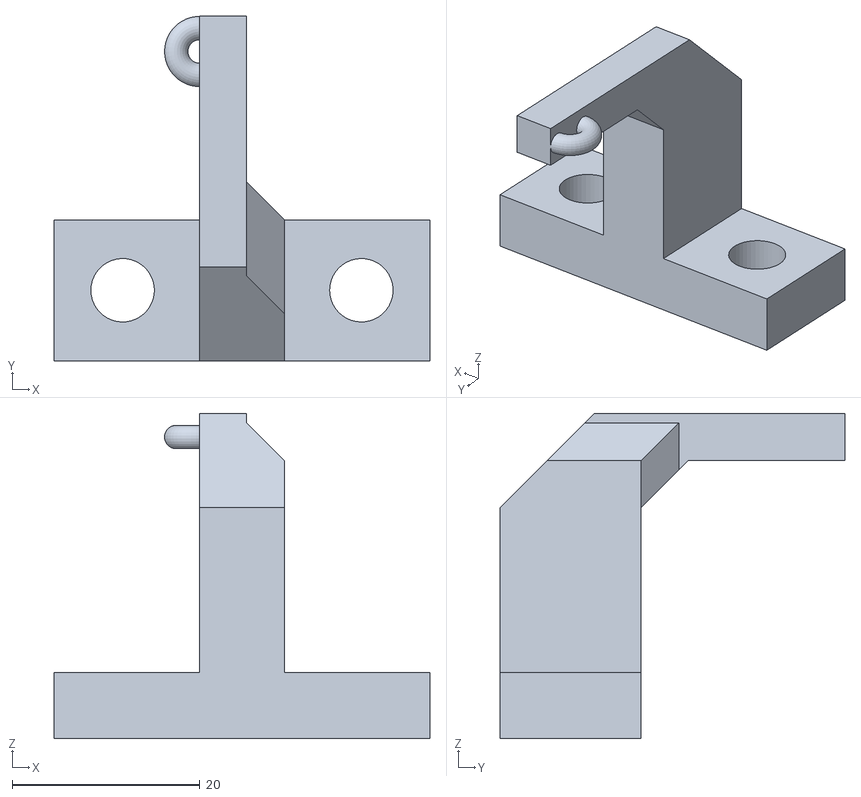
[picture p153: CAD file, 2026-04-09]
3D models for chainmail/single block design 11_16/string holder 2 hole long.stl
40.0 x 36.7 x 34.6
