KuroBean/SURF-git/3D models for chainmail/v2 long rings and smaller/vertical ring bottom half square.stl

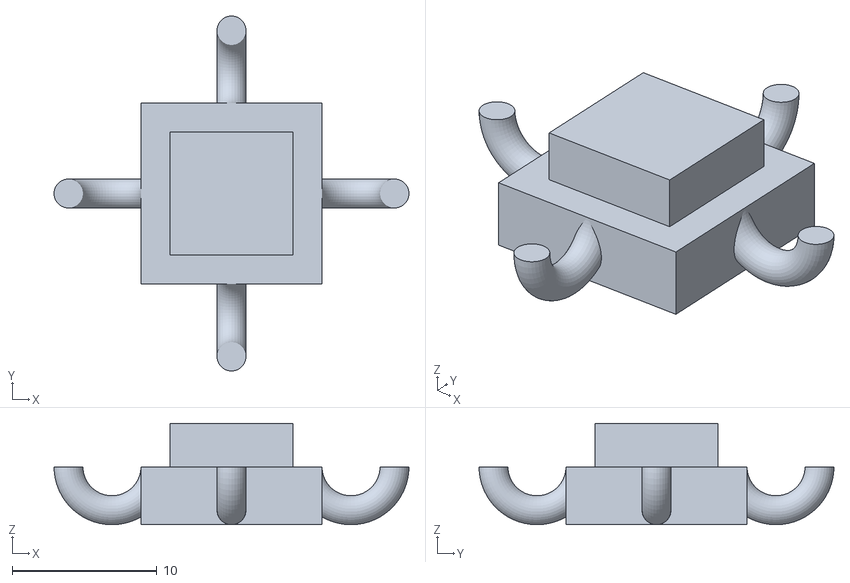
[picture p154: CAD file, 2025-08-16]
3D models for chainmail/v2 long rings and smaller/vertical ring bottom half square.stl
24.5 x 24.5 x 7.00
