KuroBean/SURF-git/3D models for chainmail/2d design/2d block actuator verti boundary block v2.stl

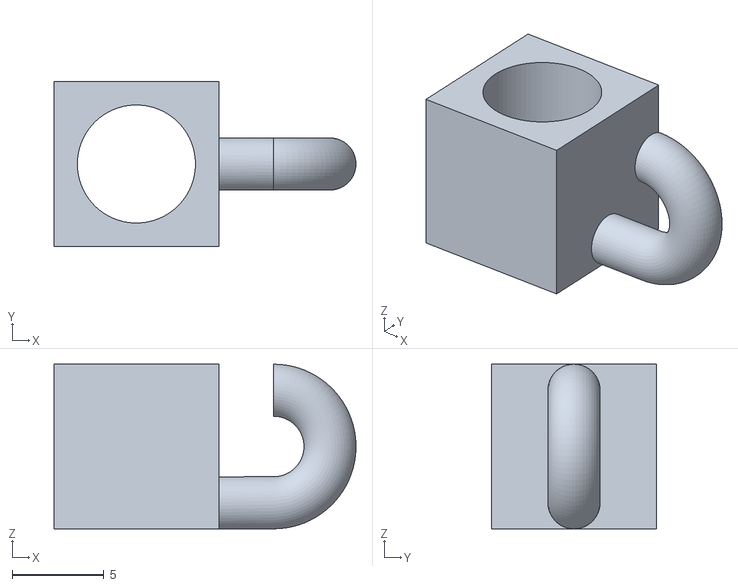
[picture p156: CAD file, 2025-08-16]
3D models for chainmail/2d design/2d block actuator verti boundary block v2.stl
16.5 x 9.00 x 9.00
