KuroBean/SURF-git/3D models for chainmail/6_25 for metal 3d print and lab sensors/Hook vertical cyl sensor hole v10_.stl

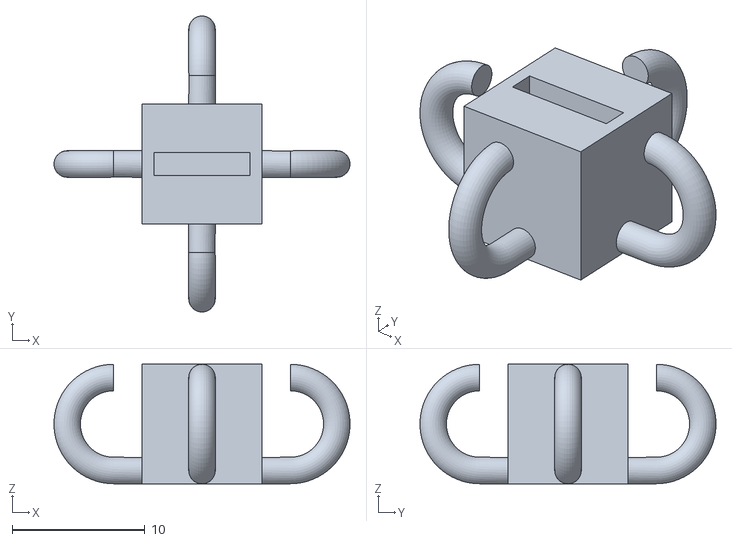
[picture p158: CAD file, 2025-08-16]
3D models for chainmail/6_25 for metal 3d print and lab sensors/Hook vertical cyl sensor hole v10_.stl
22.3 x 22.3 x 9.00
