KuroBean/SURF-git/3D models for chainmail/6_26 bigger r for metla 3d print/Hook vertical block cyl hook v14.stl

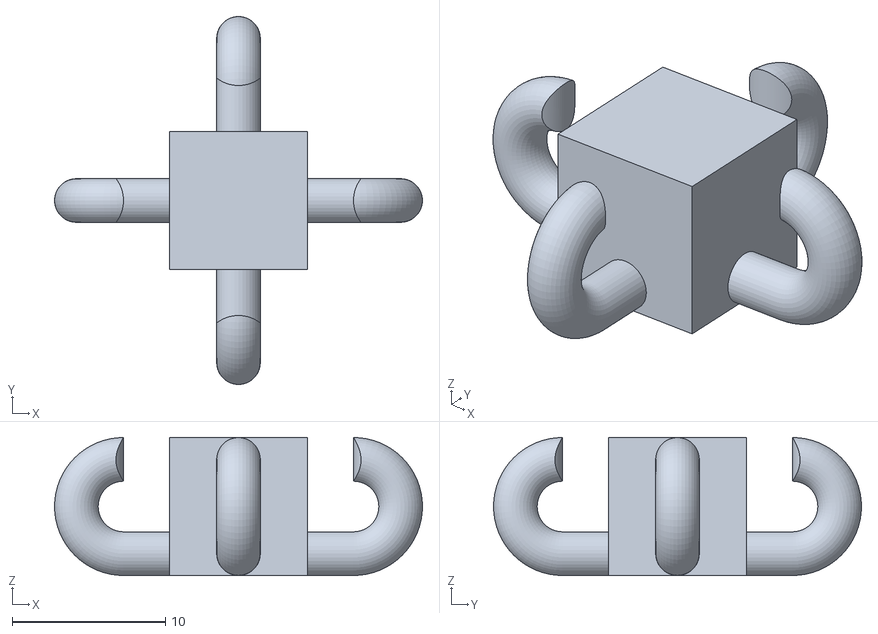
[picture p159: CAD file, 2025-08-16]
3D models for chainmail/6_26 bigger r for metla 3d print/Hook vertical block cyl hook v14.stl
24.0 x 24.0 x 9.00
