KuroBean/SURF-git/3D models for chainmail/ring blocks/7_1 to 21 design/horizontal ring block cyl v11 sensor hole.stl

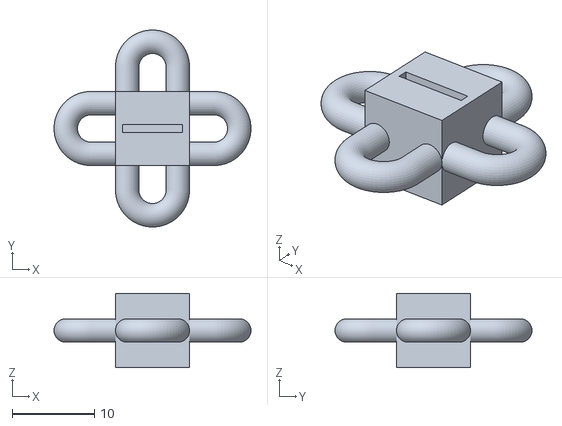
[picture p160: CAD file, 2025-08-16]
3D models for chainmail/ring blocks/7_1 to 21 design/horizontal ring block cyl v11 sensor hole.stl
23.9 x 23.9 x 9.00
