KuroBean/SURF-git/3D models for chainmail/v2 long rings and smaller/top vertical ring small.stl

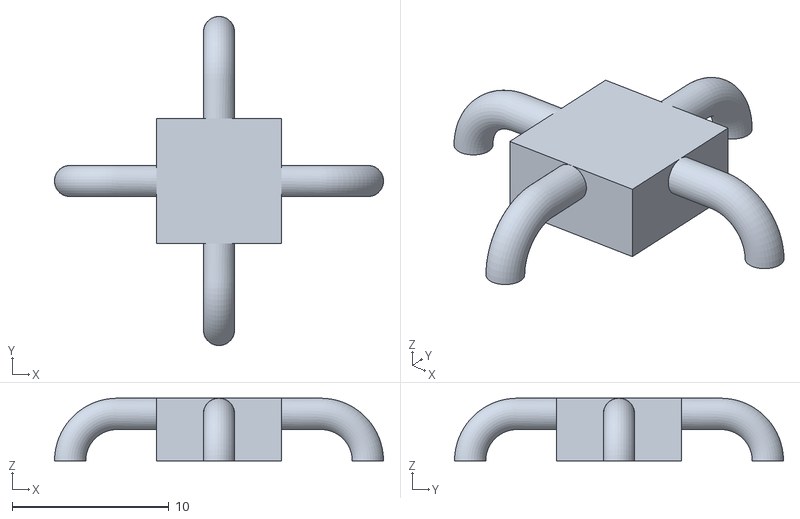
[picture p162: CAD file, 2025-08-16]
3D models for chainmail/v2 long rings and smaller/top vertical ring small.stl
21.0 x 21.0 x 4.00
