KuroBean/SURF-git/3D models for chainmail/1D diag ring blocks/diag boundary blocks and ring blocks.3mf

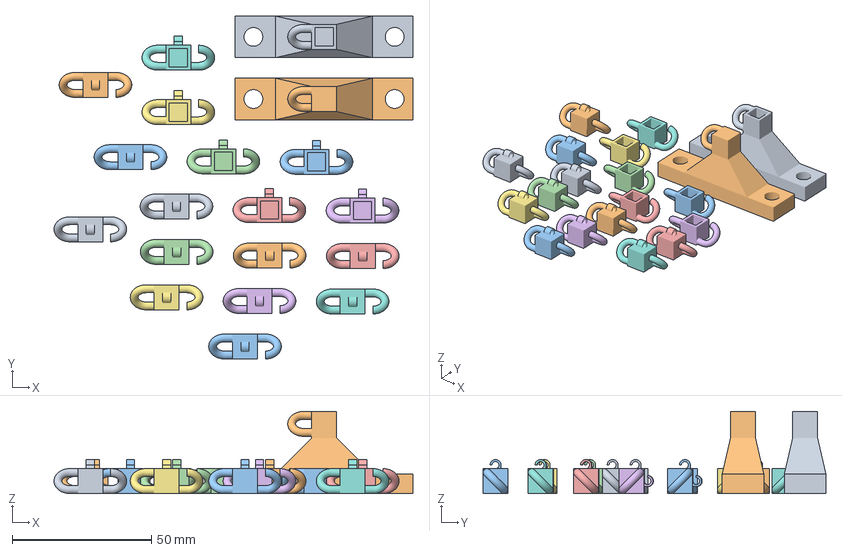
[picture p163: CAD file, 2026-04-09]
3D models for chainmail/1D diag ring blocks/diag boundary blocks and ring blocks.3mf
129.1 x 123.4 x 29.6 mm
boundary diag block accelerometer hole v3.stl
boundary diag block.stl
1D diag ring block sensor hole v6.stl x 6
1D chain with tensioning v6.stl x 11
