KuroBean/SURF-git/3D models for chainmail/6_24 even smaller rings and tol/horizontal ring block cyl v5 with sensor hole.stl

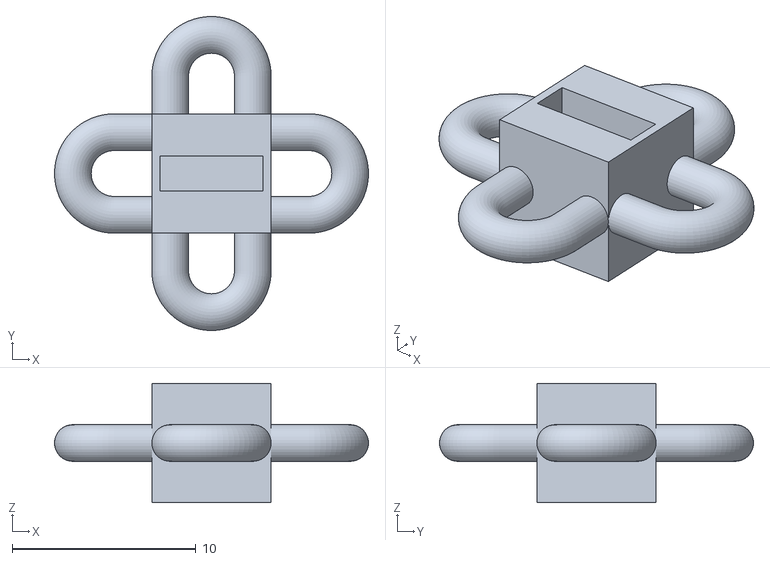
[picture p164: CAD file, 2025-08-16]
3D models for chainmail/6_24 even smaller rings and tol/horizontal ring block cyl v5 with sensor hole.stl
17.1 x 17.1 x 6.50
