KuroBean/SURF-git/3D models for chainmail/metal loaded design bigger 3_2/striker box metal unit top open v5.stl

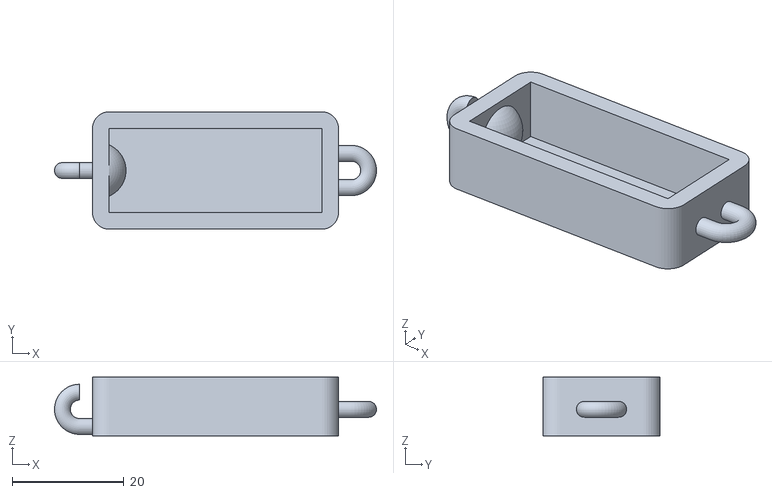
[picture p166: CAD file, 2026-04-09]
3D models for chainmail/metal loaded design bigger 3_2/striker box metal unit top open v5.stl
57.6 x 21.0 x 10.5
