KuroBean/SURF-git/3D models for chainmail/metal loaded design bigger 3_2/striker with limiter/striker hammer v6.stl

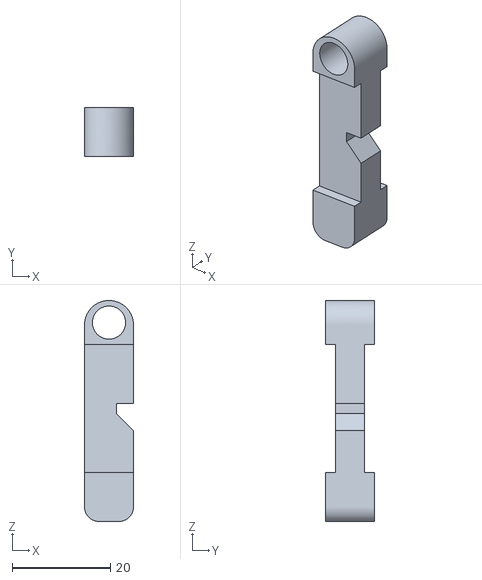
[picture p167: CAD file, 2026-04-21]
3D models for chainmail/metal loaded design bigger 3_2/striker with limiter/striker hammer v6.stl
10.0 x 10.0 x 45.0
