KuroBean/SURF-git/3D models for chainmail/single block design 11_16/horizontal + vertical block 1d sensor hole 6.55.3mf

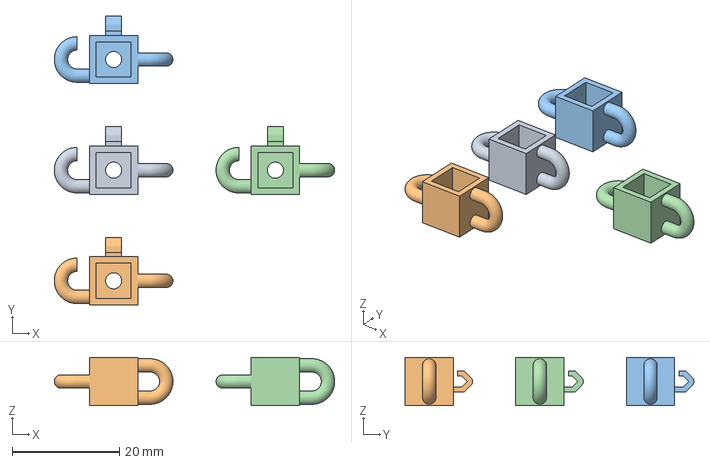
[picture p168: CAD file, 2026-04-09]
3D models for chainmail/single block design 11_16/horizontal + vertical block 1d sensor hole 6.55.3mf
52.2 x 53.8 x 9.00 mm
