KuroBean/SURF-git/3D models for chainmail/v2 long rings and smaller/Hook vertical ring cyl hook small.stl

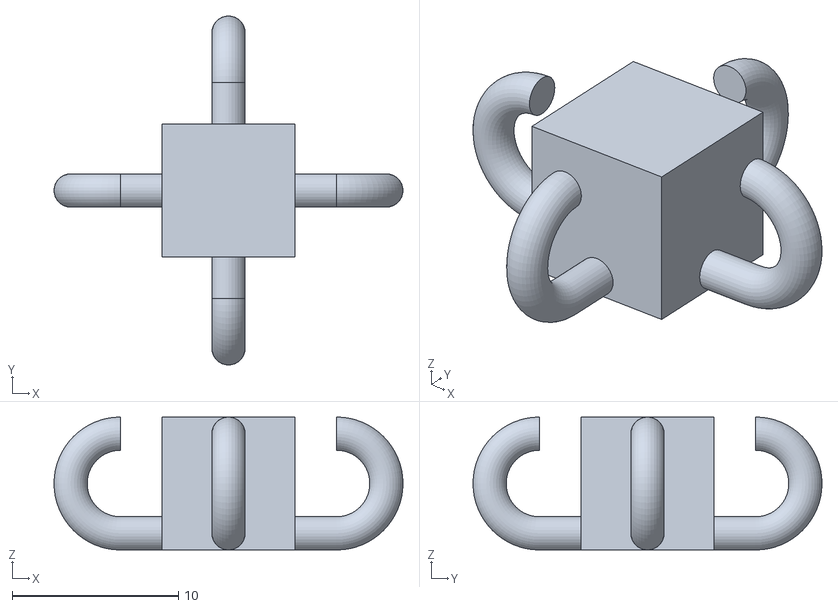
[picture p169: CAD file, 2025-08-16]
3D models for chainmail/v2 long rings and smaller/Hook vertical ring cyl hook small.stl
21.0 x 21.0 x 8.00
