KuroBean/SURF-git/3D models for chainmail/1D diag ring blocks/boundary diag block.stl

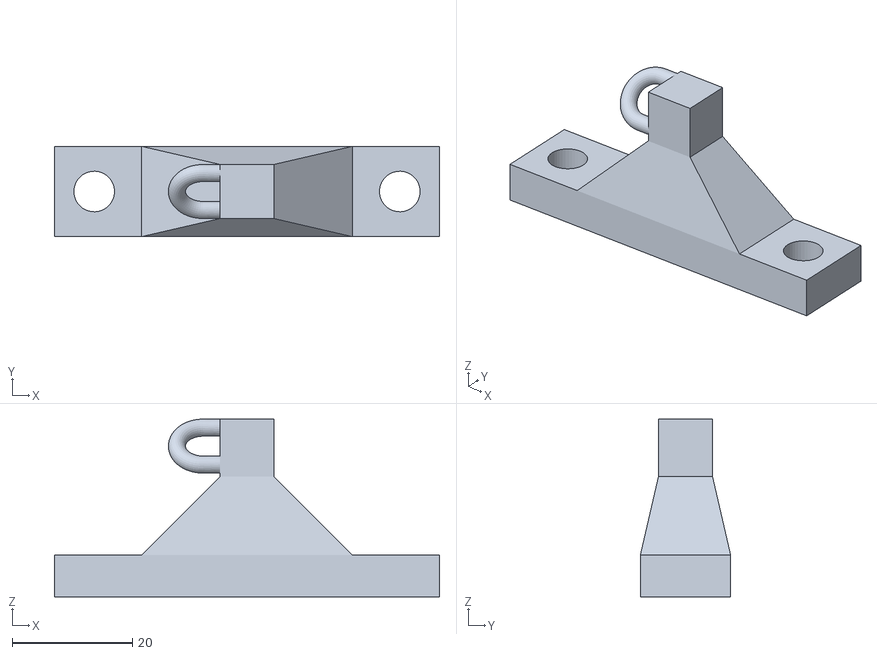
[picture p170: CAD file, 2026-04-09]
3D models for chainmail/1D diag ring blocks/boundary diag block.stl
64.0 x 15.0 x 29.6
