KuroBean/SURF-git/3D models for chainmail/6_24 even smaller rings and tol/top vert ring new tol.stl

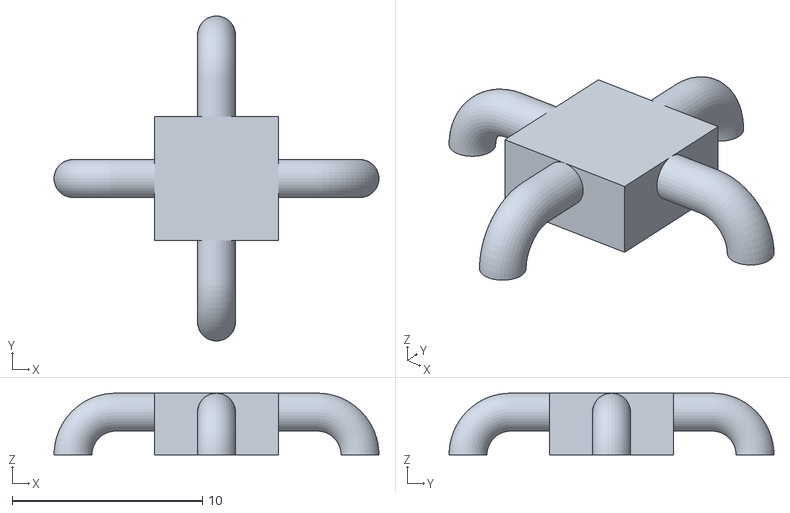
[picture p171: CAD file, 2025-08-16]
3D models for chainmail/6_24 even smaller rings and tol/top vert ring new tol.stl
17.1 x 17.1 x 3.25
