KuroBean/SURF-git/3D models for chainmail/boundary blocks/verti boundary block v2 small hole and should be ok hole.3mf

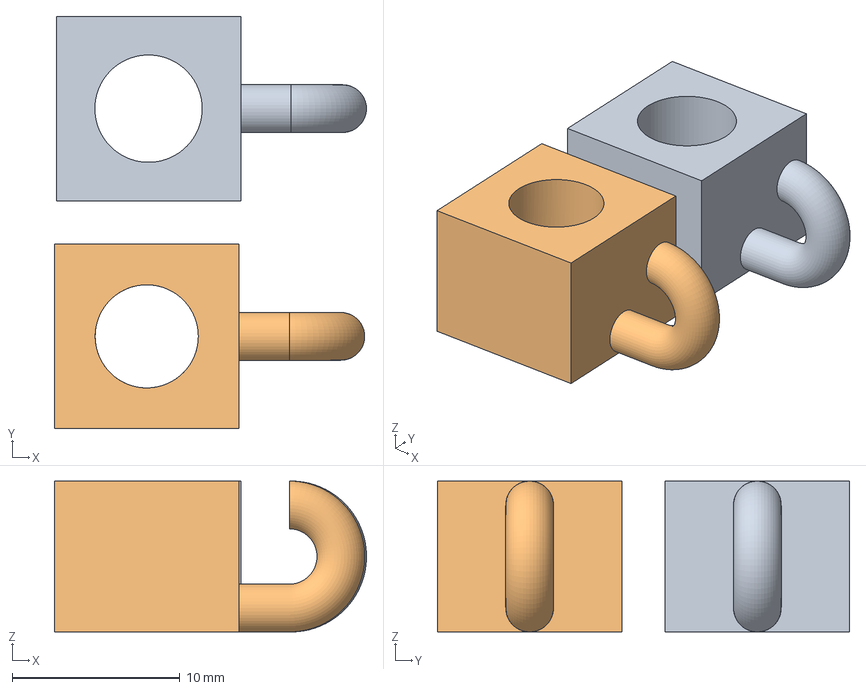
[picture p172: CAD file, 2025-08-16]
3D models for chainmail/boundary blocks/verti boundary block v2 small hole and should be ok hole.3mf
18.6 x 24.6 x 9.00 mm
verti boundary block v2.stl
verti boundary block v2 small hole.stl
