KuroBean/SURF-git/3D models for chainmail/sensor with actuator holder/S load sensor actuator holder.stl

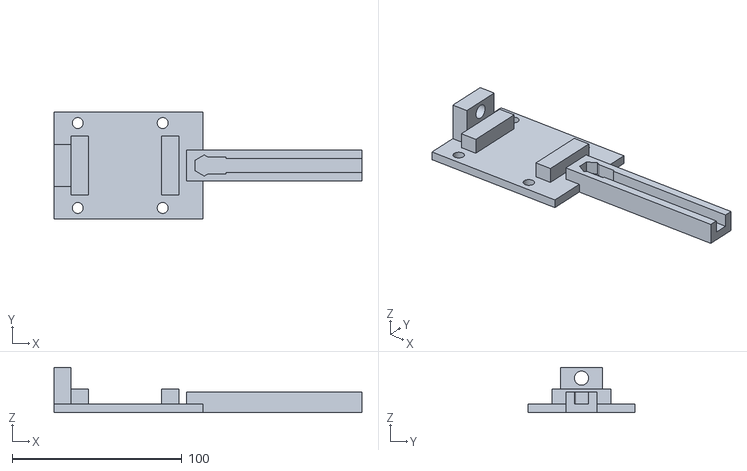
[picture p173: CAD file, 2025-08-16]
3D models for chainmail/sensor with actuator holder/S load sensor actuator holder.stl
181.4 x 63.0 x 26.8
