KuroBean/SURF-git/3D models for chainmail/v2 long rings and smaller/upper half vertical ring block.stl

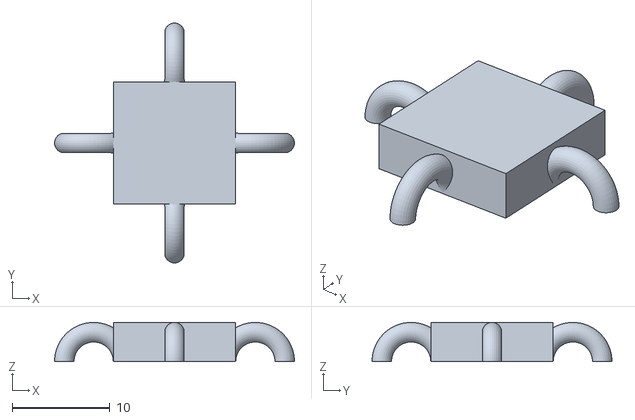
[picture p175: CAD file, 2025-08-16]
3D models for chainmail/v2 long rings and smaller/upper half vertical ring block.stl
24.5 x 24.5 x 4.00
