KuroBean/SURF-git/3D models for chainmail/1D diag ring blocks/diag block 1d v9.stl

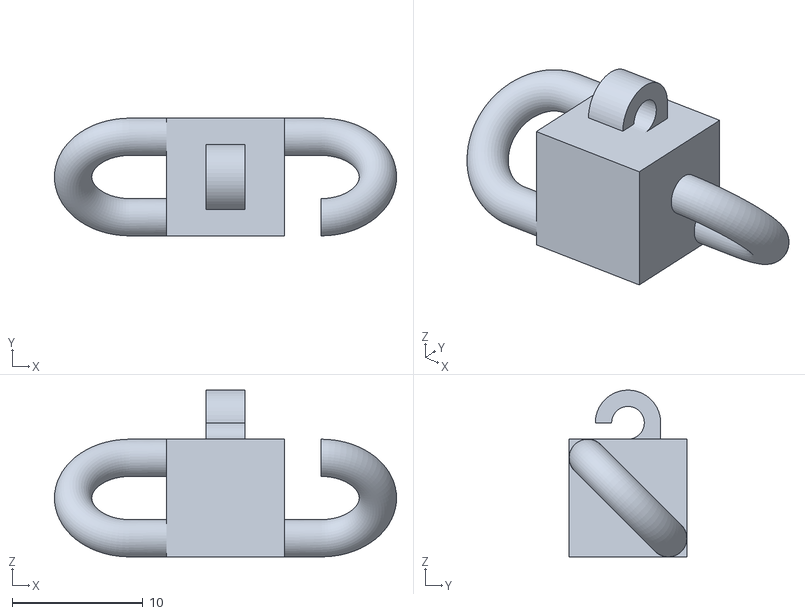
[picture p176: CAD file, 2026-04-09]
3D models for chainmail/1D diag ring blocks/diag block 1d v9.stl
26.1 x 9.00 x 12.8
