KuroBean/SURF-git/3D models for chainmail/boundary blocks/junction ring v1.stl

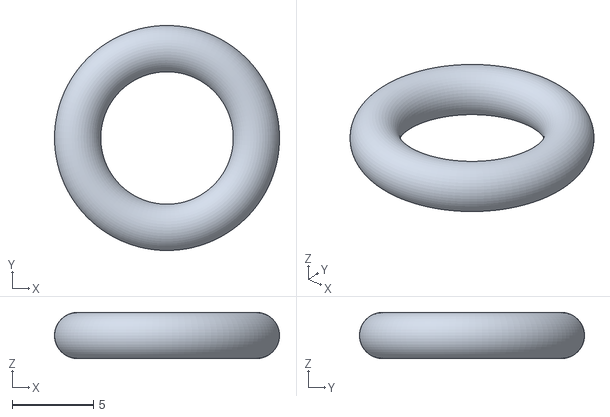
[picture p177: CAD file, 2025-08-16]
3D models for chainmail/boundary blocks/junction ring v1.stl
13.8 x 13.8 x 2.85
