KuroBean/SURF-git/3D models for chainmail/metal loaded design bigger 3_2/Striker holder.stl

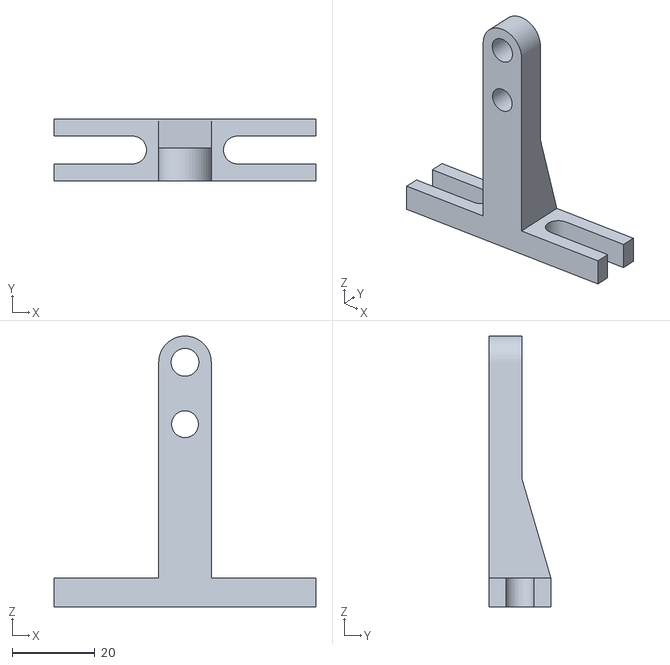
[picture p178: CAD file, 2026-04-09]
3D models for chainmail/metal loaded design bigger 3_2/Striker holder.stl
63.5 x 15.0 x 65.7
