KuroBean/SURF-git/3D models for chainmail/single block design 11_16/striker box top open v1.stl

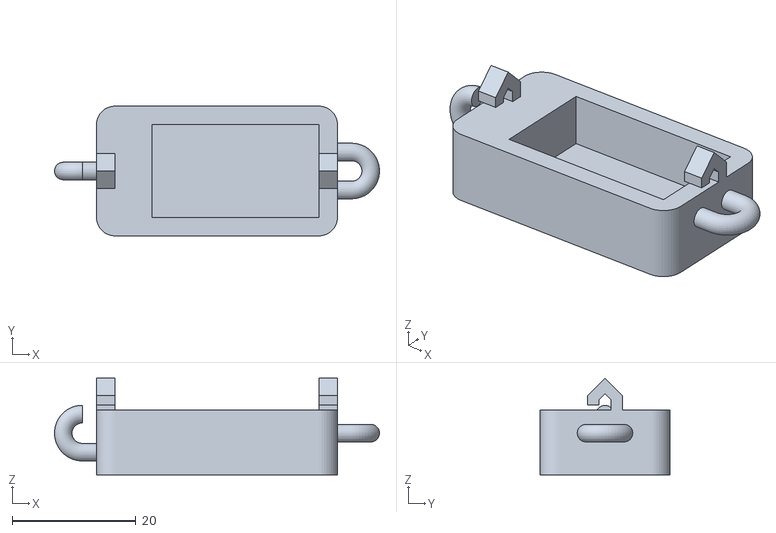
[picture p179: CAD file, 2026-04-09]
3D models for chainmail/single block design 11_16/striker box top open v1.stl
52.6 x 21.0 x 15.6
