KuroBean/SURF-git/3D models for chainmail/v2 long rings and smaller/horizontal ring small.stl

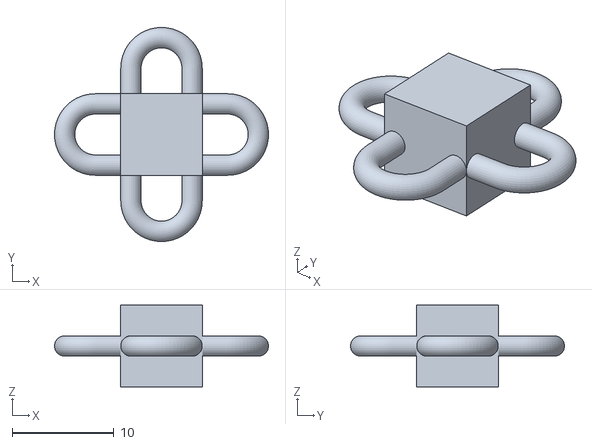
[picture p180: CAD file, 2025-08-16]
3D models for chainmail/v2 long rings and smaller/horizontal ring small.stl
21.0 x 21.0 x 8.00
