KuroBean/SURF-git/3D models for chainmail/1D diag ring blocks/boundary diag block accelerometer hole v3.stl

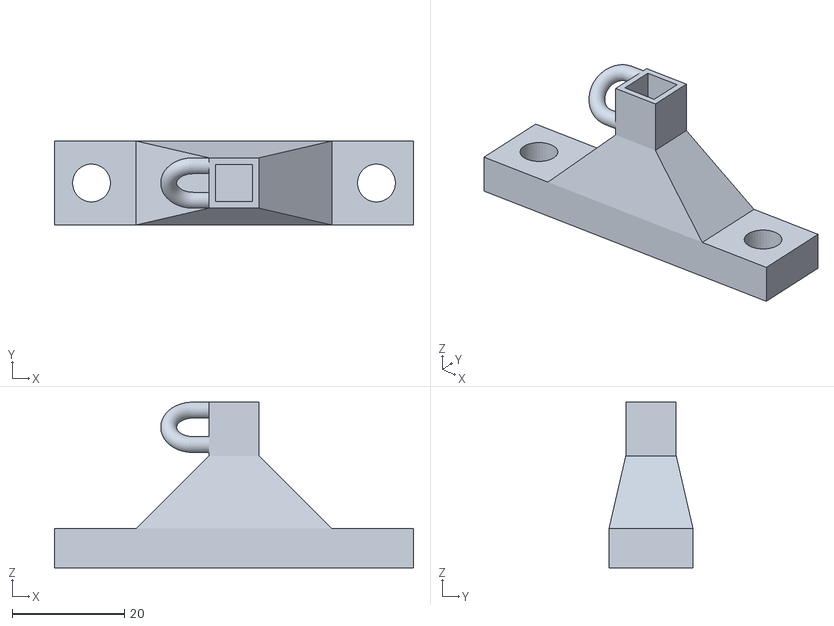
[picture p181: CAD file, 2026-04-09]
3D models for chainmail/1D diag ring blocks/boundary diag block accelerometer hole v3.stl
64.0 x 15.0 x 29.6
