KuroBean/SURF-git/3D models for chainmail/metal loaded design bigger 3_2/small pulley wheel.stl

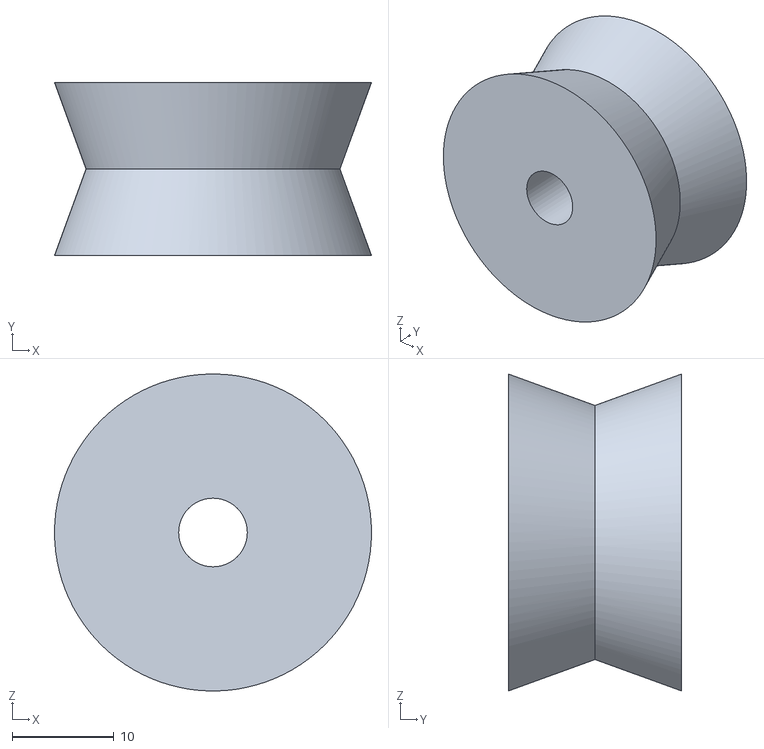
[picture p182: CAD file, 2026-04-09]
3D models for chainmail/metal loaded design bigger 3_2/small pulley wheel.stl
31.2 x 17.0 x 31.2
