KuroBean/SURF-git/3D models for chainmail/ring blocks/7_1 to 21 design/horizontal ring block cyl v11 no sensor.stl

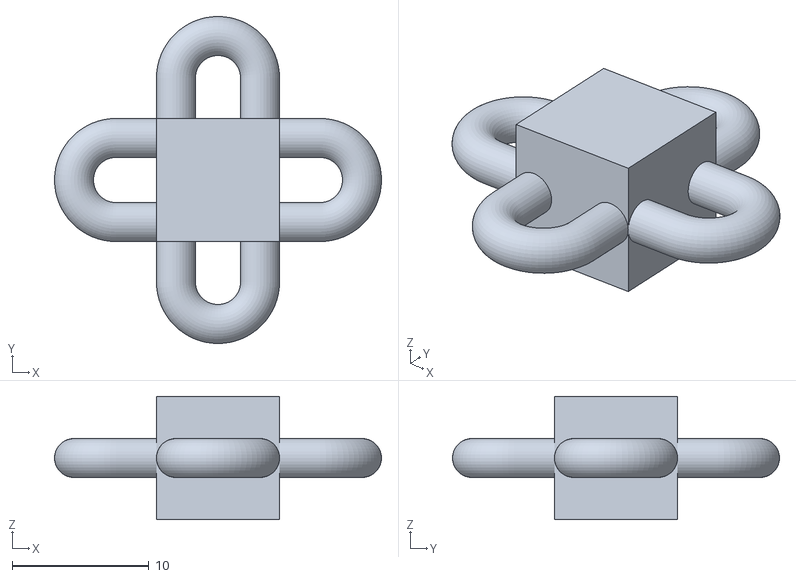
[picture p183: CAD file, 2025-08-16]
3D models for chainmail/ring blocks/7_1 to 21 design/horizontal ring block cyl v11 no sensor.stl
23.9 x 23.9 x 9.00
