KuroBean/SURF-git/3D models for chainmail/single block design 11_16/string holder 3 hole long  v 11_16.stl

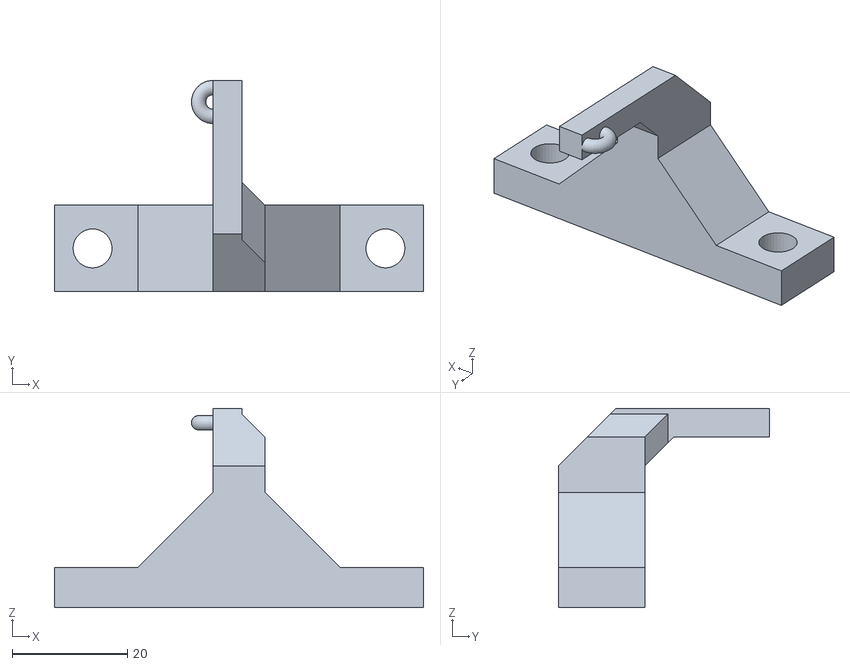
[picture p184: CAD file, 2026-04-09]
3D models for chainmail/single block design 11_16/string holder 3 hole long v 11_16.stl
64.0 x 36.7 x 34.6
