KuroBean/SURF-git/3D models for chainmail/1D diag ring blocks/1D chain with tensioning hole  v1.stl

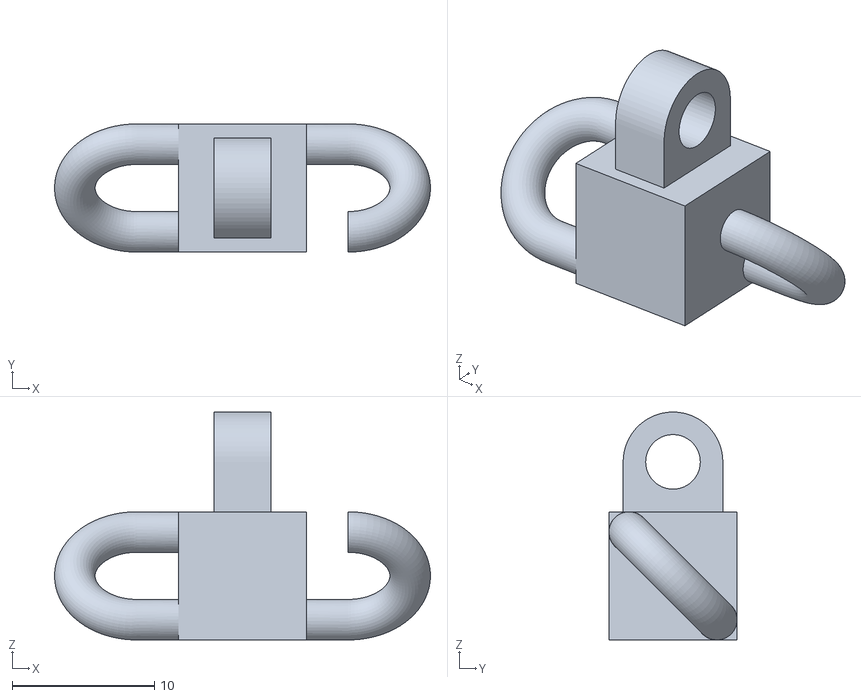
[picture p186: CAD file, 2026-04-09]
3D models for chainmail/1D diag ring blocks/1D chain with tensioning hole v1.stl
26.4 x 9.00 x 16.0
