KuroBean/SURF-git/3D models for chainmail/boundary blocks/horizontal ring block junction v2.stl

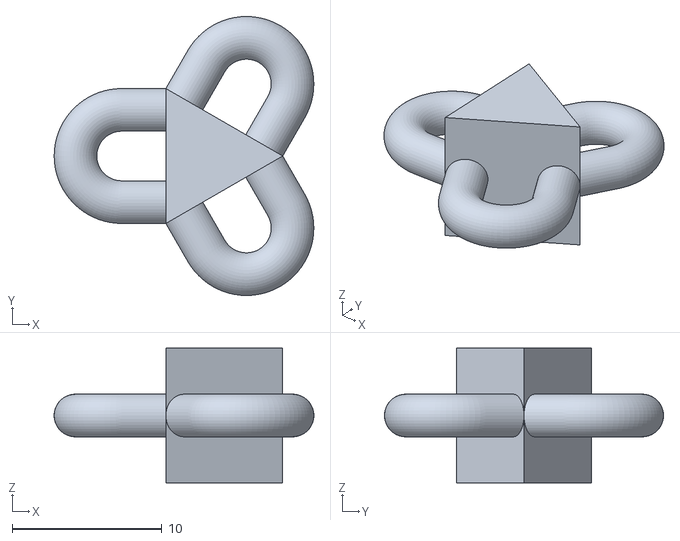
[picture p187: CAD file, 2025-08-16]
3D models for chainmail/boundary blocks/horizontal ring block junction v2.stl
17.3 x 18.6 x 9.00
