KuroBean/SURF-git/3D models for chainmail/ring blocks/7_1 to 21 design/2 and 3 linked rings for testing.3mf

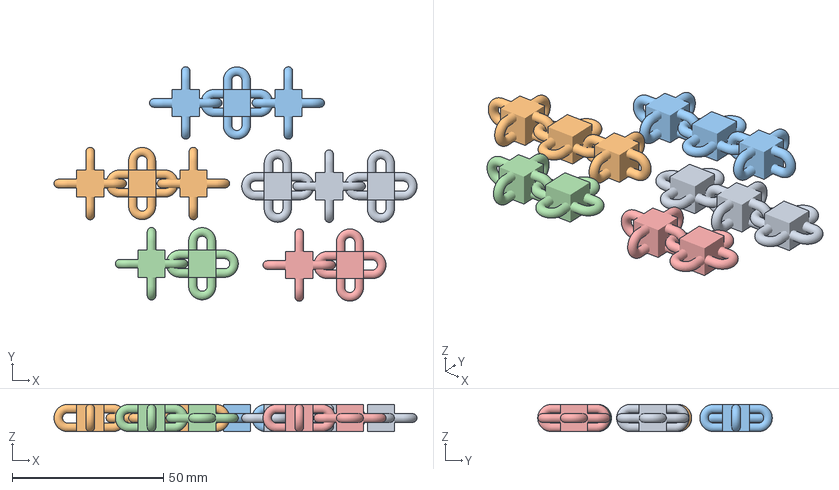
[picture p188: CAD file, 2025-08-16]
3D models for chainmail/ring blocks/7_1 to 21 design/2 and 3 linked rings for testing.3mf
120.1 x 77.6 x 9.00 mm
Assembly x 5
