KuroBean/SURF-git/3D models for chainmail/1D diag ring blocks/string holder v2 (WRONG DIM).stl

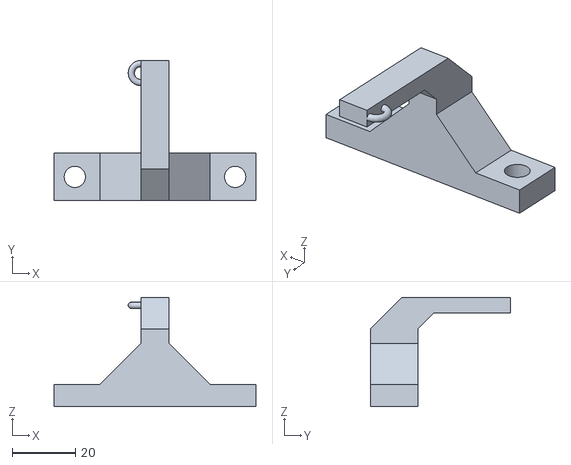
[picture p189: CAD file, 2026-04-09]
3D models for chainmail/1D diag ring blocks/string holder v2 (WRONG DIM).stl
64.0 x 44.4 x 34.6
