KuroBean/SURF-git/3D models for chainmail/boundary blocks/hori boundary block v5 0.2mm tol.stl

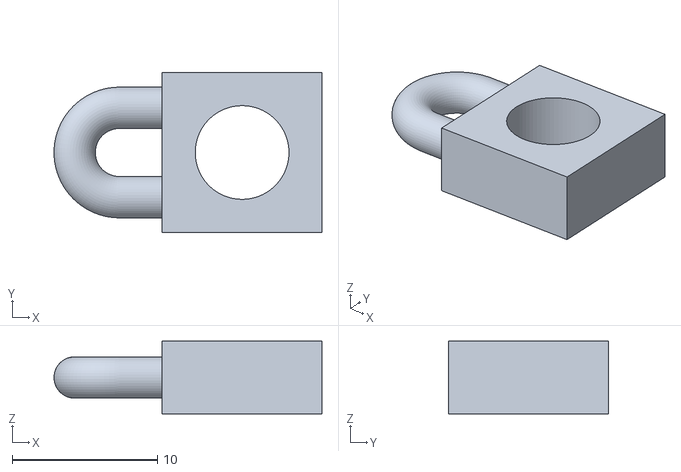
[picture p190: CAD file, 2025-08-16]
3D models for chainmail/boundary blocks/hori boundary block v5 0.2mm tol.stl
18.4 x 11.0 x 5.00
