KuroBean/SURF-git/3D models for chainmail/single block design 11_16/ramp long.stl

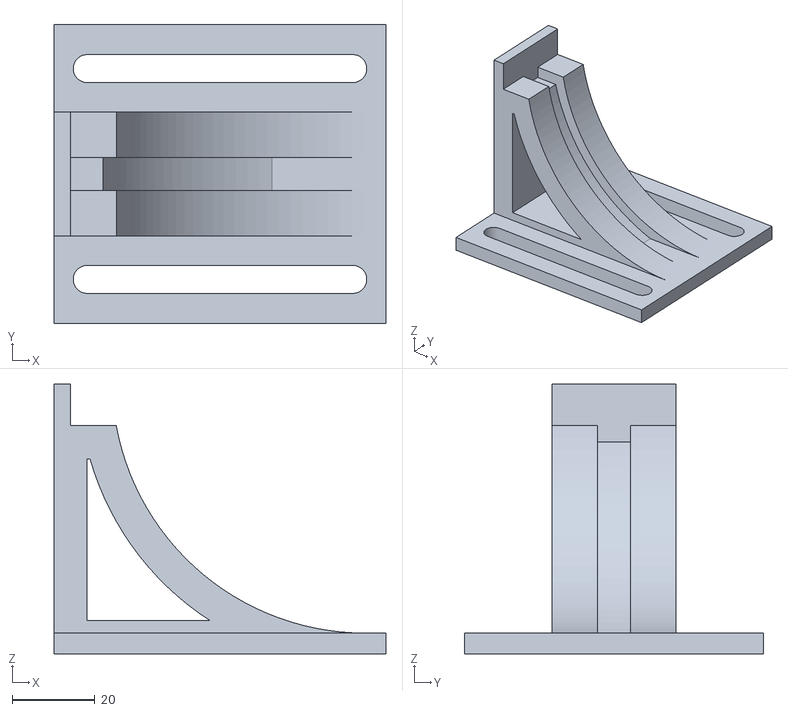
[picture p191: CAD file, 2026-04-09]
3D models for chainmail/single block design 11_16/ramp long.stl
80.0 x 72.0 x 65.0
