KuroBean/SURF-git/3D models for chainmail/metal loaded design bigger 3_2/small pulley wheel and such.3mf

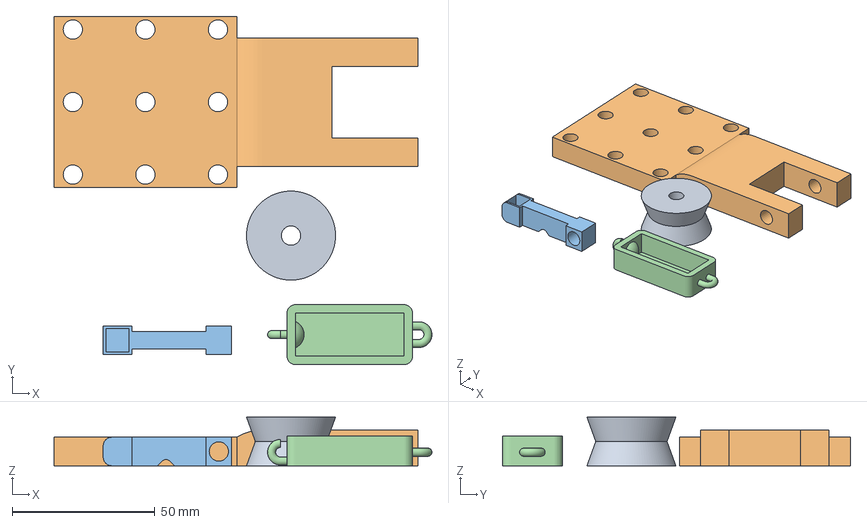
[picture p192: CAD file, 2026-04-09]
3D models for chainmail/metal loaded design bigger 3_2/small pulley wheel and such.3mf
132.4 x 121.9 x 17.0 mm
small pulley wheel.stl
small pulley holder.stl
striker hammer v3.stl
striker box metal unit top open v5.stl
