KuroBean/SURF-git/3D models for chainmail/single block design 11_16/horizontal + vertical block 1d v9 thicker top hook.stl

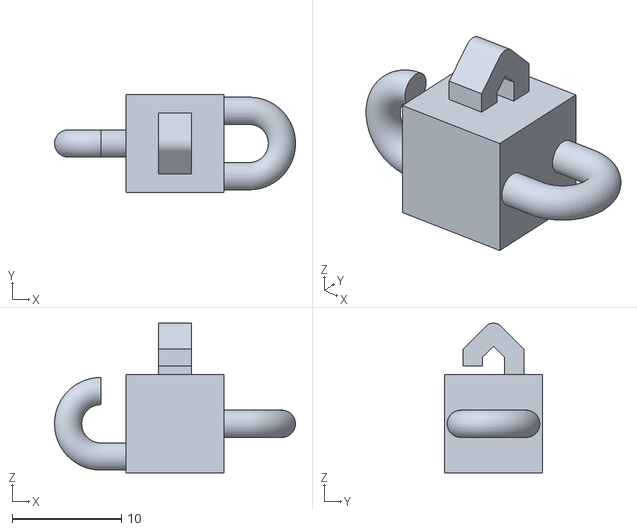
[picture p193: CAD file, 2026-04-09]
3D models for chainmail/single block design 11_16/horizontal + vertical block 1d v9 thicker top hook.stl
22.1 x 9.00 x 13.7
