KuroBean/SURF-git/3D models for chainmail/1D diag ring blocks/string holder v3 (correct dim.stl

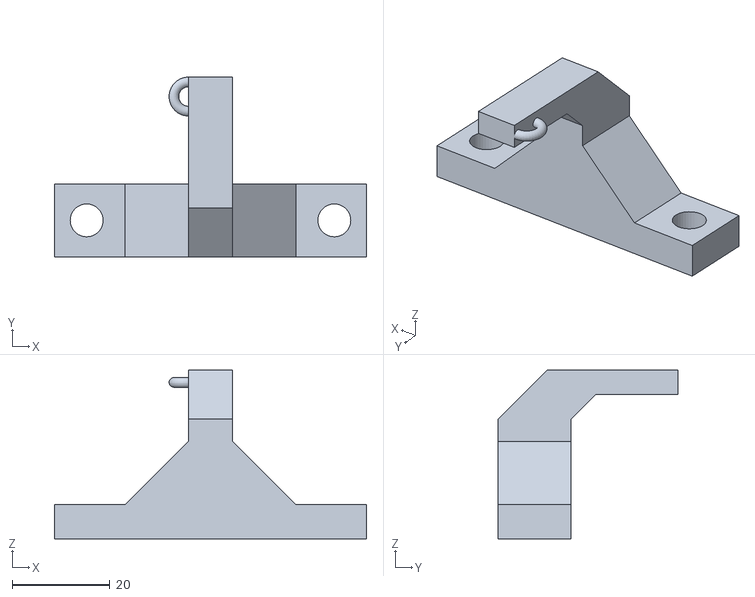
[picture p194: CAD file, 2026-04-09]
3D models for chainmail/1D diag ring blocks/string holder v3 (correct dim.stl
64.0 x 36.9 x 34.6
