KuroBean/SURF-git/3D models for chainmail/single block design 11_16/string holder 3 hoel long.3mf

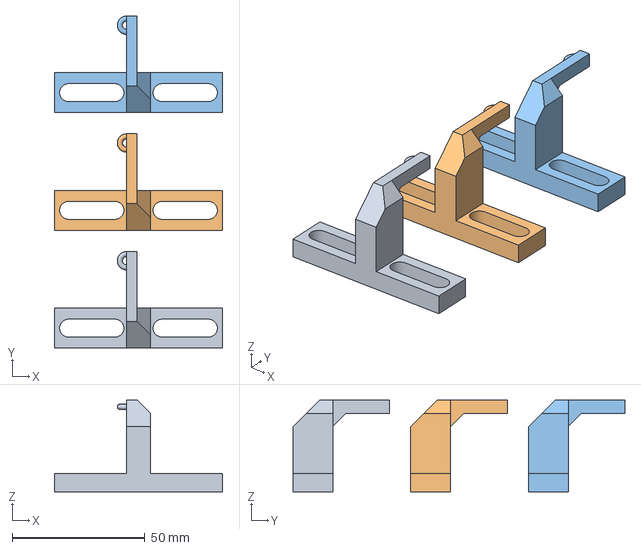
[picture p195: CAD file, 2026-04-09]
3D models for chainmail/single block design 11_16/string holder 3 hoel long.3mf
63.5 x 125.2 x 34.6 mm
