KuroBean/SURF-git/3D models for chainmail/1D diag ring blocks/diag block 1d  sensor hole v8 thicker top hook.stl

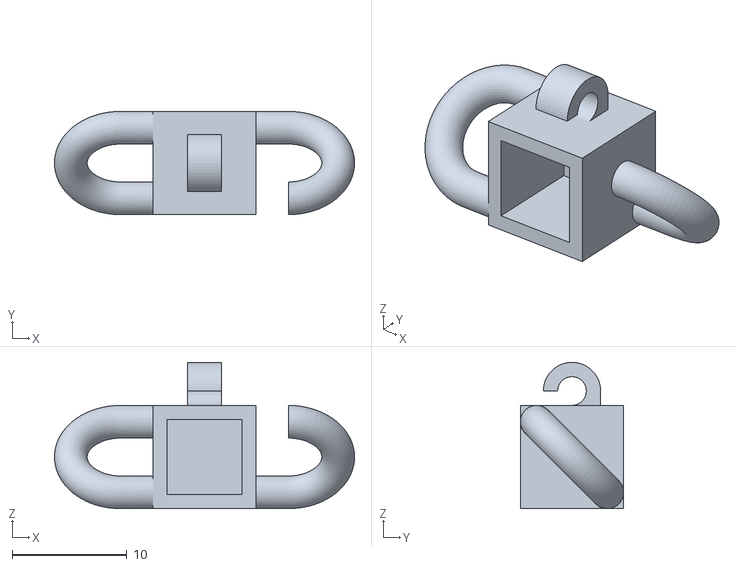
[picture p196: CAD file, 2026-04-09]
3D models for chainmail/1D diag ring blocks/diag block 1d sensor hole v8 thicker top hook.stl
26.1 x 9.00 x 12.8
