KuroBean/SURF-git/3D models for chainmail/metal loaded design bigger 3_2/small pulley holder.stl

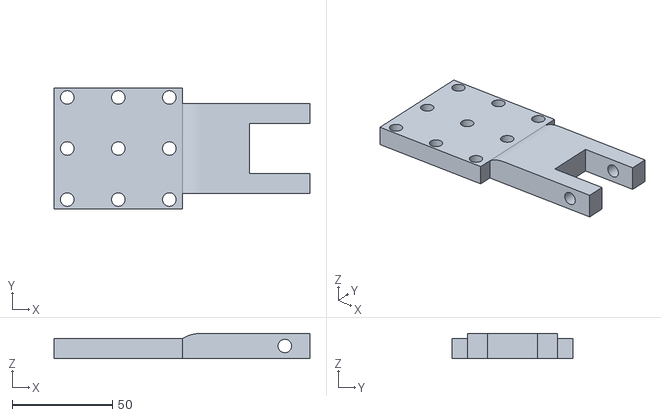
[picture p197: CAD file, 2026-04-09]
3D models for chainmail/metal loaded design bigger 3_2/small pulley holder.stl
127.4 x 60.0 x 12.5
