KuroBean/SURF-git/3D models for chainmail/single block design 11_16/striker box.stl

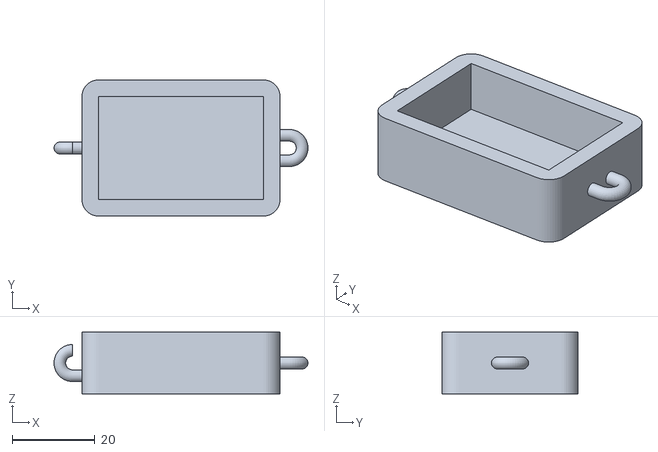
[picture p198: CAD file, 2026-04-09]
3D models for chainmail/single block design 11_16/striker box.stl
61.6 x 33.0 x 15.0
