KuroBean/SURF-git/3D models for chainmail/1D diag ring blocks/shaft for pulley v0.stl

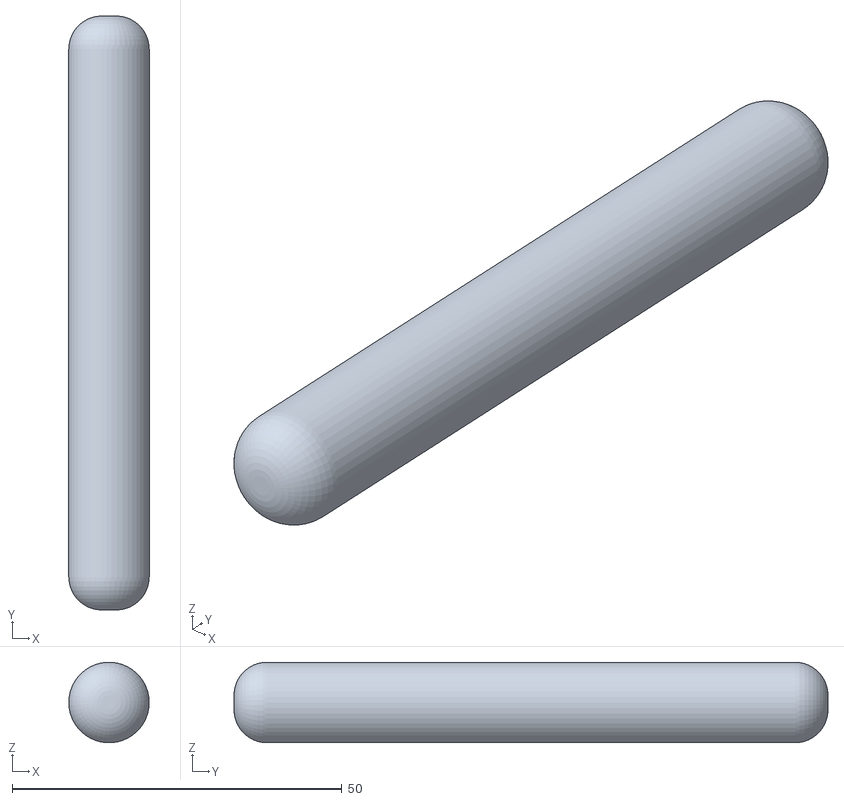
[picture p199: CAD file, 2026-04-09]
3D models for chainmail/1D diag ring blocks/shaft for pulley v0.stl
12.2 x 90.0 x 12.2
