KuroBean/SURF-git/3D models for chainmail/single block design 11_16/string holder pill hole 2 long.3mf

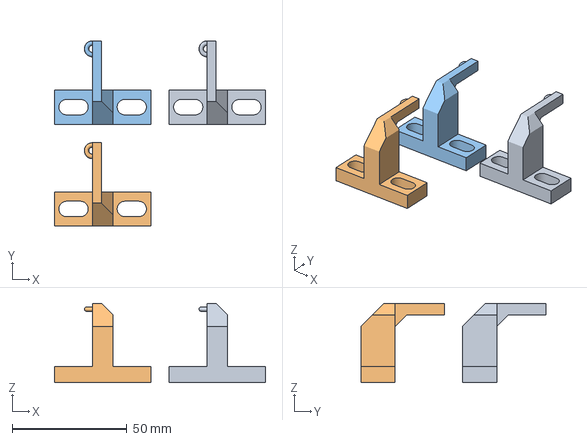
[picture p200: CAD file, 2026-04-09]
3D models for chainmail/single block design 11_16/string holder pill hole 2 long.3mf
92.0 x 80.8 x 34.6 mm
