KuroBean/SURF-git/3D models for chainmail/single block design 11_16/vert ring string holder.3mf

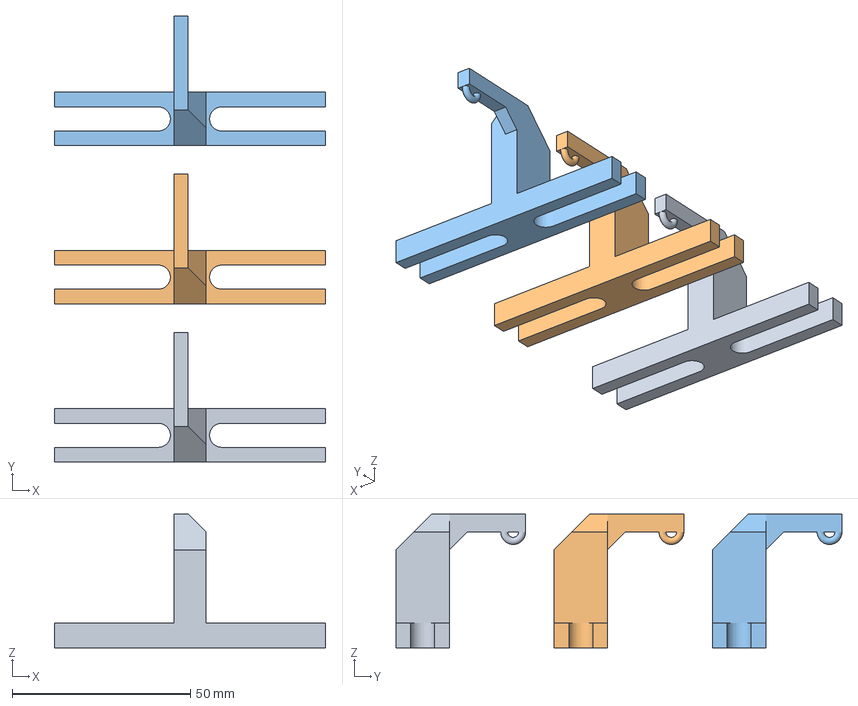
[picture p201: CAD file, 2026-04-09]
3D models for chainmail/single block design 11_16/vert ring string holder.3mf
76.2 x 125.2 x 37.5 mm
