KuroBean/SURF-git/3D models for chainmail/single block design 11_16/horizontal + vertical block 1d sensor thicker top.stl

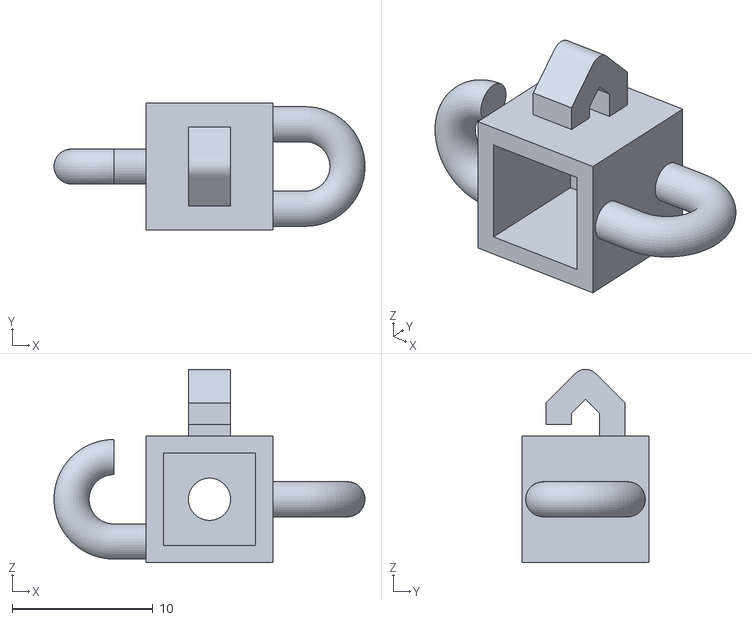
[picture p202: CAD file, 2026-04-09]
3D models for chainmail/single block design 11_16/horizontal + vertical block 1d sensor thicker top.stl
22.1 x 9.00 x 13.7
