KuroBean/SURF-git/3D models for chainmail/single block design 11_16/ramp and string setup v1.3mf

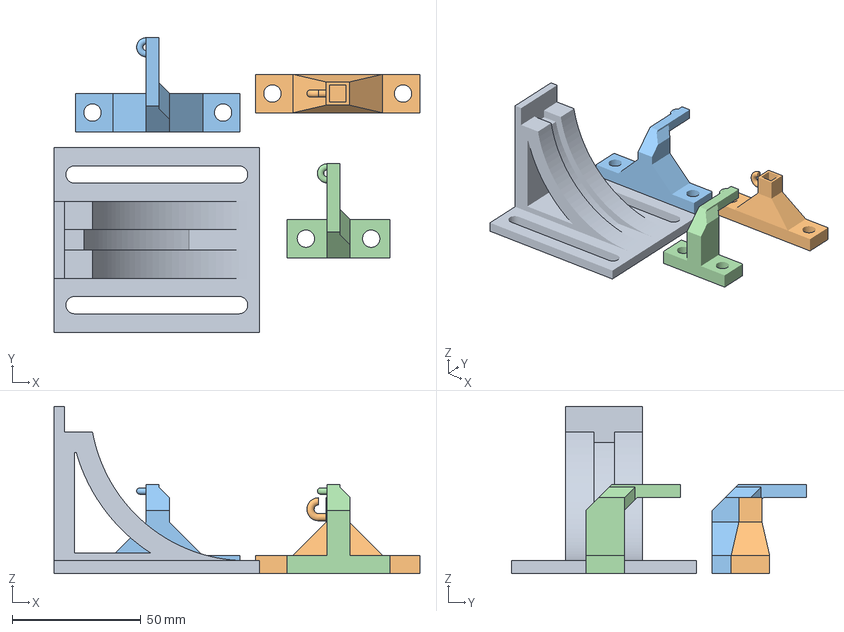
[picture p203: CAD file, 2026-04-09]
3D models for chainmail/single block design 11_16/ramp and string setup v1.3mf
142.4 x 114.7 x 65.0 mm
ramp long.stl
vertical boundary sensor hole.stl
string holder 3 hole long v 11_16.stl
string holder 2 hole long.stl
