KuroBean/SURF-git/3D models for chainmail/single block design 11_16/batch print 2_5 design horizontal + vertical block 1d sensor thicker top.3mf

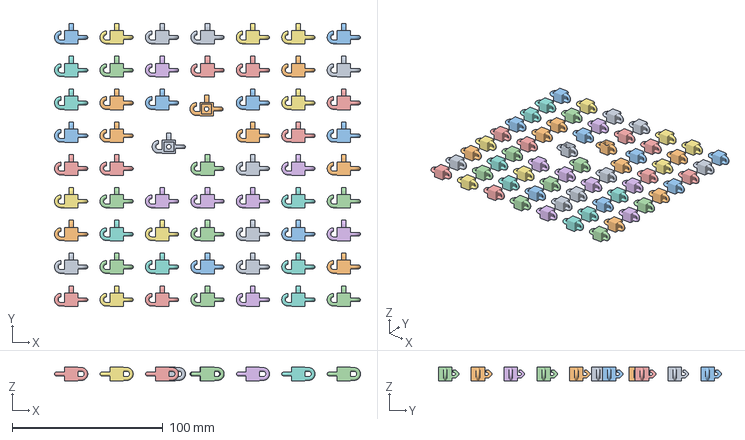
[picture p204: CAD file, 2026-04-09]
3D models for chainmail/single block design 11_16/batch print 2_5 design horizontal + vertical block 1d sensor thicker top.3mf
202.7 x 187.5 x 9.00 mm
horizontal + vertical block 1d sensor thicker top.stl
horizontal + vertical block 1d v9 thicker top hook.stl
