KuroBean/SURF-git/3D models for chainmail/single block design 11_16/string holder 3 hoel long 3 in len.3mf

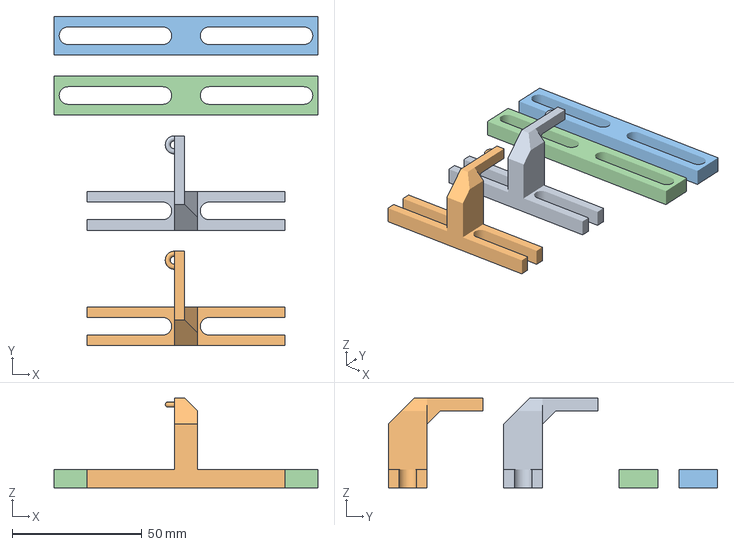
[picture p205: CAD file, 2026-04-09]
3D models for chainmail/single block design 11_16/string holder 3 hoel long 3 in len.3mf
101.6 x 126.8 x 34.6 mm
string holder 3 hoel long 3 in len.stl
screw platform for ramp.stl
