KuroBean/SURF-git/(list of files, cad)

Other CAD files:
3D models for chainmail/7_7 reglue/post reglue actuator holder v2.3mf
3D models for chainmail/ring blocks/7_1 to 21 design/tight fit block cyl accelerometer hole v2 6.65.stl
3D models for chainmail/6_26 bigger r for metla 3d print/horizontal ring block cyl v10.stl
3D models for chainmail/PK4GA7P2-Solidworks.sldprt
3D models for chainmail/ring blocks/7_1 to 21 design/tight fit block cyl accelerometer hole 6.55.stl
3D models for chainmail/6_26 bigger r for metla 3d print/horizontal ring block cyl accelerometer hole v4.stl
3D models for chainmail/boundary blocks/verti boundary block v2.stl
3D models for chainmail/7_1 fixed hori rings and adjusted act/actuator holder v5.stl
3D models for chainmail/7_16 and 17 new spacer boundary blocks/boundary blocks vert both.gcode.3mf
3D models for chainmail/boundary blocks/boundary block v4 0.2mm tol.stl
3D models for chainmail/metal loaded design bigger 3_2/6.65 after the incident metal cube sensor horizontal + vertical block 1d.stl
3D models for chainmail/metal loaded design bigger 3_2/striker with limiter/angle limiter angle ticks v2.stl
3D models for chainmail/sensor with actuator holder/load sensor actuator holder 8_11 more space.stl
3D models for chainmail/7_16 and 17 new spacer boundary blocks/bigger side actuator holder v4.stl
3D models for chainmail/boundary blocks/verti boundary block med tol 0.2mm.stl
3D models for chainmail/ring blocks/7_1 to 21 design/super tight fit block cyl accelerometer 6.55 hole.stl
3D models for chainmail/sensor with actuator holder/load sensor to actuator adapter 8_11 curved.stl
3D models for chainmail/metal loaded design bigger 3_2/striker hammer v3.stl
3D models for chainmail/ring blocks/7_1 to 21 design/horizontal ring block cyl accelerometer hole v4.stl
3D models for chainmail/ring blocks/7_1 to 21 design/super tight fit block cyl accelerometer 6.55 big enuf hole v2.stl
3D models for chainmail/7_1 fixed hori rings and adjusted act/horizontal ring block cyl accelerometer hole v4.stl
3D models for chainmail/boundary blocks/vertical boundary accelerometer hole v2.stl
3D models for chainmail/single block design 11_16/vertical boundary sensor hole.stl
3D models for chainmail/ring blocks/7_1 to 21 design/tight fit block cyl accelerometer hole v1.stl
3D models for chainmail/metal loaded design bigger 3_2/slightly too tight 8.2mm hole metal cube horizontal + vertical block 1d.stl
3D models for chainmail/single block design 11_16/string holder vert ring 3 hole wide.stl
3D models for chainmail/6_26 bigger r for metla 3d print/fit test.blend
3D models for chainmail/7_1 fixed hori rings and adjusted act - Copy/actuator holder v3.stl
3D models for chainmail/7_1 fixed hori rings and adjusted act - Copy/actuator holder v4.stl
3D models for chainmail/7_1 fixed hori rings and adjusted act - Copy/actuator holder v5.stl
3D models for chainmail/7_1 fixed hori rings and adjusted act - Copy/horizontal ring block cyl accelerometer hole v4.stl
3D models for chainmail/7_1 fixed hori rings and adjusted act/actuator holder v3.stl
3D models for chainmail/7_1 fixed hori rings and adjusted act/actuator holder v4.stl
3D models for chainmail/7_11 actuator parts/actuator screw spacer v1.stl
3D models for chainmail/7_16 and 17 new spacer boundary blocks/actuator screw spacer v1.f3d
3D models for chainmail/7_16 and 17 new spacer boundary blocks/vertical boundary 3 screw v2.stl
3D models for chainmail/7_7 reglue/post reglue actuator holder v2.stl
3D models for chainmail/ball striker design/tension sensor ring block interface.stl
3D models for chainmail/metal loaded design bigger 3_2/striker with limiter/angle limiter v3 min 45 deg smol and incremented.stl
3D models for chainmail/single block design 11_16/horizontal + vertical block 1d sensor hole 6.55.stl
3D models for chainmail/single block design 11_16/screw platform for ramp.stl
3D models for chainmail/single block design 11_16/string holder 3 hoel long 3 in len.stl
3D models for chainmail/single block design 11_16/string holder 3 hoel long.stl
3D models for chainmail/single block design 11_16/string holder pill hole 2 long.stl
