KuroBean/SURF-git/data analysis/surf 2025 exp/1D amplitude changing exp/250922_compression_manual/68 peaks.png

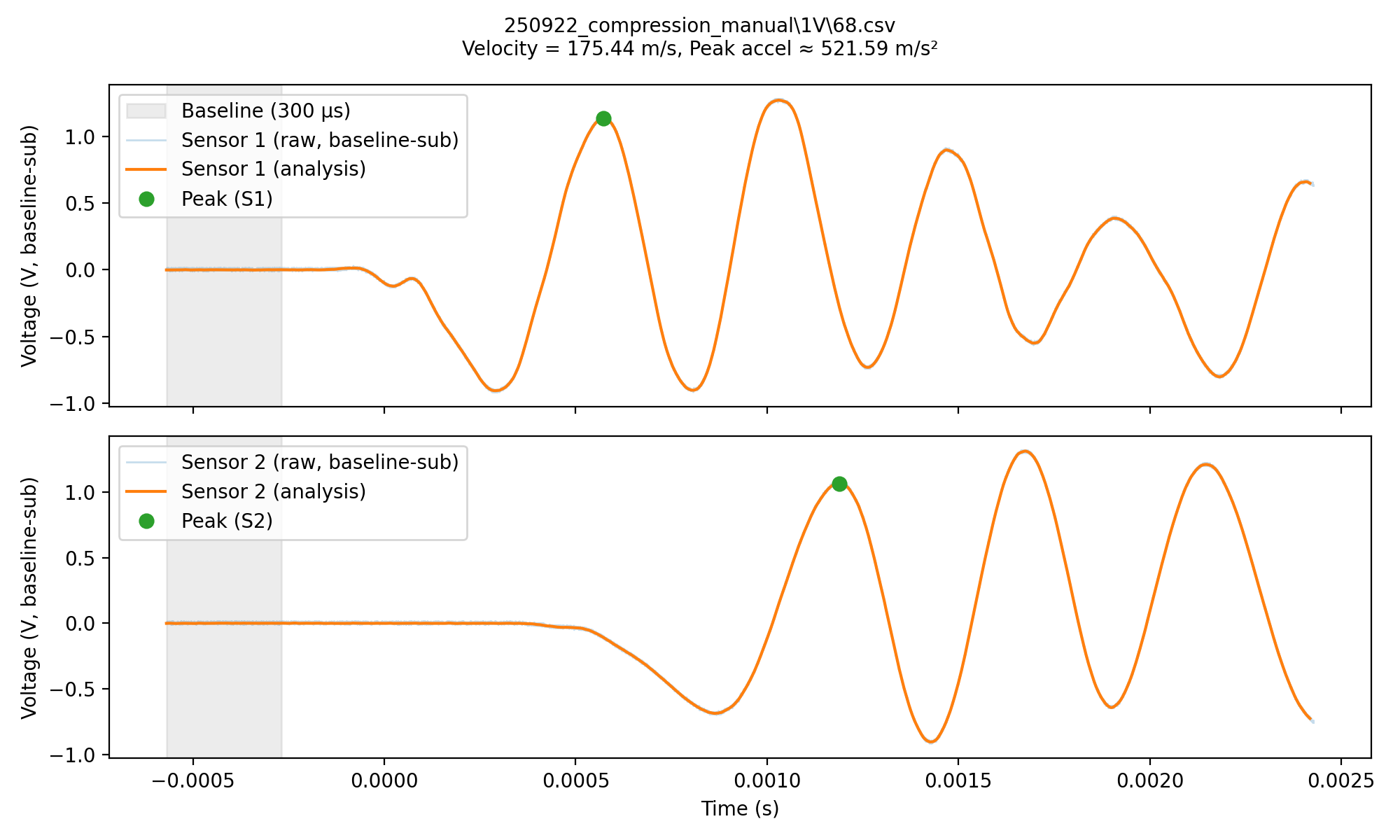
data analysis/surf 2025 exp/1D amplitude changing exp/250922_compression_manual/68 peaks.png
