KuroBean/SURF-git/data analysis/soliton experiments/soliton exp 6_20 farther sensors/soliton_details.csv

angle_deg | angle_folder | mass_g | pretension_N | file | file_path | velocity_mps | peak_accel_mps2 | fwhm_s1_s | fwhm_s2_s | dt_s
90.0 | 90 deg | 200.0 | 1.9620000000000002 | 200g_20260620-161550.h5 | soliton experiments\soliton exp 6_20 farther sensors\90 deg\200g_20260620-161550.h5 | 92.30251140453913 | 866.4117838928208 | 0.0005748506283375537 | 0.0006091848450210436 | 2e-07
90.0 | 90 deg | 200.0 | 1.9620000000000002 | 200g_20260620-161555.h5 | soliton experiments\soliton exp 6_20 farther sensors\90 deg\200g_20260620-161555.h5 | 92.39361773215201 | 869.5463359677381 | 0.000570286662931907 | 0.0006098141133630197 | 2e-07
90.0 | 90 deg | 200.0 | 1.9620000000000002 | 200g_20260620-161558.h5 | soliton experiments\soliton exp 6_20 farther sensors\90 deg\200g_20260620-161558.h5 | 92.56157813102405 | 937.3495979647788 | 0.0005531996369546166 | 0.0005941956561519258 | 2e-07
90.0 | 90 deg | 200.0 | 1.9620000000000002 | 200g_20260620-161601.h5 | soliton experiments\soliton exp 6_20 farther sensors\90 deg\200g_20260620-161601.h5 | 92.50318713687301 | 880.0369763556631 | 0.0005669216048466537 | 0.0006046999716779718 | 2e-07
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
