KuroBean/SURF-git/data analysis/soliton experiments/5_1 data/soliton_details.csv

angle_deg | angle_folder | mass_g | pretension_N | file | file_path | velocity_mps | peak_accel_mps2 | dt_s
45.0 | 45 deg soliton data | 100.0 | 0.9810000000000001 | 100g_20260429-173430.h5 | 45 deg soliton data\100g_20260429-173430.h5 | 89.23443300413253 | 490.7508609614758 | 2e-07
45.0 | 45 deg soliton data | 100.0 | 0.9810000000000001 | 100g_20260429-173433.h5 | 45 deg soliton data\100g_20260429-173433.h5 | 85.72774375883183 | 543.6689244028112 | 2e-07
45.0 | 45 deg soliton data | 100.0 | 0.9810000000000001 | 100g_20260429-173436.h5 | 45 deg soliton data\100g_20260429-173436.h5 | 85.0297003270373 | 539.8119854908591 | 2e-07
45.0 | 45 deg soliton data | 100.0 | 0.9810000000000001 | 100g_20260429-173440.h5 | 45 deg soliton data\100g_20260429-173440.h5 | 85.09217205450173 | 531.9982113812134 | 2e-07
45.0 | 45 deg soliton data | 100.0 | 0.9810000000000001 | 100g_20260429-173443.h5 | 45 deg soliton data\100g_20260429-173443.h5 | 85.54354394682065 | 553.7013348802693 | 2e-07
45.0 | 45 deg soliton data | 100.0 | 0.9810000000000001 | 100g_20260429-173446.h5 | 45 deg soliton data\100g_20260429-173446.h5 | 85.14904424542173 | 563.9425960453303 | 2e-07
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
