KuroBean/SURF-git/data analysis/soliton experiments/5_1 data/soliton_summary.csv

angle_deg | pretension_N | mass_g | n | mean_velocity | std_velocity | mean_peak_accel | std_peak_accel | sem_velocity | sem_peak_accel
45.0 | 0.5886 | 60.0 | 6 | 85.76995619264949 | 1.1392126452031477 | 526.2924927047827 | 35.60286243518325 | 0.4650816148790004 | 14.534807724783649
45.0 | 0.7848 | 80.0 | 5 | 85.16654939355689 | 0.7259425459072629 | 485.86046276537616 | 47.79683498771785 | 0.3246513760815803 | 21.375394428375486
45.0 | 0.9810000000000001 | 100.0 | 6 | 85.96277288945764 | 1.6263748664581503 | 537.3123188603265 | 25.37965869078873 | 0.6639647588849334 | 10.361202273070823
45.0 | 1.1772 | 120.0 | 6 | 84.9800018197874 | 0.37033959840226904 | 499.2024116891211 | 31.653175091407675 | 0.15119050793879993 | 12.922354618820515
45.0 | 1.9620000000000002 | 200.0 | 6 | 89.27985180964266 | 0.970350981556222 | 433.6812652569841 | 36.85912207611108 | 0.39614412937025917 | 15.047673575571181
90.0 | 0.5886 | 60.0 | 10 | 90.55575367181015 | 1.5678208765455428 | 1179.5214708909082 | 87.70334296951701 | 0.49578849330455765 | 27.73423221945891
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
