KuroBean/SURF-git/data analysis/soliton experiments/soliton exp 5_13/soliton_details.csv

angle_deg | angle_folder | mass_g | pretension_N | file | file_path | velocity_mps | peak_accel_mps2 | dt_s
45.0 | 45 deg soliton data | 140.0 | 1.3734000000000002 | 140g_20260519-211722.h5 | soliton experiments\soliton exp 5_13\45 deg soliton data\140g_20260519-211722.h5 | 83.94833948339482 | 330.056055399941 | 2e-07
45.0 | 45 deg soliton data | 140.0 | 1.3734000000000002 | 140g_20260519-211732.h5 | soliton experiments\soliton exp 5_13\45 deg soliton data\140g_20260519-211732.h5 | 81.90292510446801 | 260.03845277649685 | 2e-07
45.0 | 45 deg soliton data | 140.0 | 1.3734000000000002 | 140g_20260519-211737.h5 | soliton experiments\soliton exp 5_13\45 deg soliton data\140g_20260519-211737.h5 | 83.8157894736842 | 318.3976886814729 | 2e-07
45.0 | 45 deg soliton data | 140.0 | 1.3734000000000002 | 140g_20260519-211742.h5 | soliton experiments\soliton exp 5_13\45 deg soliton data\140g_20260519-211742.h5 | 82.25192071792884 | 226.98654668970266 | 2e-07
45.0 | 45 deg soliton data | 140.0 | 1.3734000000000002 | 140g_20260519-211745.h5 | soliton experiments\soliton exp 5_13\45 deg soliton data\140g_20260519-211745.h5 | 82.87795992714025 | 279.2500457494829 | 2e-07
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
