KuroBean/SURF-git/data analysis/soliton experiments/soliton exp 5_13/soliton_summary.csv

angle_deg | pretension_N | mass_g | n | mean_velocity | std_velocity | mean_peak_accel | std_peak_accel | sem_velocity | sem_peak_accel
45.0 | 0.7848 | 80.0 | 10 | 84.32649564094226 | 0.48914560050390055 | 417.96947535875444 | 38.715443629775045 | 0.15468142050431313 | 12.242898249394582
45.0 | 1.3734000000000002 | 140.0 | 12 | 83.36804422829958 | 0.7416561327813433 | 293.9604689226374 | 34.970352661145796 | 0.21409768395372272 | 10.095071261284335
45.0 | 1.9620000000000002 | 200.0 | 11 | 84.76533806692804 | 2.3738098056291443 | 303.9178999268724 | 17.506219028358014 | 0.715730586267123 | 5.278323637713056
60.0 | 0.7848 | 80.0 | 11 | 86.32653092228776 | 0.8383317007854771 | 665.8642104352022 | 52.34589072635287 | 0.2527665183059926 | 15.782879896023342
60.0 | 1.3734000000000002 | 140.0 | 12 | 87.65491885934274 | 2.8481638811665215 | 506.5024476987589 | 52.72907171844544 | 0.8221940917438303 | 15.22157187538178
60.0 | 1.9620000000000002 | 200.0 | 11 | 87.76764348875882 | 2.7293758245610142 | 514.4508845030372 | 75.42372749290021 | 0.8229377747214337 | 22.74110948945118
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
