KuroBean/SURF-git/data analysis/soliton experiments/4_1 hammer/scope_8.png

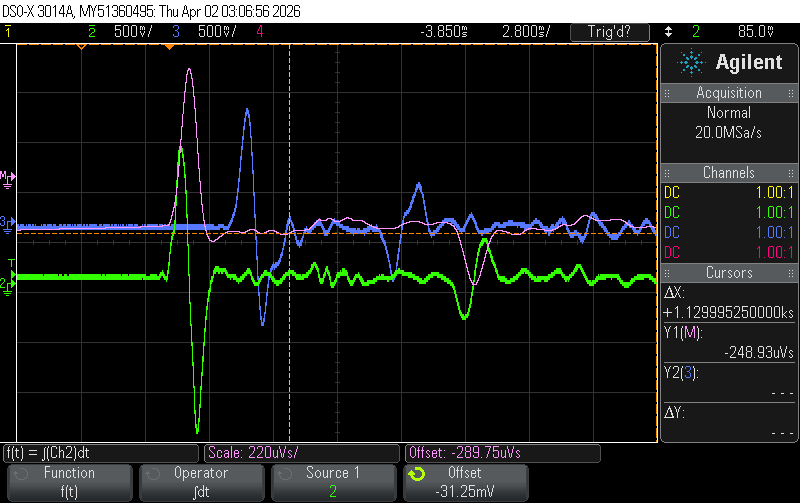
data analysis/soliton experiments/4_1 hammer/scope_8.png
