KuroBean/SURF-git/data analysis/soliton experiments/5_1 data/45 deg soliton data/60g_20260429-172925.png

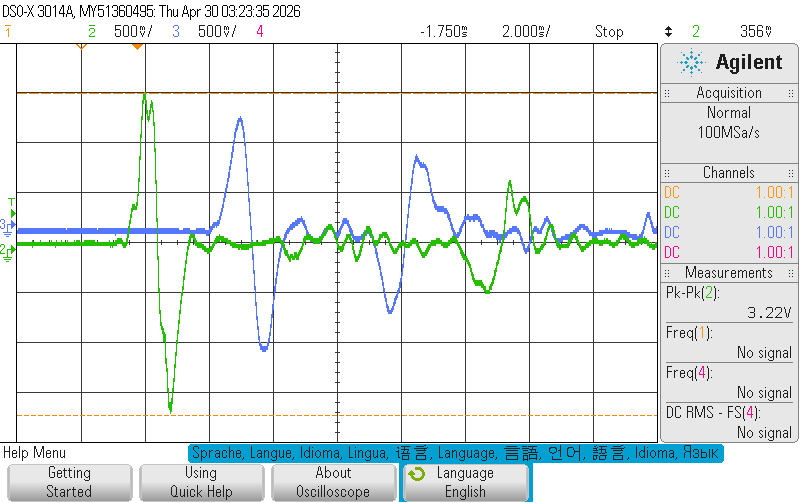
data analysis/soliton experiments/5_1 data/45 deg soliton data/60g_20260429-172925.png
