KuroBean/SURF-git/data analysis/soliton experiments/5_1 data/45 deg soliton data/80g_20260429-173202.png

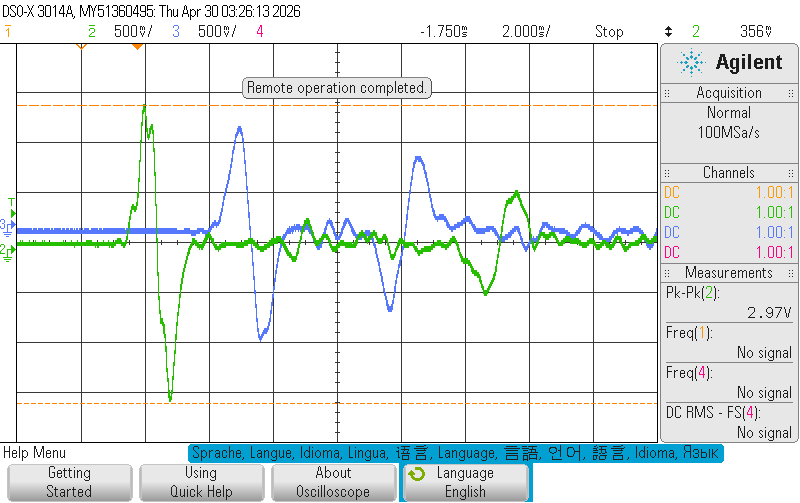
data analysis/soliton experiments/5_1 data/45 deg soliton data/80g_20260429-173202.png
