KuroBean/SURF-git/data analysis/soliton experiments/5_1 data/45 deg soliton data/200g_20260429-173748.png

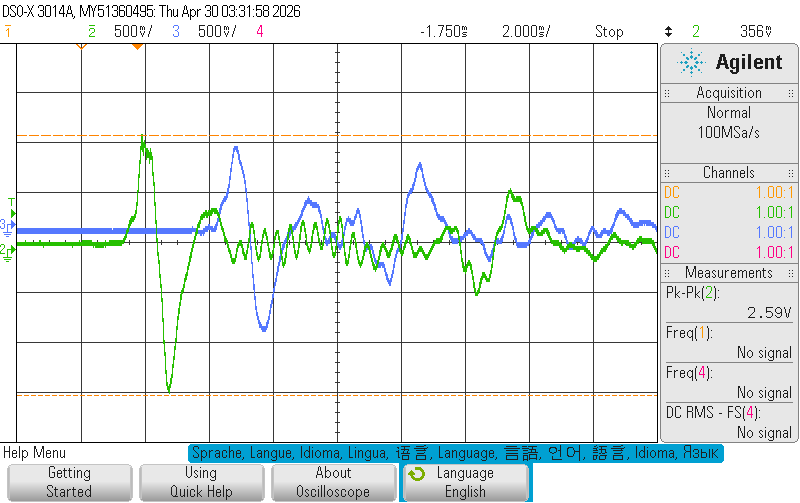
data analysis/soliton experiments/5_1 data/45 deg soliton data/200g_20260429-173748.png
