KuroBean/SURF-git/data analysis/soliton experiments/5_1 data/90 deg soliton data/60g_20260429-174031.png

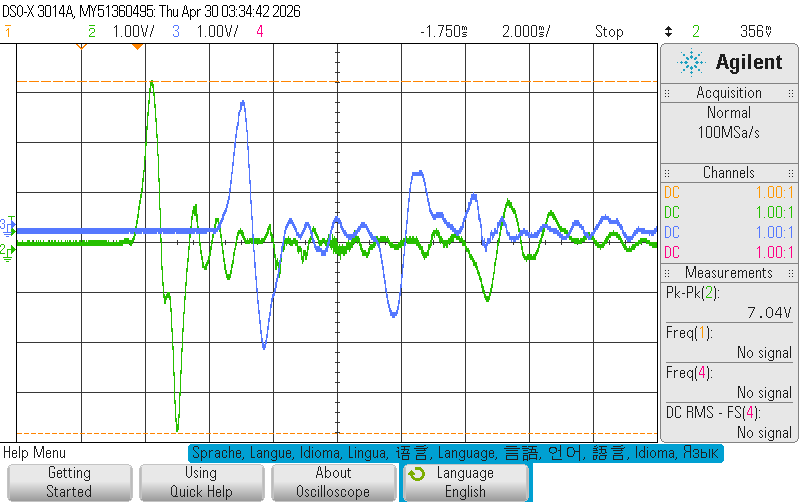
data analysis/soliton experiments/5_1 data/90 deg soliton data/60g_20260429-174031.png
