KuroBean/SURF-git/data analysis/soliton experiments/5_1 data/90 deg soliton data/80g_20260429-174322.png

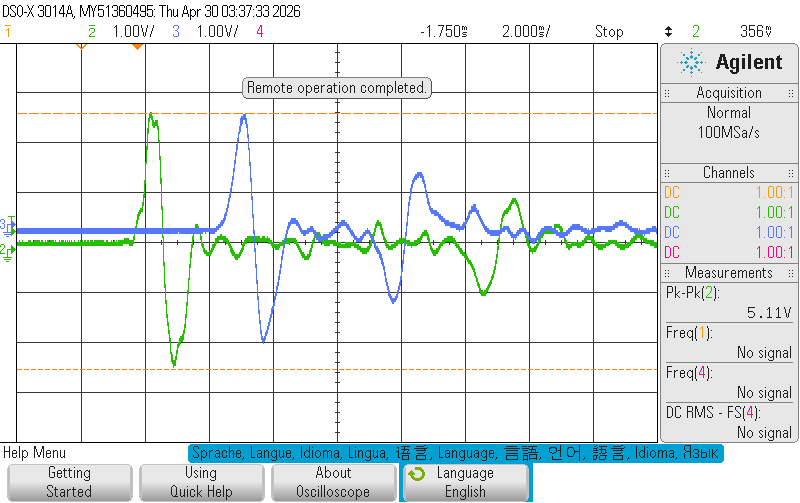
data analysis/soliton experiments/5_1 data/90 deg soliton data/80g_20260429-174322.png
