KuroBean/SURF-git/data analysis/soliton experiments/5_1 data/135 deg soliton data/80g_20260429-175955.png

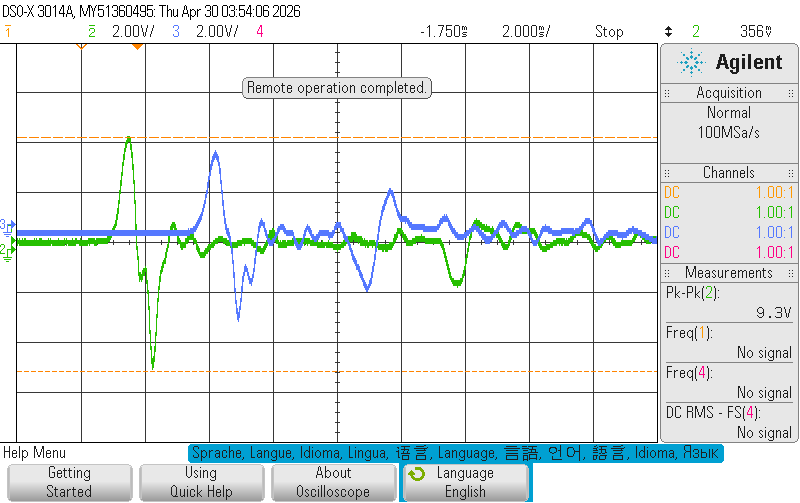
data analysis/soliton experiments/5_1 data/135 deg soliton data/80g_20260429-175955.png
