KuroBean/SURF-git/data analysis/soliton experiments/compression-applied data/40g_90deg_20260422-184052.png

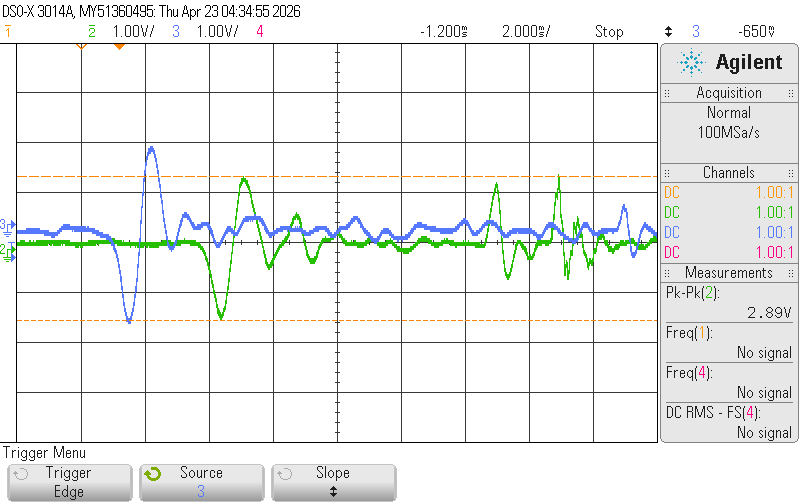
data analysis/soliton experiments/compression-applied data/40g_90deg_20260422-184052.png
