KuroBean/SURF-git/data analysis/soliton experiments/compression-applied data/40g_90deg_adjusted_20260422-184305.png

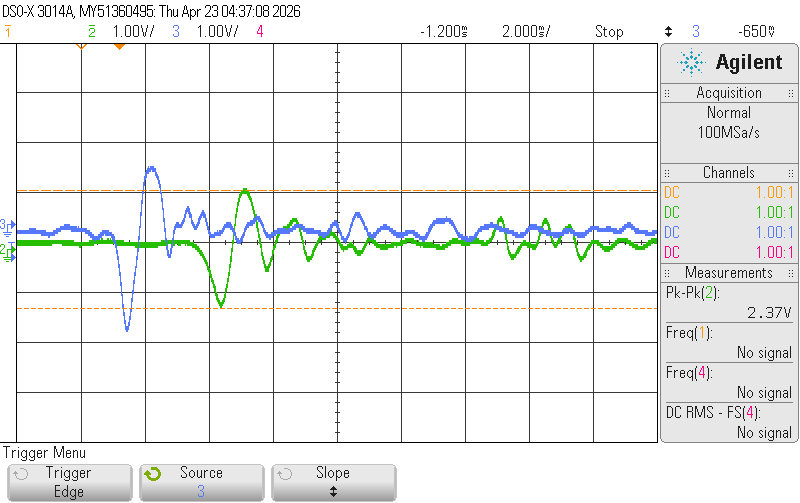
data analysis/soliton experiments/compression-applied data/40g_90deg_adjusted_20260422-184305.png
