KuroBean/SURF-git/data analysis/soliton experiments/compression-applied data/40g_90deg_after 1 strike 0.17 on t sensor_20260422-184219.png

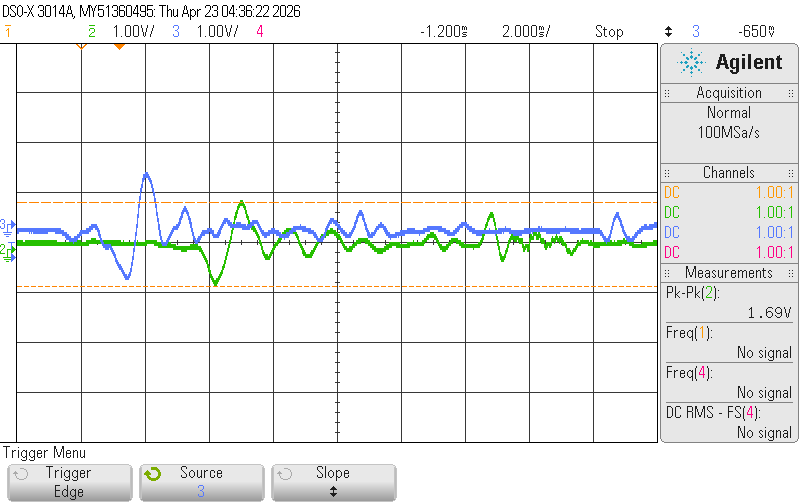
data analysis/soliton experiments/compression-applied data/40g_90deg_after 1 strike 0.17 on t sensor_20260422-184219.png
