KuroBean/SURF-git/data analysis/soliton experiments/compression-applied data/T200g_rly_180_deg_20260422-184629 (SNAPPED).png

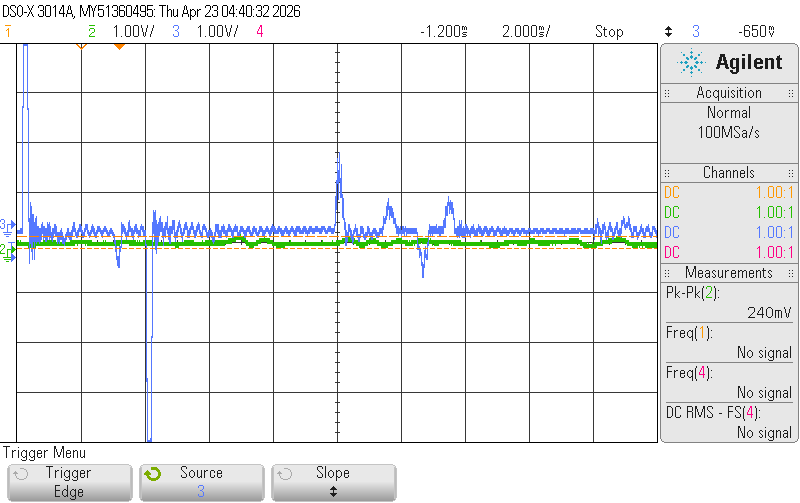
data analysis/soliton experiments/compression-applied data/T200g_rly_180_deg_20260422-184629 (SNAPPED).png
