KuroBean/SURF-git/data analysis/soliton experiments/soliton exp 5_13/45 deg soliton data/80g_20260513-180350.png

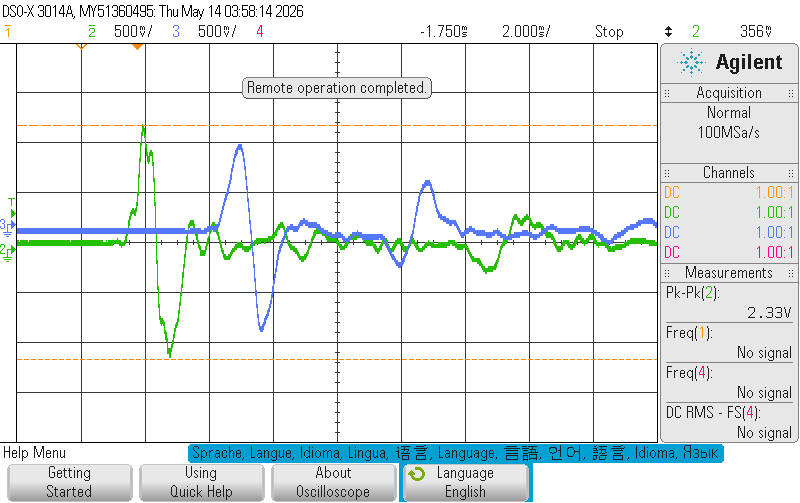
data analysis/soliton experiments/soliton exp 5_13/45 deg soliton data/80g_20260513-180350.png
