KuroBean/SURF-git/data analysis/soliton experiments/soliton exp 5_13/45 deg soliton data/140g_20260519-211811_analysis.png

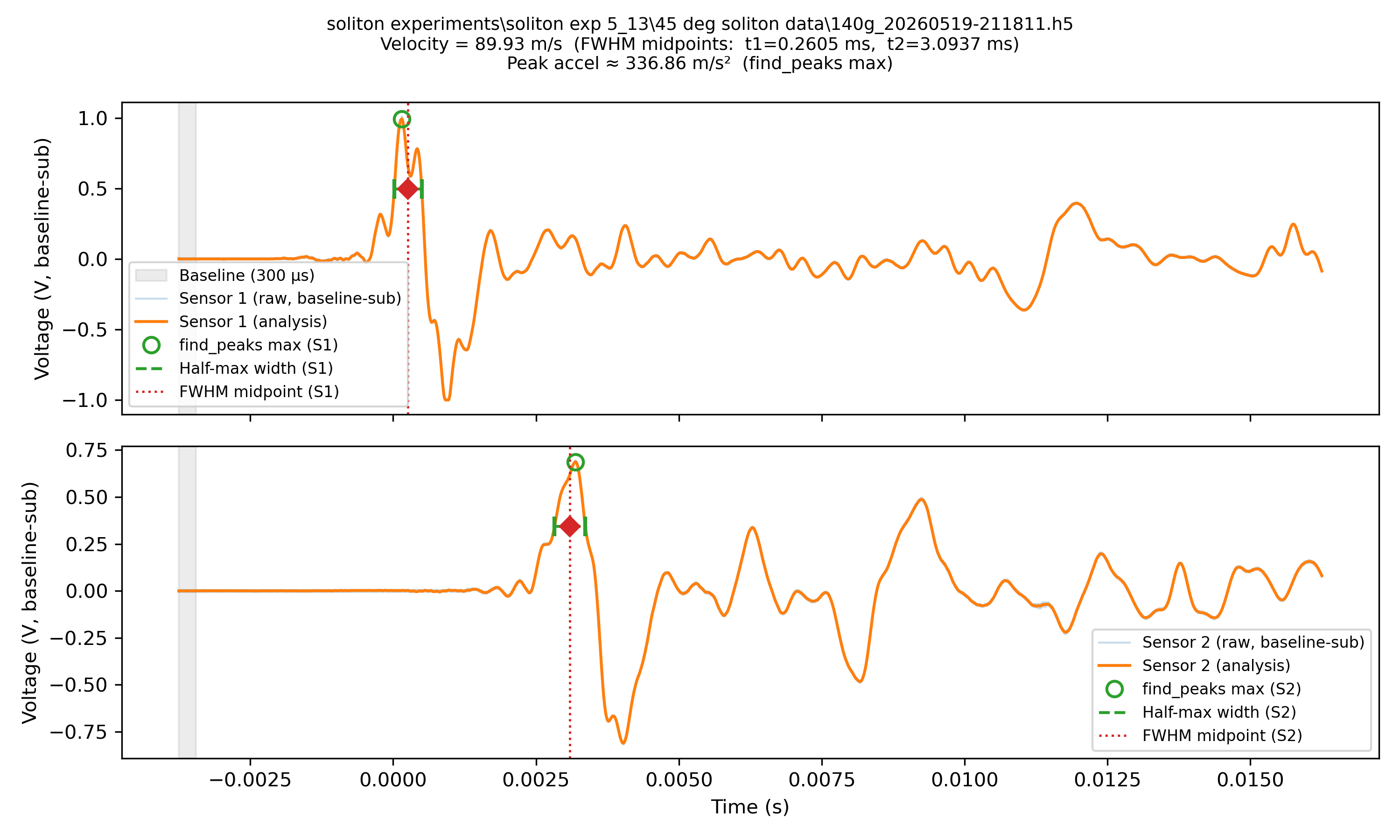
data analysis/soliton experiments/soliton exp 5_13/45 deg soliton data/140g_20260519-211811_analysis.png
