KuroBean/SURF-git/data analysis/soliton experiments/soliton exp 5_13/45 deg soliton data/200g_20260519-212051_analysis.png

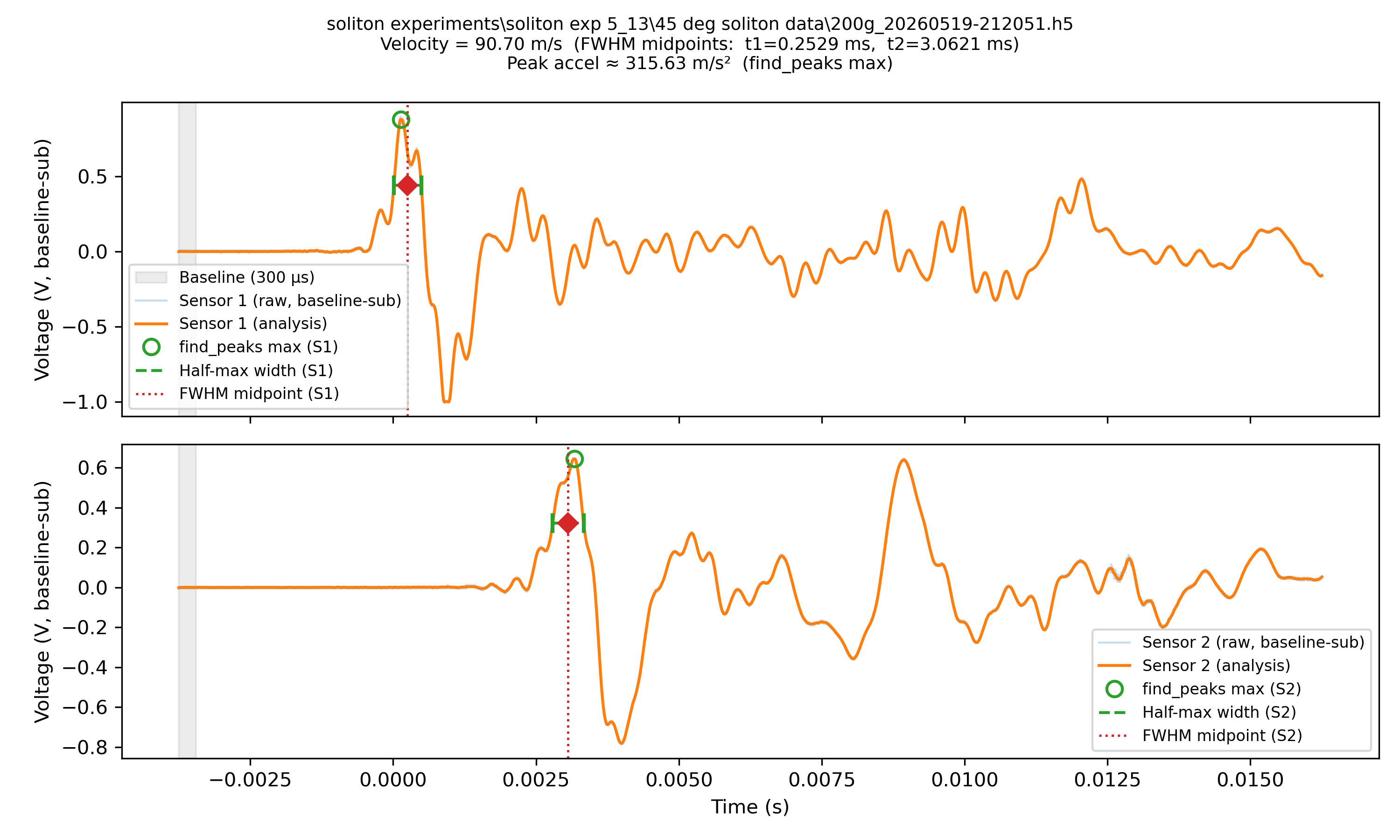
data analysis/soliton experiments/soliton exp 5_13/45 deg soliton data/200g_20260519-212051_analysis.png
