KuroBean/SURF-git/data analysis/soliton experiments/soliton exp 5_13/60 deg soliton data/80g_20260513-180857_analysis.png

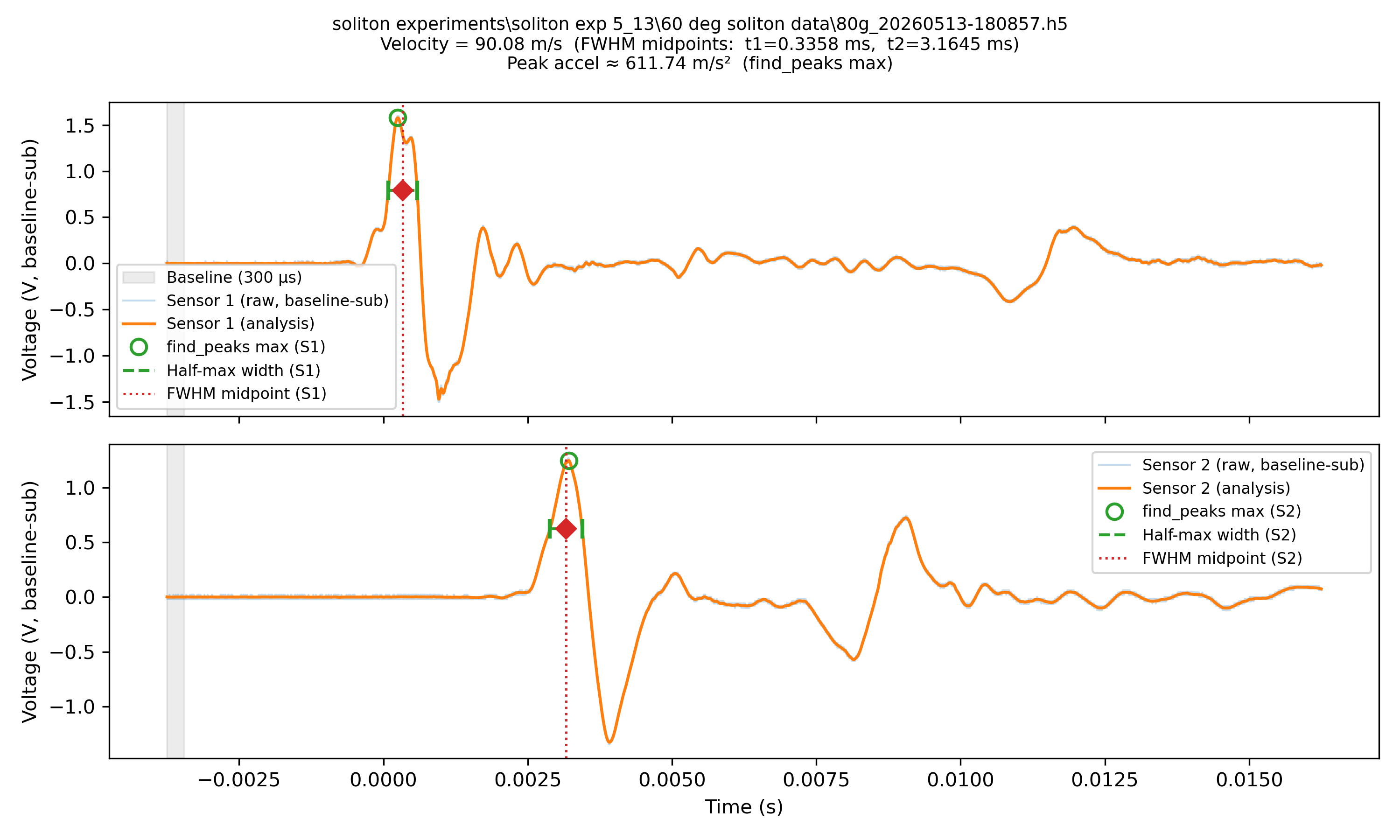
data analysis/soliton experiments/soliton exp 5_13/60 deg soliton data/80g_20260513-180857_analysis.png
