KuroBean/SURF-git/data analysis/soliton experiments/soliton exp 5_13/60 deg soliton data/140g_20260519-211544_analysis.png

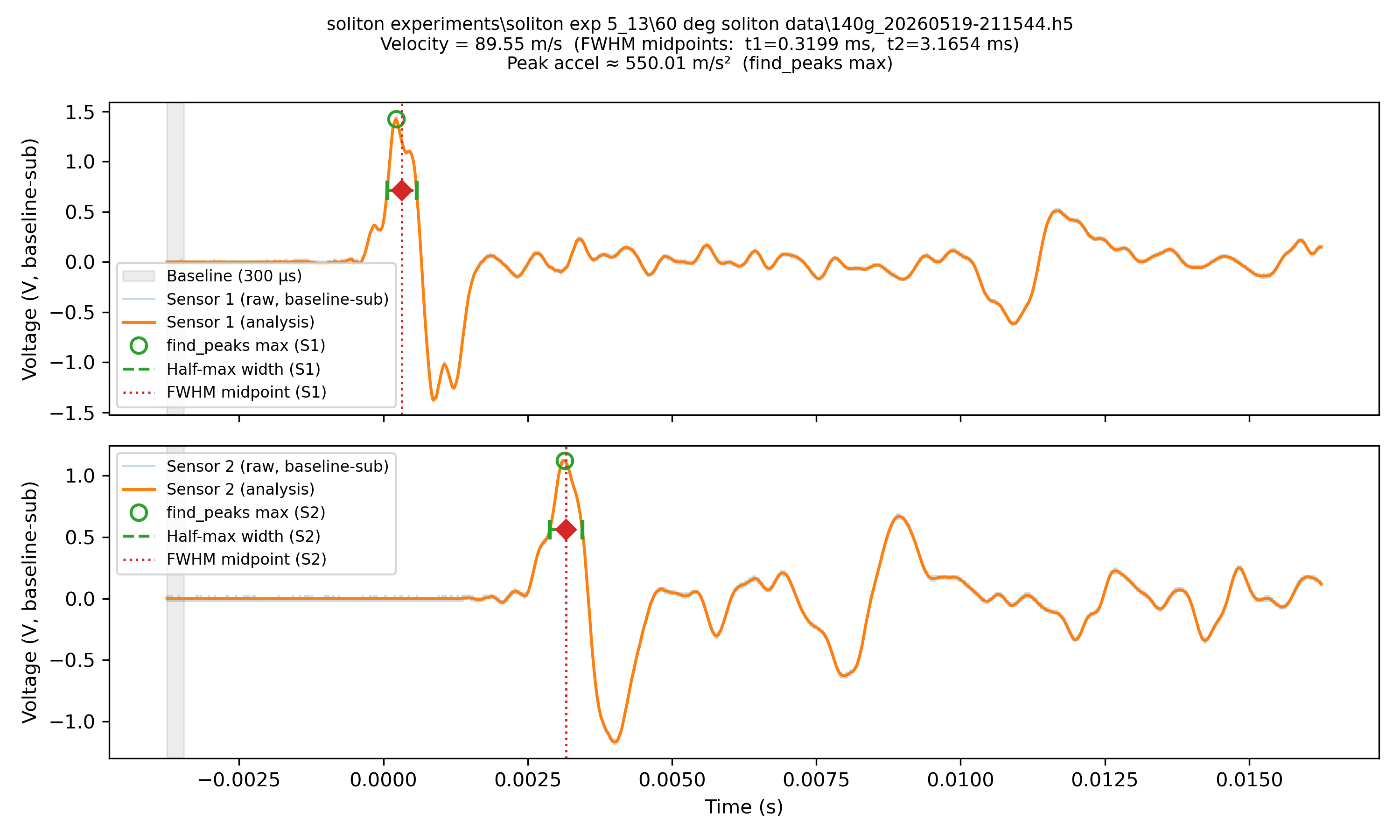
data analysis/soliton experiments/soliton exp 5_13/60 deg soliton data/140g_20260519-211544_analysis.png
