KuroBean/SURF-git/data analysis/soliton experiments/soliton exp 5_13/60 deg soliton data/200g_20260519-212252_analysis.png

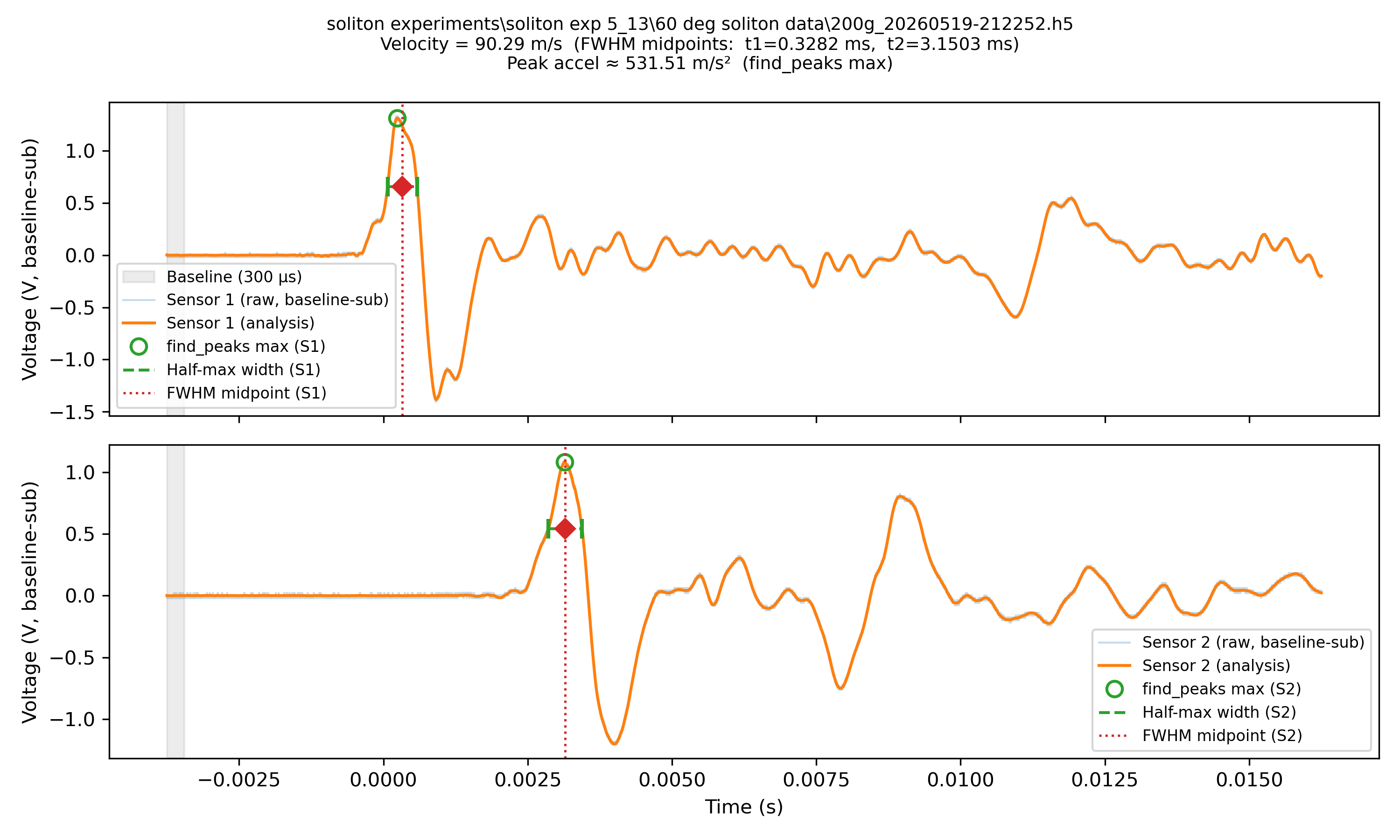
data analysis/soliton experiments/soliton exp 5_13/60 deg soliton data/200g_20260519-212252_analysis.png
