KuroBean/SURF-git/data analysis/soliton experiments/soliton exp 5_13/60 deg soliton data/200g_20260519-212305.png

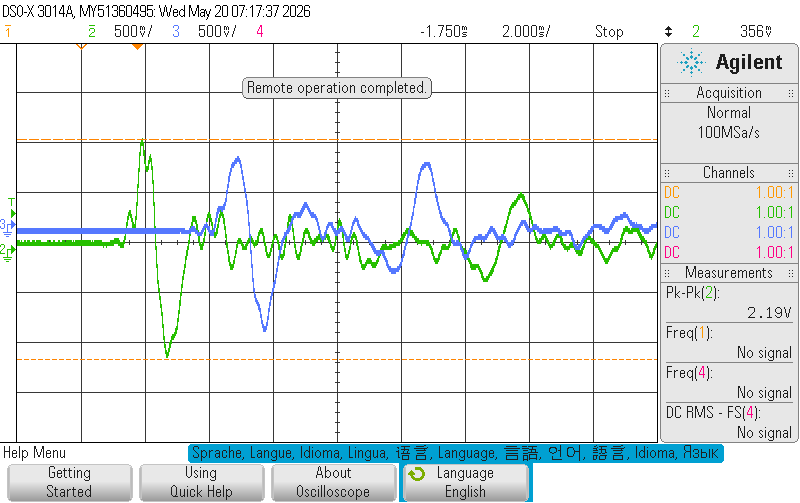
data analysis/soliton experiments/soliton exp 5_13/60 deg soliton data/200g_20260519-212305.png
