KuroBean/SURF-git/data analysis/soliton experiments/soliton exp 5_13/90 deg soliton data/80g_20260513-181034.png

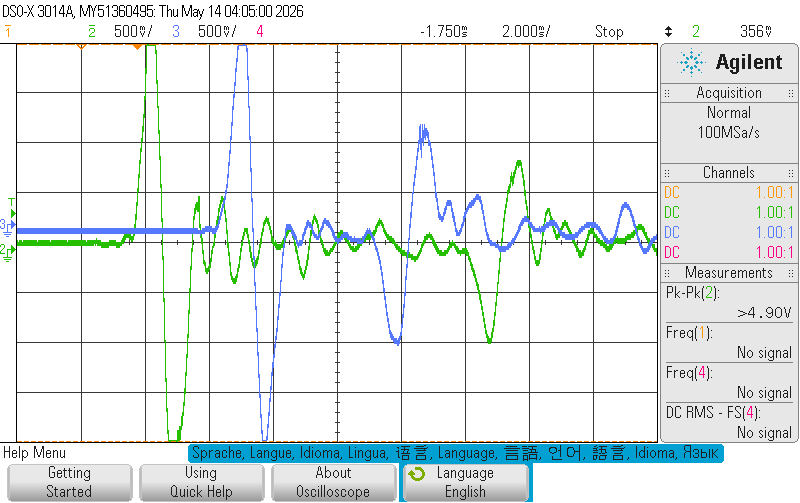
data analysis/soliton experiments/soliton exp 5_13/90 deg soliton data/80g_20260513-181034.png
