KuroBean/SURF-git/data analysis/soliton experiments/soliton exp 5_13/90 deg soliton data/200g_20260519-212418_analysis.png

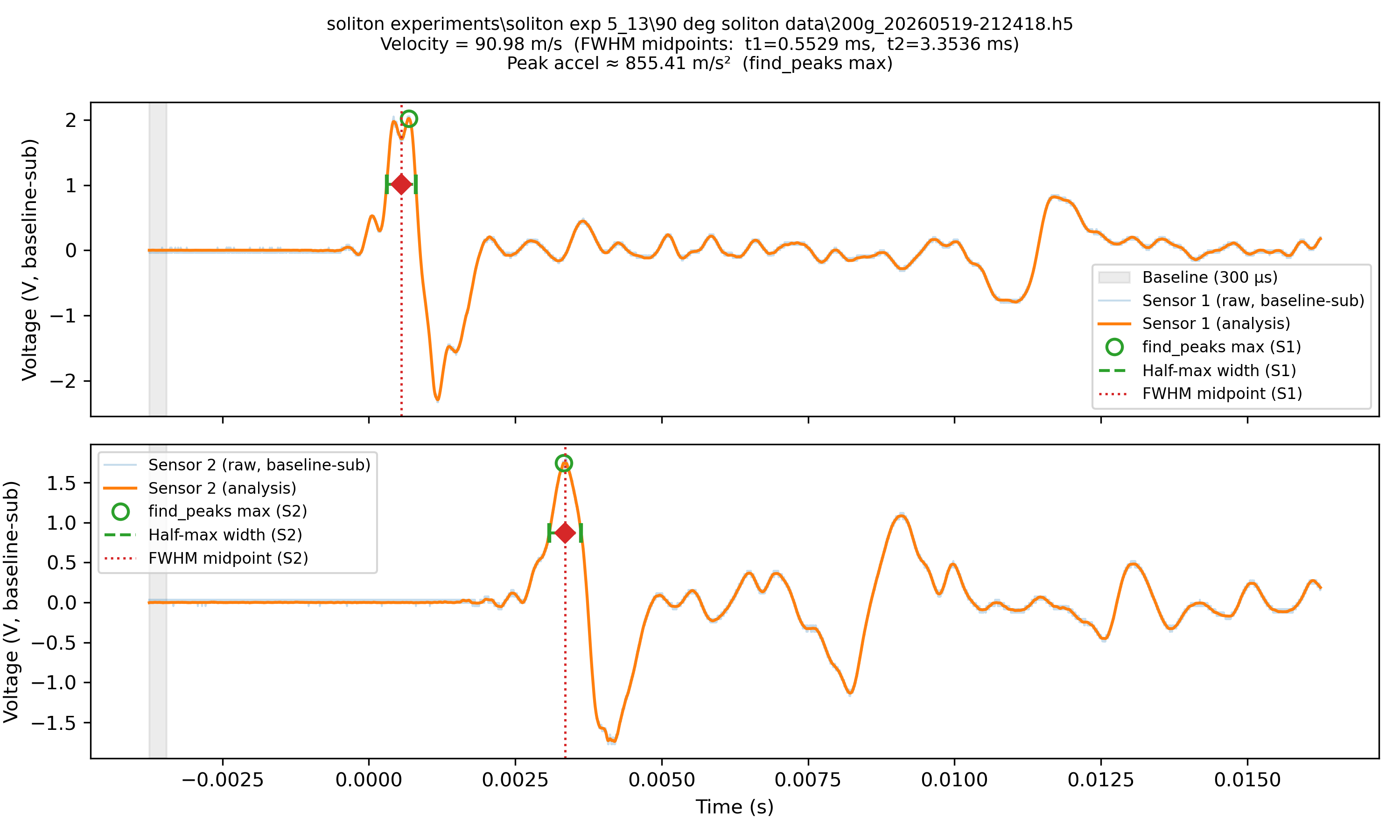
data analysis/soliton experiments/soliton exp 5_13/90 deg soliton data/200g_20260519-212418_analysis.png
