KuroBean/SURF-git/data analysis/soliton experiments/soliton exp 5_13/105 deg soliton data/80g_20260513-181747.png

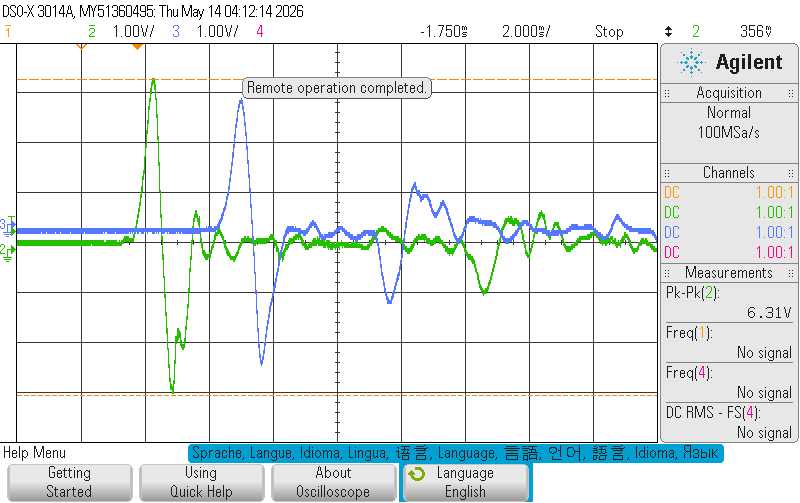
data analysis/soliton experiments/soliton exp 5_13/105 deg soliton data/80g_20260513-181747.png
