KuroBean/SURF-git/data analysis/soliton experiments/soliton exp 5_13/105 deg soliton data/140g_20260519-211216_analysis.png

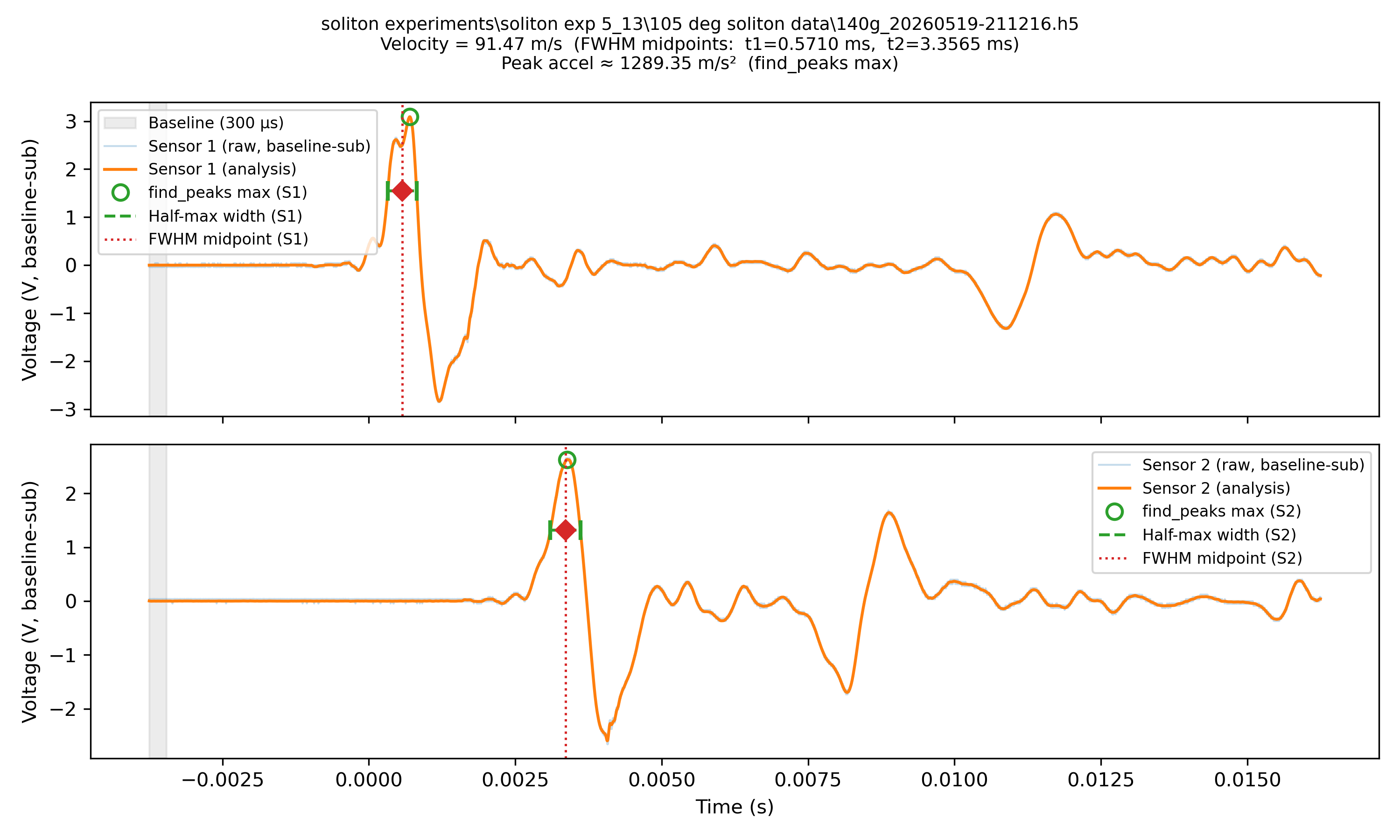
data analysis/soliton experiments/soliton exp 5_13/105 deg soliton data/140g_20260519-211216_analysis.png
