KuroBean/SURF-git/data analysis/soliton experiments/soliton exp 5_13/120 deg soliton data/80g_20260513-181308.png

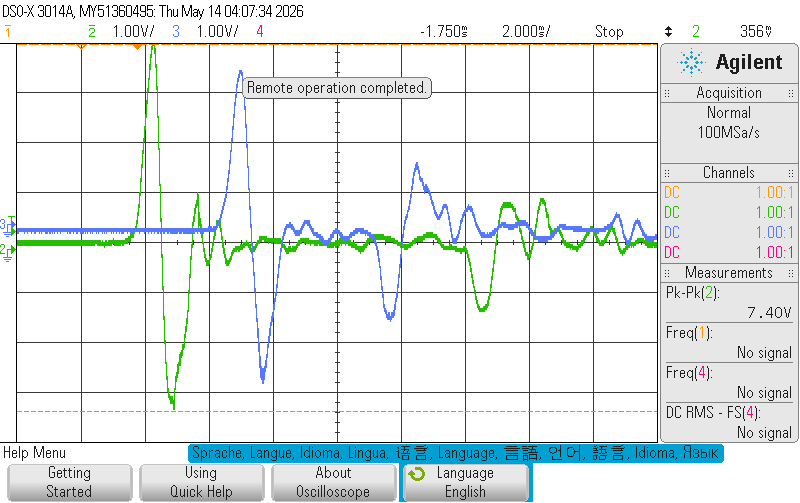
data analysis/soliton experiments/soliton exp 5_13/120 deg soliton data/80g_20260513-181308.png
