KuroBean/SURF-git/data analysis/soliton experiments/soliton exp 5_13/120 deg soliton data/200g_20260519-212900.png

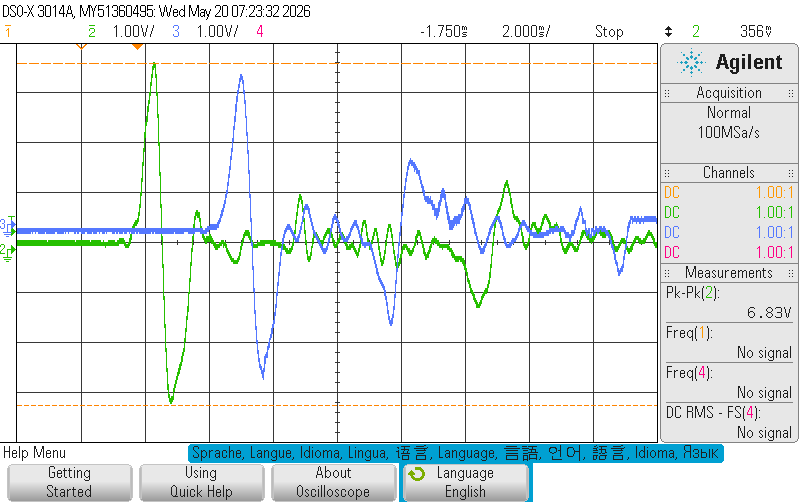
data analysis/soliton experiments/soliton exp 5_13/120 deg soliton data/200g_20260519-212900.png
