KuroBean/SURF-git/data analysis/soliton experiments/soliton exp 5_13/135 deg soliton data/80g_20260513-181630_analysis.png

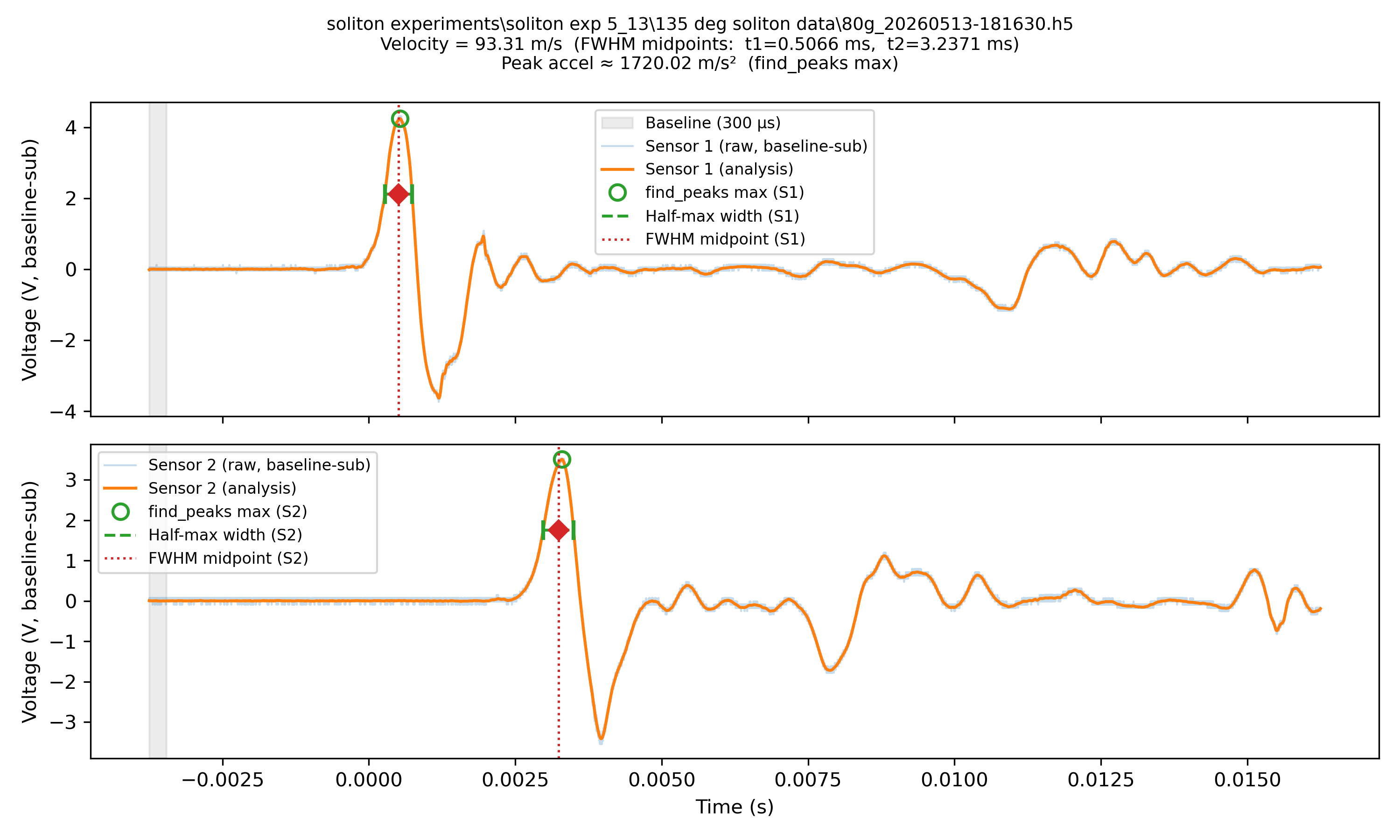
data analysis/soliton experiments/soliton exp 5_13/135 deg soliton data/80g_20260513-181630_analysis.png
