KuroBean/SURF-git/data analysis/soliton experiments/soliton exp 5_13/135 deg soliton data/140g_20260519-210600_analysis.png

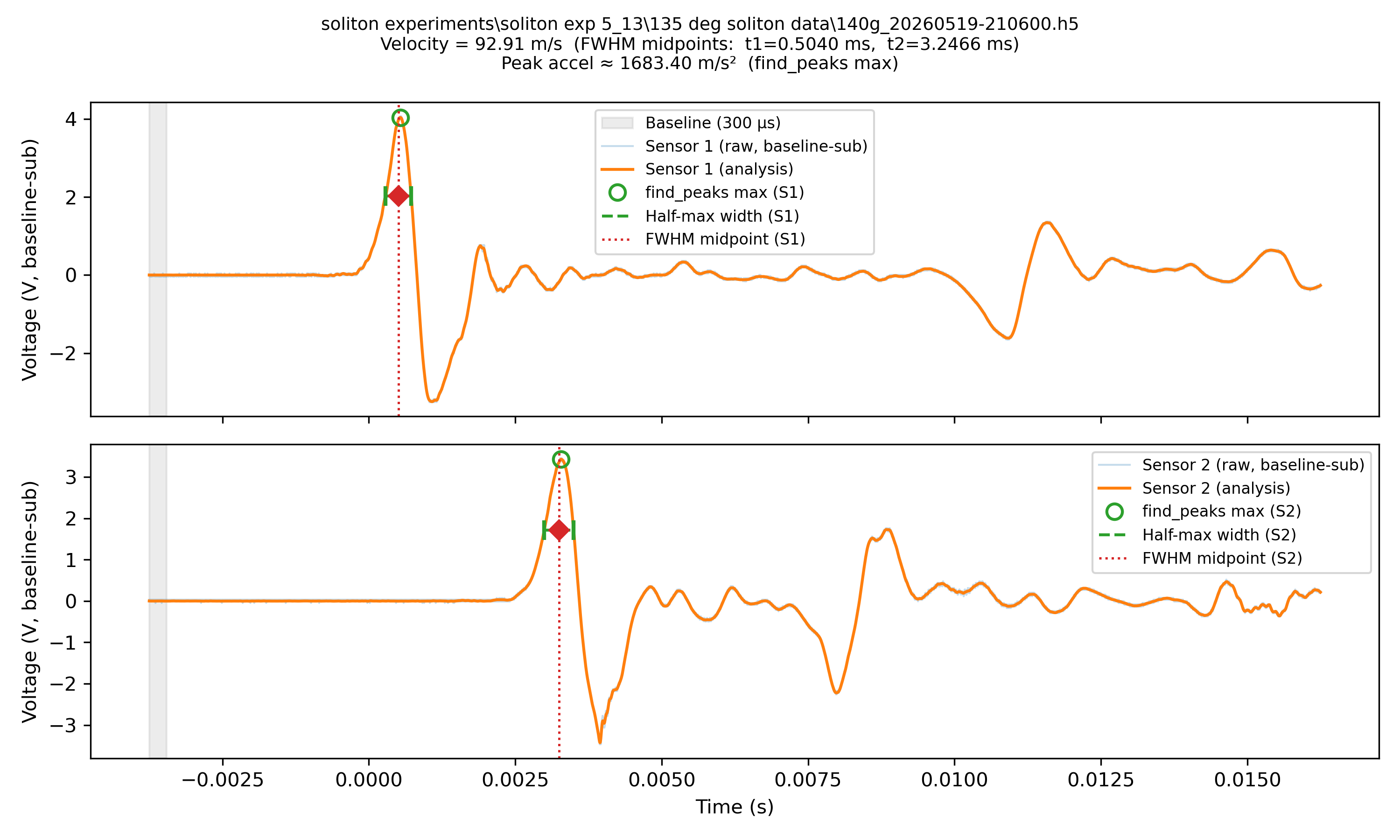
data analysis/soliton experiments/soliton exp 5_13/135 deg soliton data/140g_20260519-210600_analysis.png
