KuroBean/SURF-git/data analysis/soliton experiments/soliton exp 5_13/135 deg soliton data/200g_20260519-212937_analysis.png

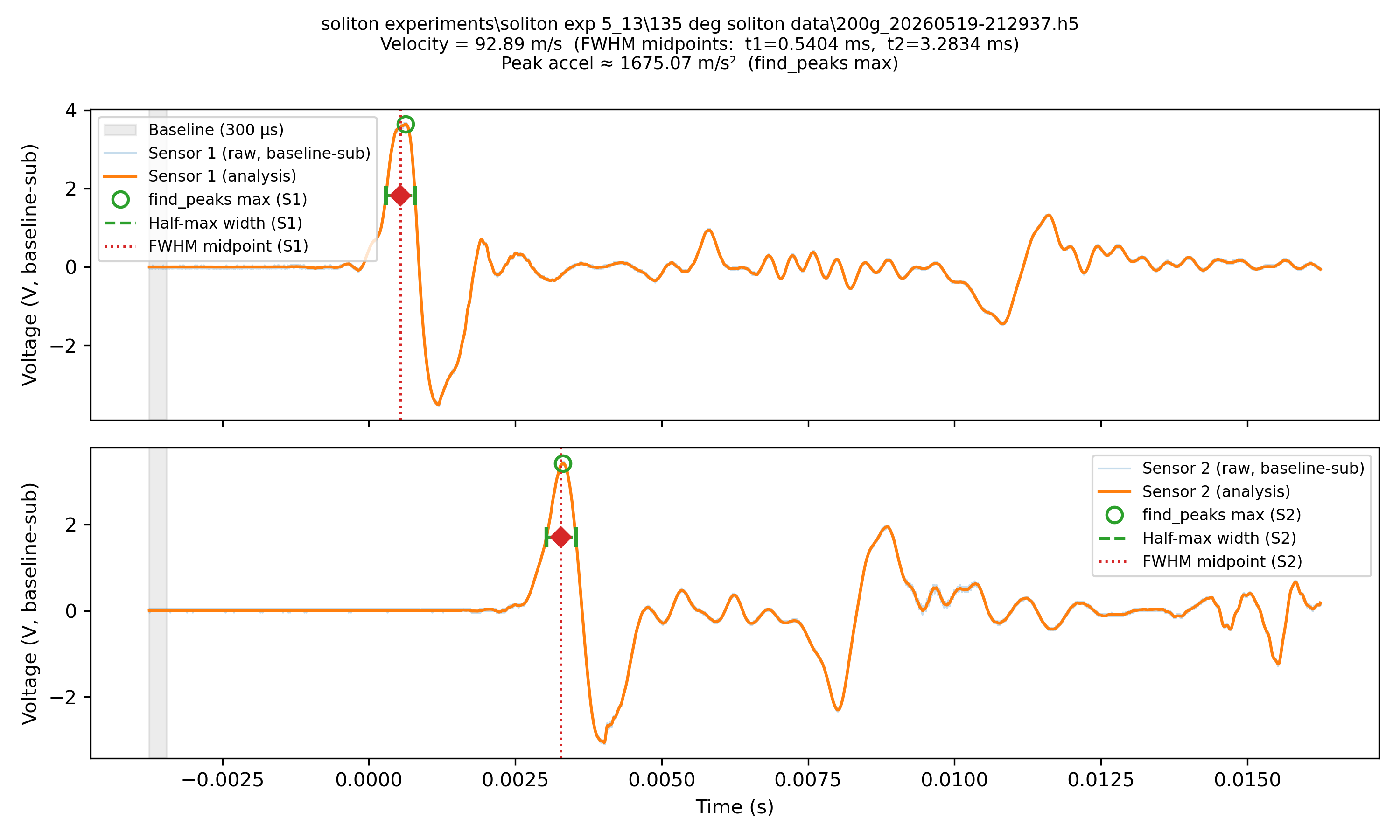
data analysis/soliton experiments/soliton exp 5_13/135 deg soliton data/200g_20260519-212937_analysis.png
