KuroBean/SURF-git/data analysis/soliton experiments/soliton exp 5_13/150 deg soliton data/80g_20260519-205750.png

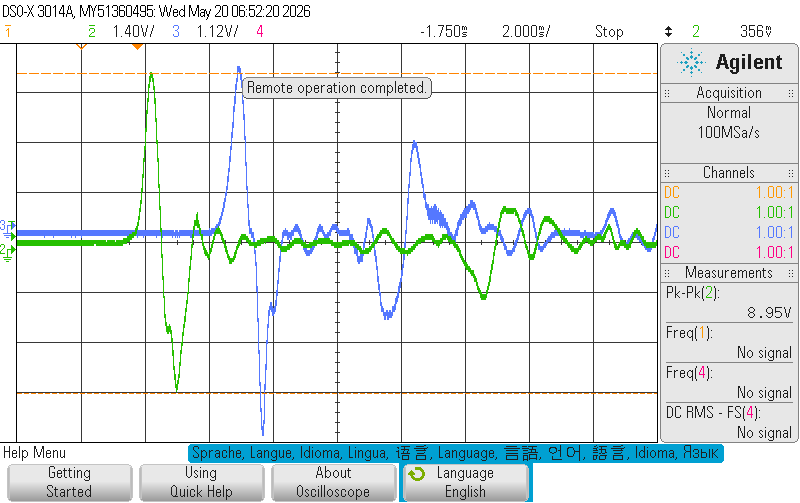
data analysis/soliton experiments/soliton exp 5_13/150 deg soliton data/80g_20260519-205750.png
