KuroBean/SURF-git/data analysis/soliton experiments/soliton exp 5_13/150 deg soliton data/200g_20260519-213617_analysis.png

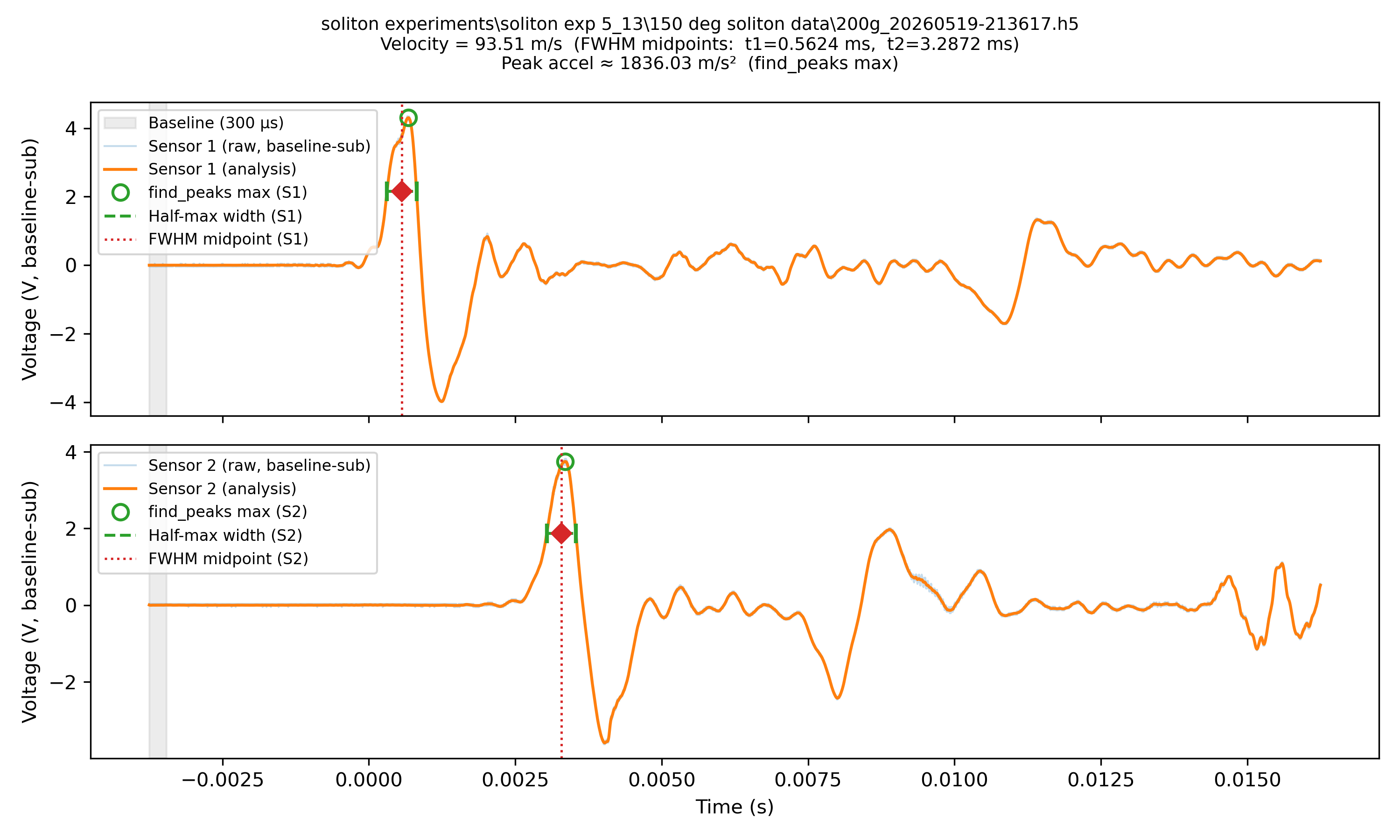
data analysis/soliton experiments/soliton exp 5_13/150 deg soliton data/200g_20260519-213617_analysis.png
