KuroBean/SURF-git/data analysis/soliton experiments/soliton exp 5_13/150 deg soliton data/200g_20260519-213640.png

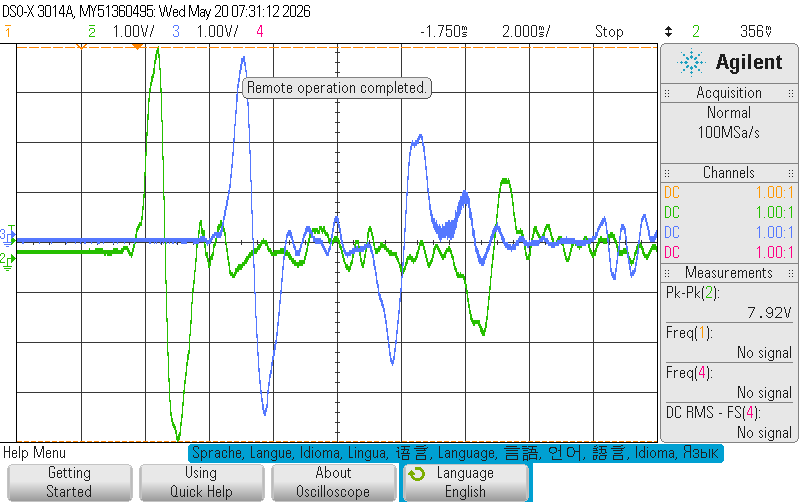
data analysis/soliton experiments/soliton exp 5_13/150 deg soliton data/200g_20260519-213640.png
