KuroBean/SURF-git/data analysis/soliton experiments/soliton exp 5_13/soliton_vel_vs_accel_80g.png

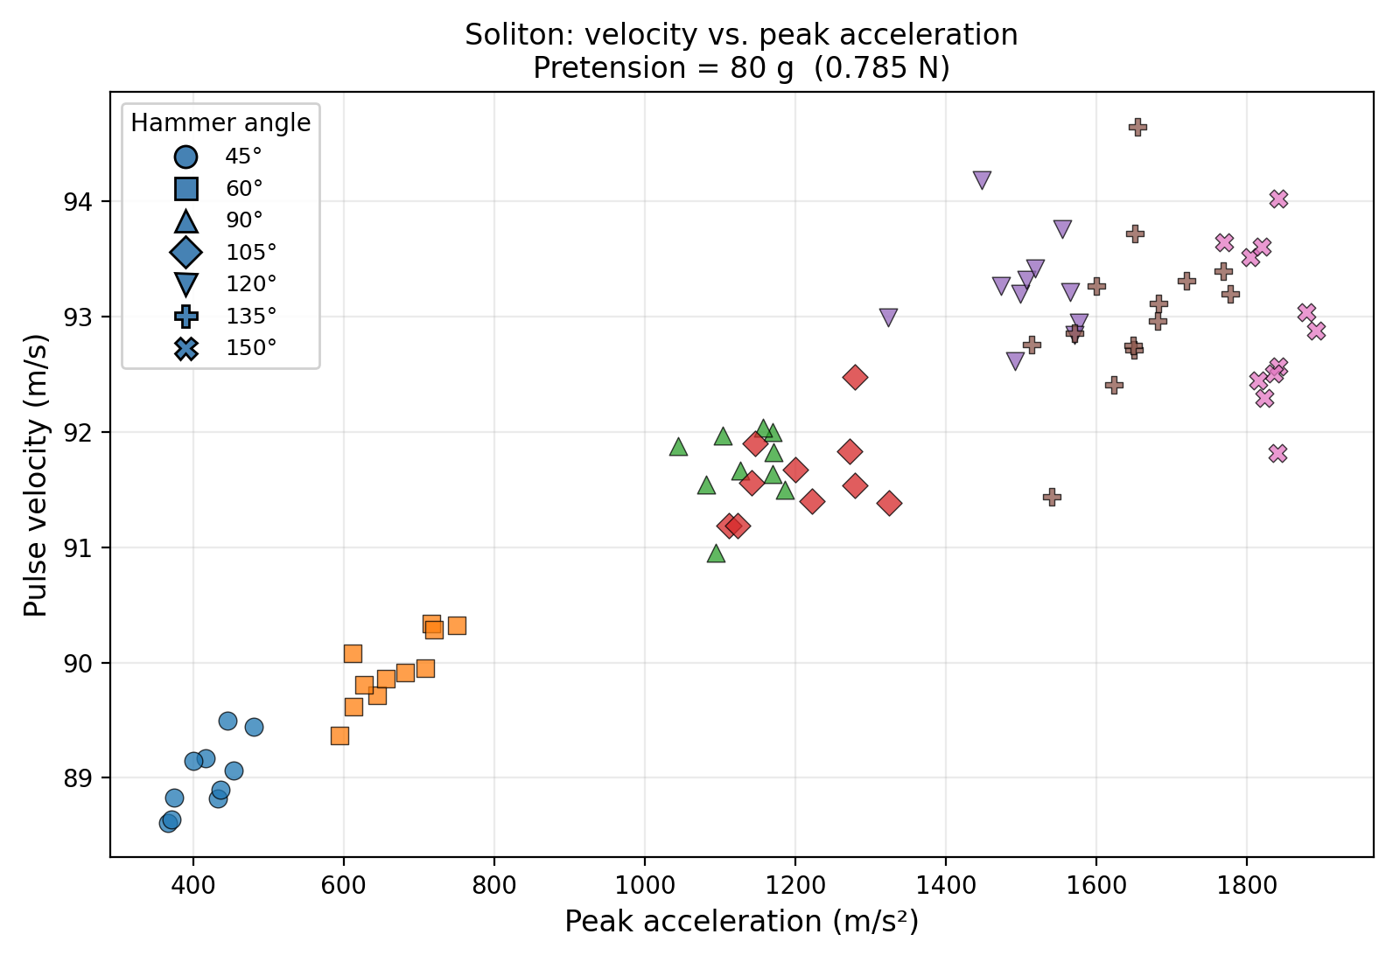
data analysis/soliton experiments/soliton exp 5_13/soliton_vel_vs_accel_80g.png
