KuroBean/SURF-git/data analysis/soliton experiments/soliton exp 6_20 farther sensors/90 deg/200g_20260620-161550.png

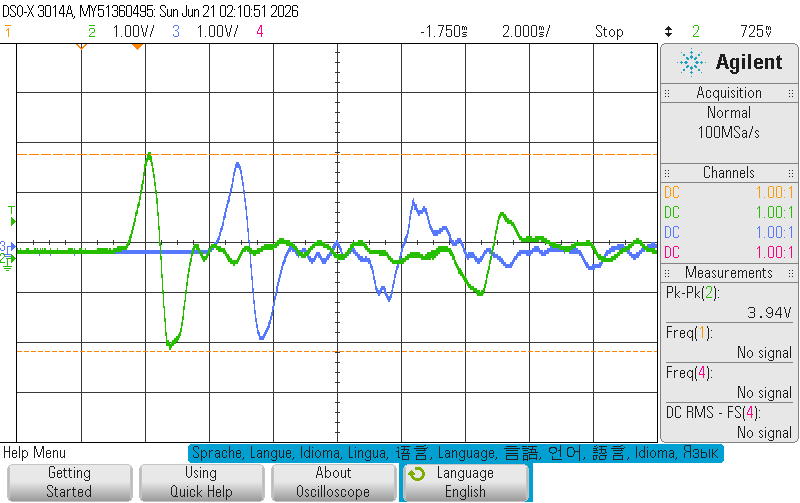
data analysis/soliton experiments/soliton exp 6_20 farther sensors/90 deg/200g_20260620-161550.png
