KuroBean/SURF-git/data analysis/soliton experiments/soliton exp 6_20 farther sensors/135 deg/200g_20260620-153746.png

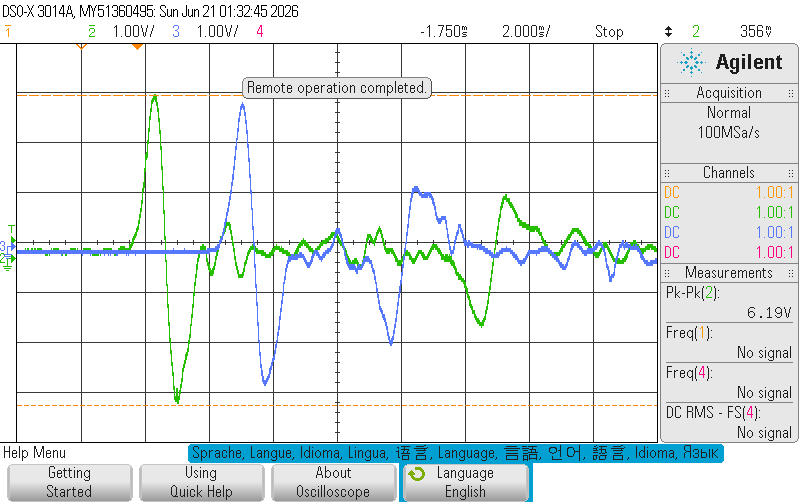
data analysis/soliton experiments/soliton exp 6_20 farther sensors/135 deg/200g_20260620-153746.png
