KuroBean/SURF-git/data analysis/soliton experiments/soliton exp 6_20 farther sensors/150 deg 4V/200g_20260620-155714.png

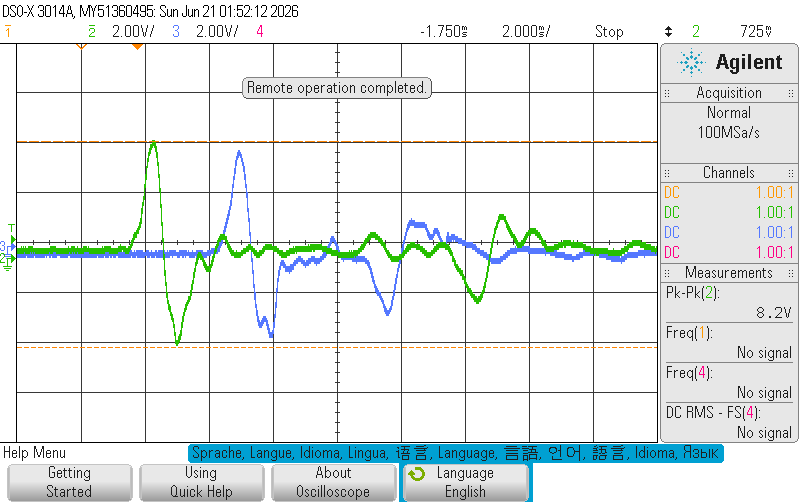
data analysis/soliton experiments/soliton exp 6_20 farther sensors/150 deg 4V/200g_20260620-155714.png
