KuroBean/SURF-git/data analysis/soliton experiments/soliton exp 6_20 farther sensors/soliton_vel_vs_accel_200g.png

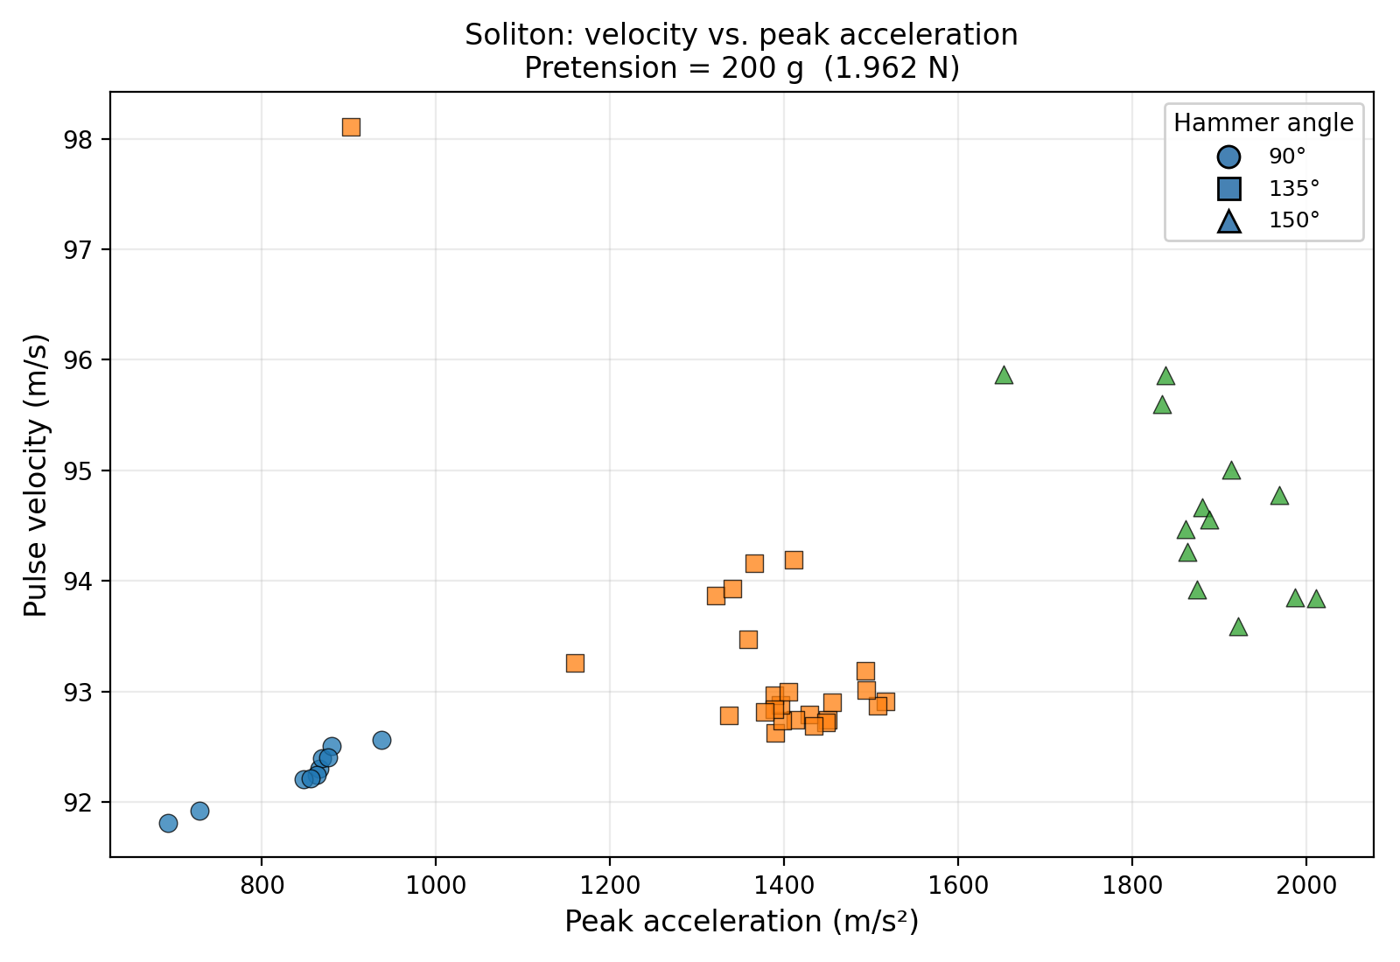
data analysis/soliton experiments/soliton exp 6_20 farther sensors/soliton_vel_vs_accel_200g.png
