KuroBean/SURF-git/data analysis/surf 2025 exp/8_12 accelerometer test/acc in sensor 1 glued/glued sensor 2, unglued 1.png

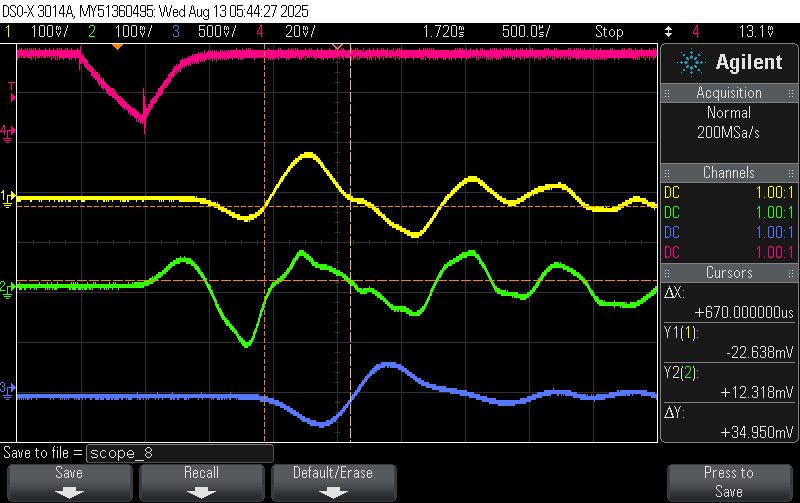
data analysis/surf 2025 exp/8_12 accelerometer test/acc in sensor 1 glued/glued sensor 2, unglued 1.png
