KuroBean/SURF-git/data analysis/surf 2025 exp/8_12 accelerometer test/junction regular piezo sensors/acc on sensor 3, piezo on sensor 2.png

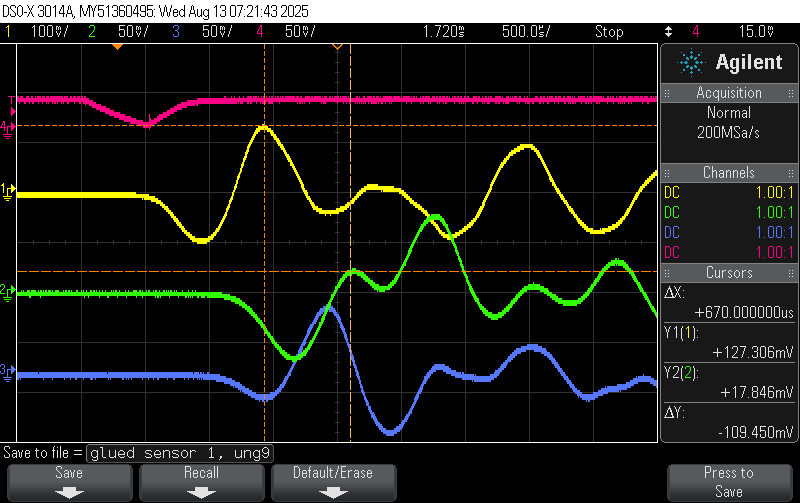
data analysis/surf 2025 exp/8_12 accelerometer test/junction regular piezo sensors/acc on sensor 3, piezo on sensor 2.png
