KuroBean/SURF-git/my writing/interim report 1.pdf

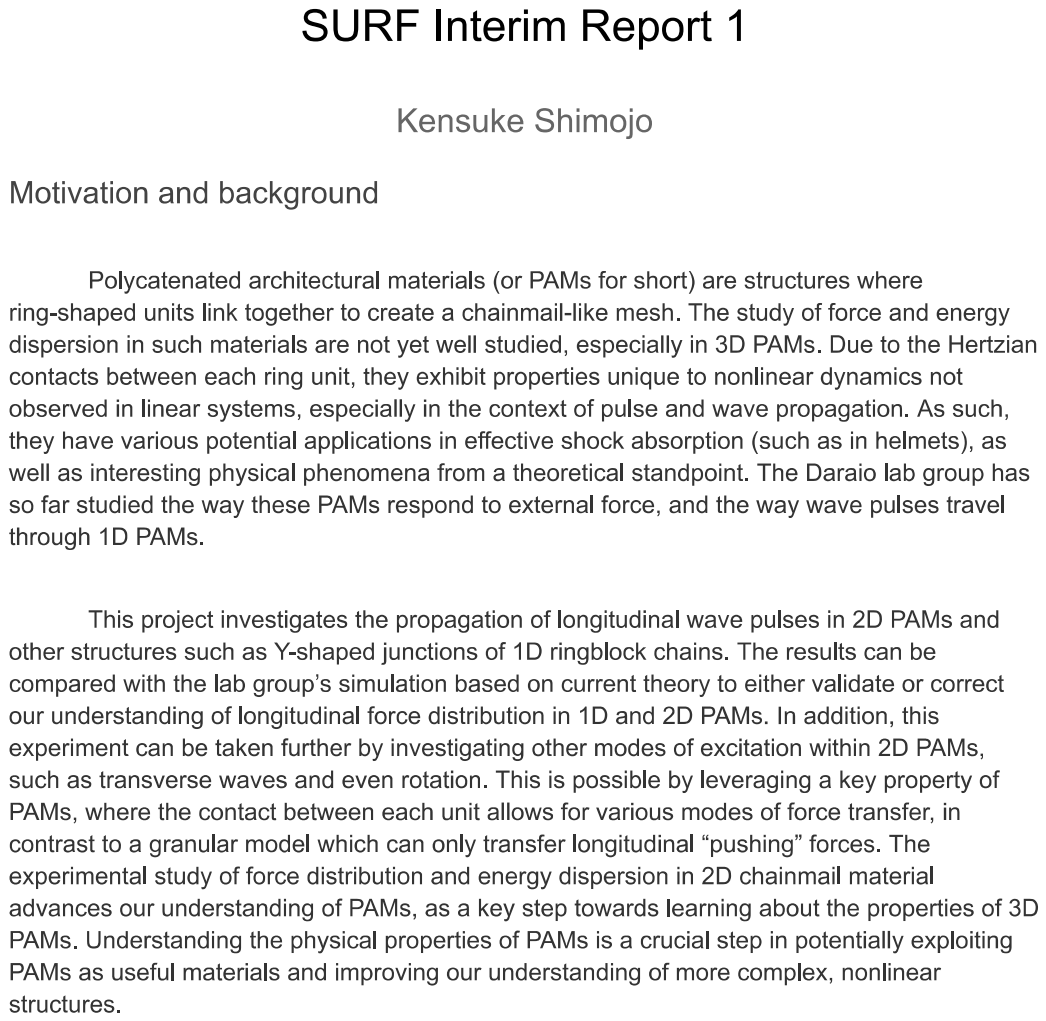
[picture p291: page 1]

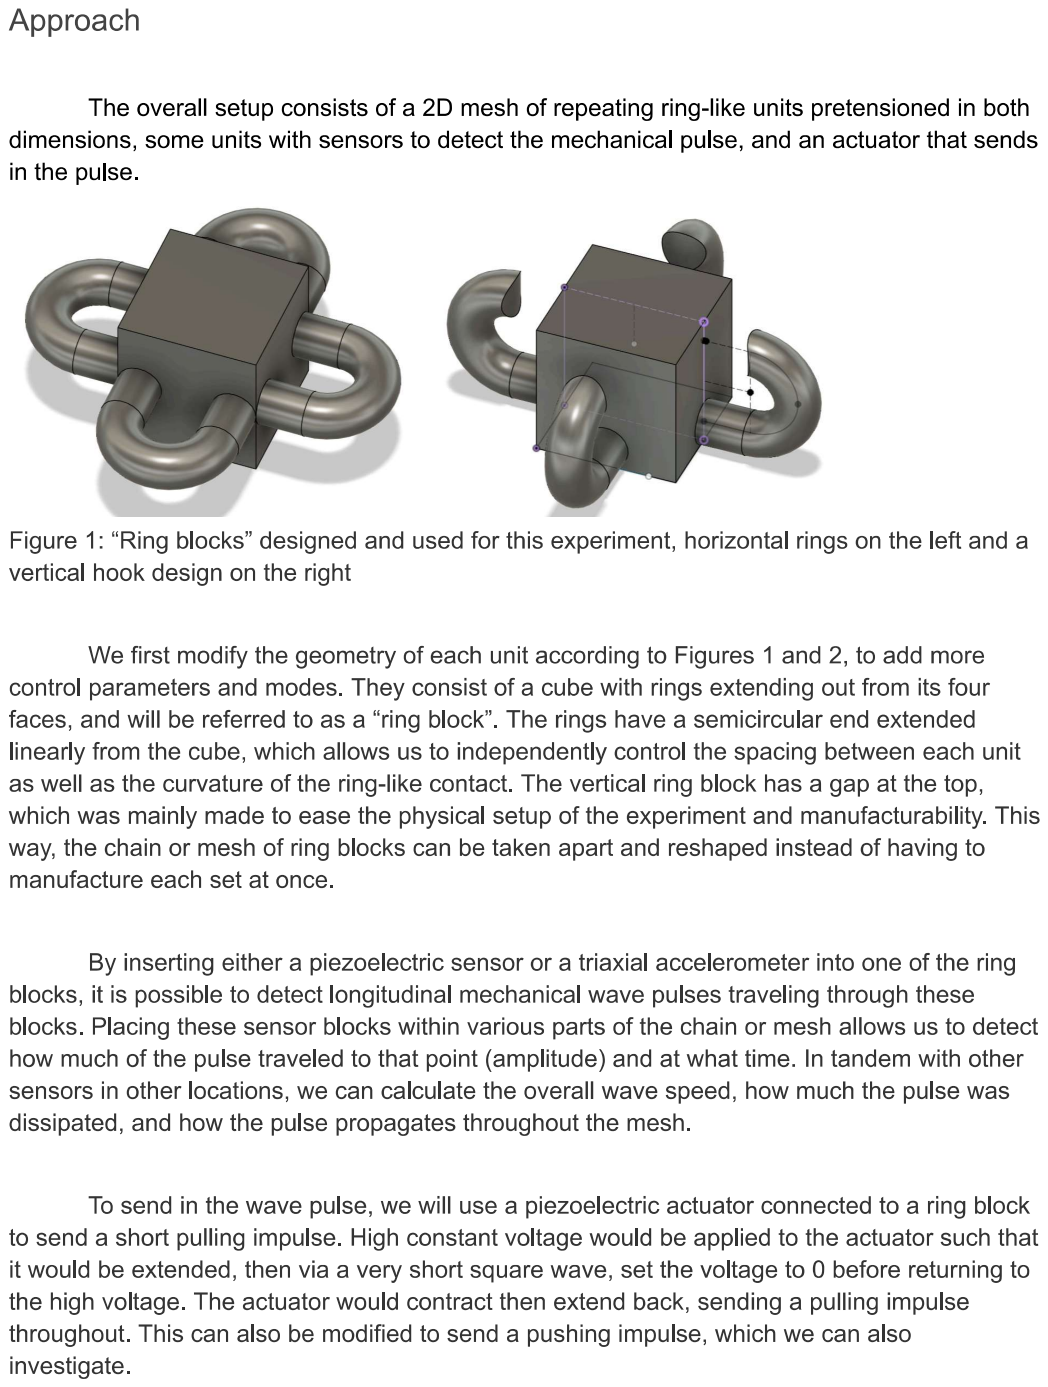
[picture p292: page 2]

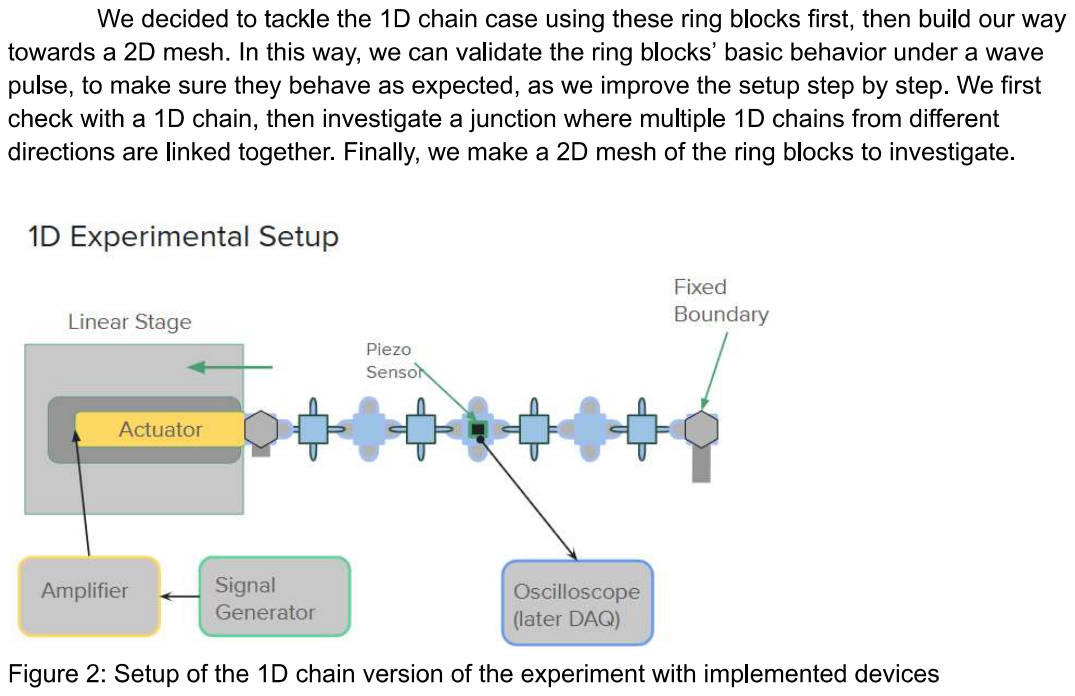
[picture p293: page 3]

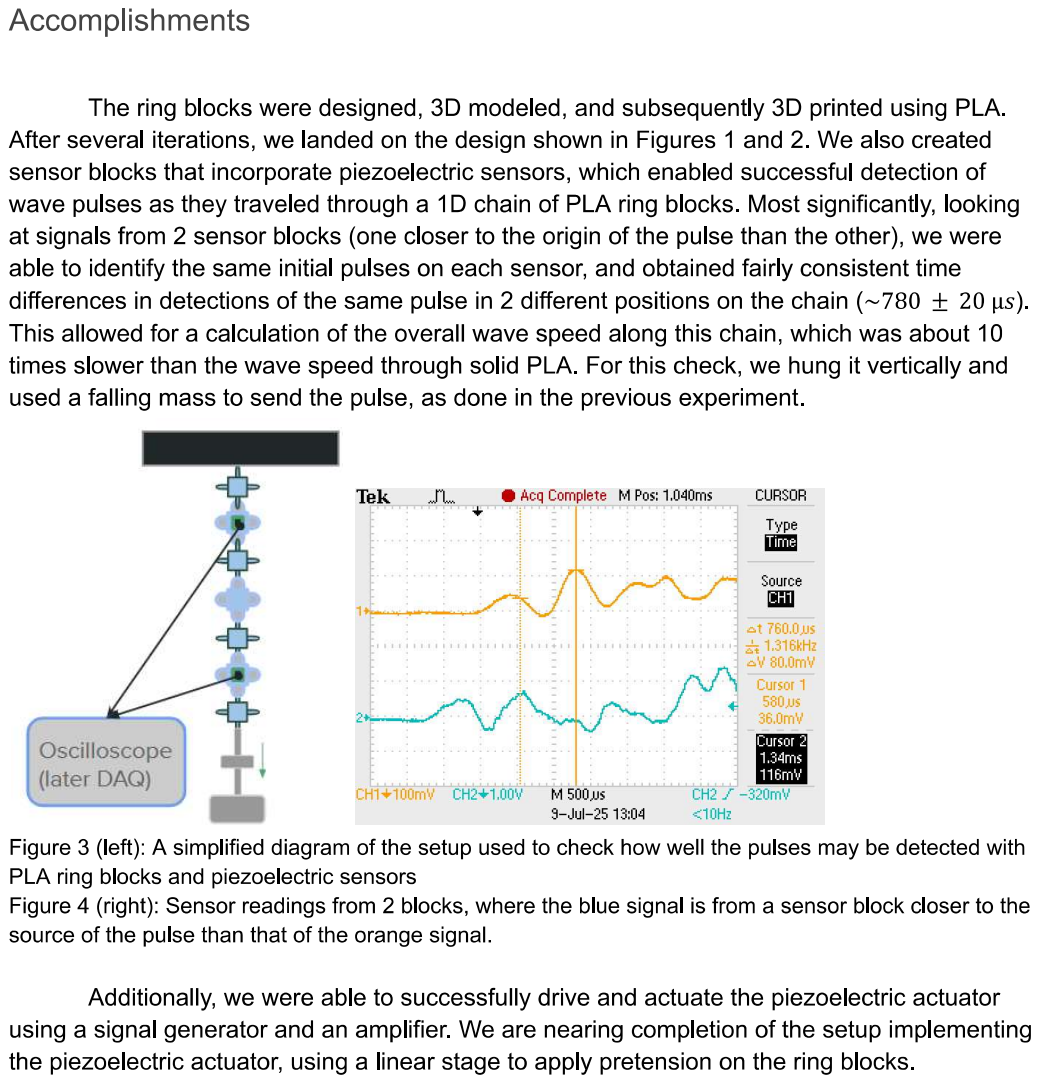
[picture p294: page 4]

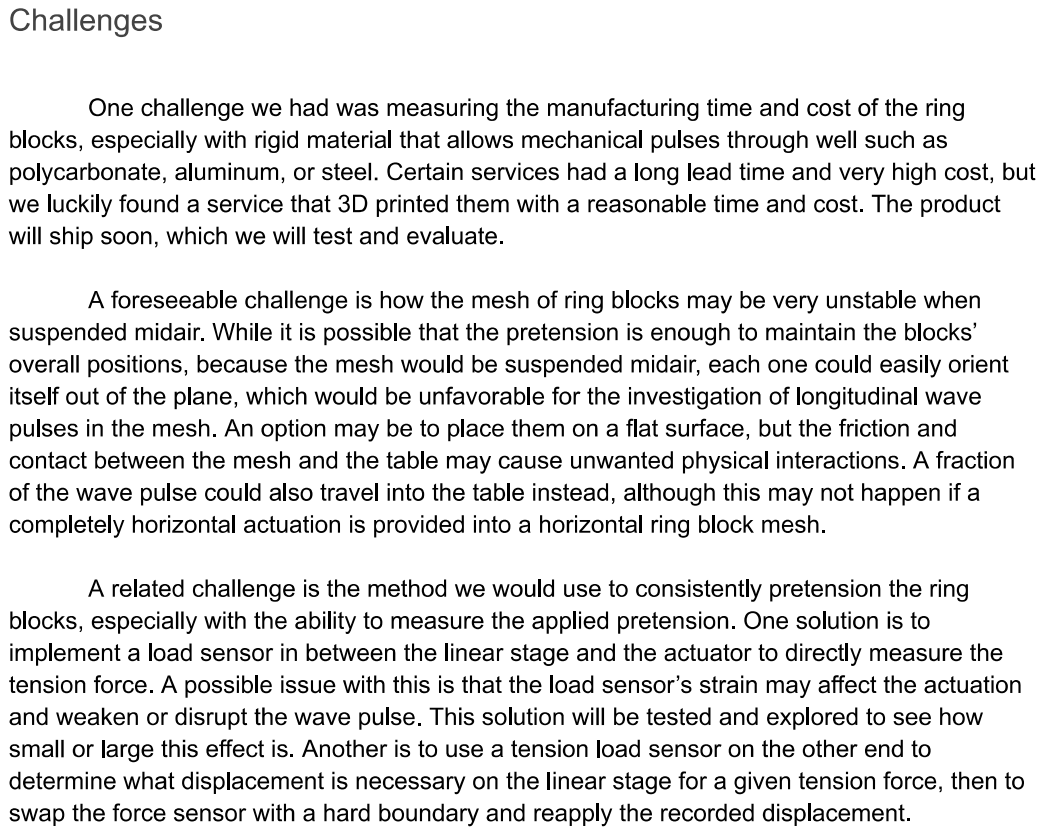
[picture p295: page 5]
