KuroBean/SURF-git/(commit log)

2025-08-16 everything up to 8_16
    [2 and 3 linked rings for testing.3mf, 2d block actuator verti boundary block v2.stl, 5 block boundary 1 hole thick v4.stl, 5 block boundary 3 hole thick v3.stl, F0000CH1.CSV, F0000CH2.CSV, F0001CH1.CSV, F0001CH2.CSV]
2025-08-20 new good 8_19 data and multi file tenison plotting
    [SCOPE_01.csv, SCOPE_02.csv, SCOPE_03.csv, SCOPE_04.csv, SCOPE_05.csv, SCOPE_06.csv, SCOPE_07.csv, SCOPE_11.csv]
2025-08-21 data smoothening added
    [SCOPE_07.csv, SCOPE_08.csv, SCOPE_09.csv, SCOPE_10.csv, SCOPE_11.csv, pulse_velocity_fit_params_simple_sqrt.csv, pulse_velocity_vs_p1.csv, pulse_velocity_vs_p4.csv]
2025-08-23 amplitude changing exp data code working + data
    [pulse_velocity_vs_p1.csv, pulse_velocity_vs_pretension_multi_avg.csv, pulse_velocity_vs_pretension_multi_details.csv, scope_10.csv, scope_11.csv, scope_12.csv, scope_14.csv, scope_16.csv]
2025-08-27 symmetric junction experiment data added
    symmetric junction data experiment
    [scope_02.csv, scope_03.csv, scope_04.csv, scope_05.csv, scope_06.csv, scope_09.csv, scope_10.csv, scope_11.csv]
2025-09-01 restructuring code files
    [pulse_velocity_vs_pretension_multi_avg.csv]
2025-09-18 extra amplitude experiment data and amplitude exp code update
    [junction_angle_details.csv, junction_angle_summary.csv, scope_02.csv, scope_04.csv, scope_05.csv, scope_06.csv, scope_07.csv, scope_08.csv]
2025-09-19 batch velocity vs amplitude saves images of each peak pos
    [velocity_vs_peak_accel_details.csv]
2025-09-23 amplitude experiment 9_22 data
    [1.csv, 10_7_1.csv, 10_7_2.csv, 10_7_3.csv, 12_2_1.csv, 12_2_2.csv, 12_2_3.csv, 17_0_1.csv]
2025-09-23 data analysis with 9_22 amplitude exp data, manual actuation
    [1.csv, 42_0_1.csv, 42_0_2.csv, 42_0_3.csv, 63.csv, 64.csv, 65.csv, 66.csv]
2026-04-09 diag blocks + auto data collection
    [1D chain with tensioning acc hole (thin hook).stl, 1D chain with tensioning hole v1.stl, 1D chain with tensioning v6.stl, 1D diag ring block sensor hole v6.stl, 40 batch MAIN 8.2mm hole metal cube horizontal + vertical block 1d.3mf, 42 MAIN 11.5mm metal cube 1d block (only longer side fit.3mf, 6.65 after the incident metal cube sensor horizontal + vertical block 1d.stl, 8mm extrusion actuation bl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]
2026-04-21 angle limiter striker
    [Striker holder v5.stl, angle limiter angle ticks v2.stl, angle limiter v1.stl, striker hammer v6.stl]
2026-06-22 soliton experiment update
    new 3d files and data analysis code for soliton experiment setup (working with metal loaded units), along with data under soliton experiments folder in data analysis
    [angle limiter v3 min 45 deg smol and incremented.3mf, angle limiter v3 min 45 deg smol and incremented.stl, soliton_details.csv, soliton_summary.csv]
2026-06-22 folder reorganization for clarity
    [1.csv, 10_7_1.csv, 10_7_2.csv, 10_7_3.csv, 12_2_1.csv, 12_2_2.csv, 12_2_3.csv, 17_0_1.csv]
